flasch97/Gravity-Vehicle/Gravity Car Final 2/calculation arc.png

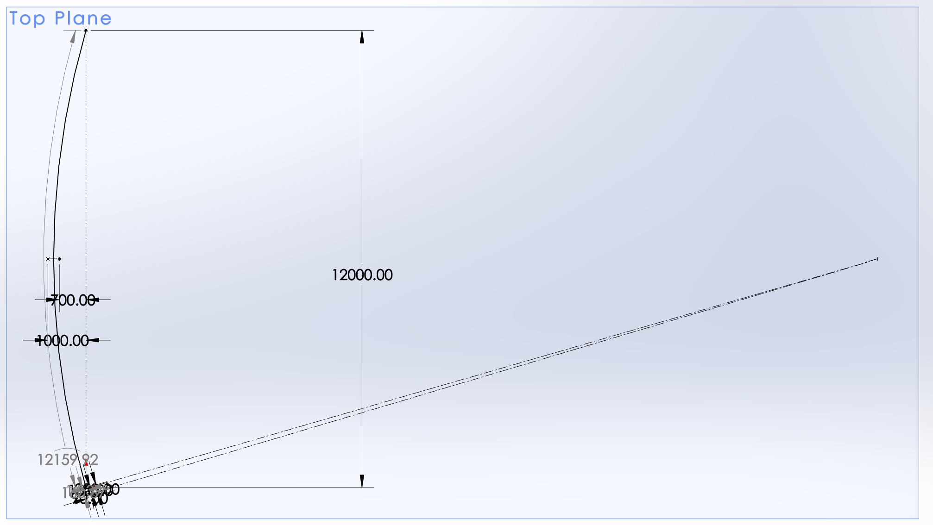
Gravity Car Final 2/calculation arc.png
