flasch97/Gravity-Vehicle/Gravity Car Final 2/calcualtion arc 2.PNG

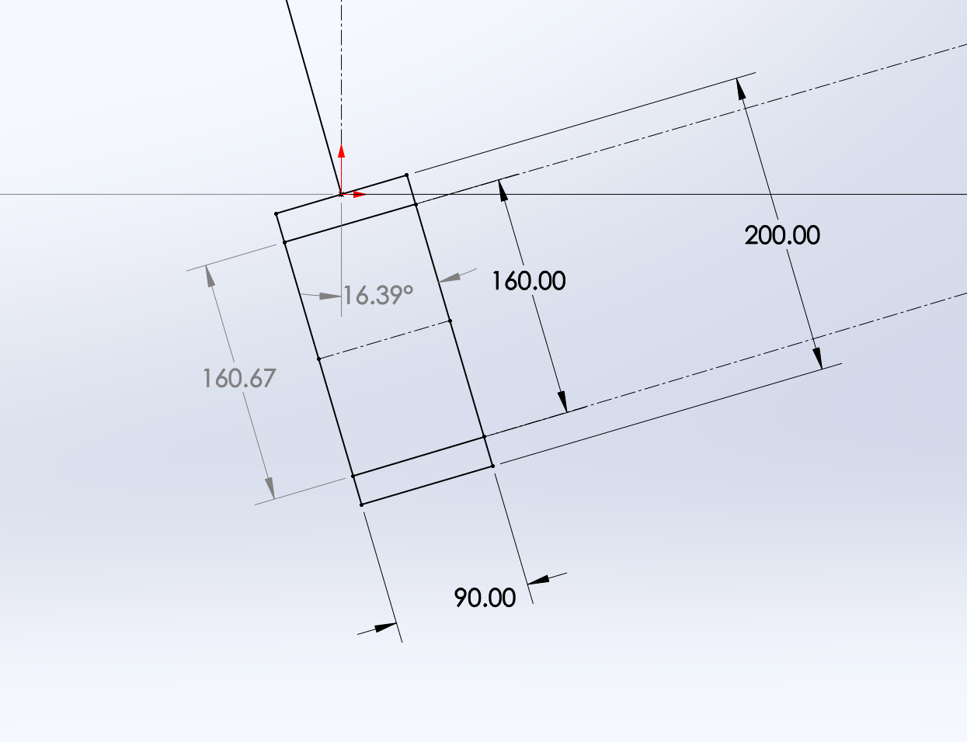
Gravity Car Final 2/calcualtion arc 2.PNG
