flasch97/Gravity-Vehicle/Gravity Car Final 1/FEA/PerformanceLog.txt

Number of Contacts: 0
Number of contact data: 0
