flasch97/Gravity-Vehicle/Gravity Car Final 2/FEA strain.png

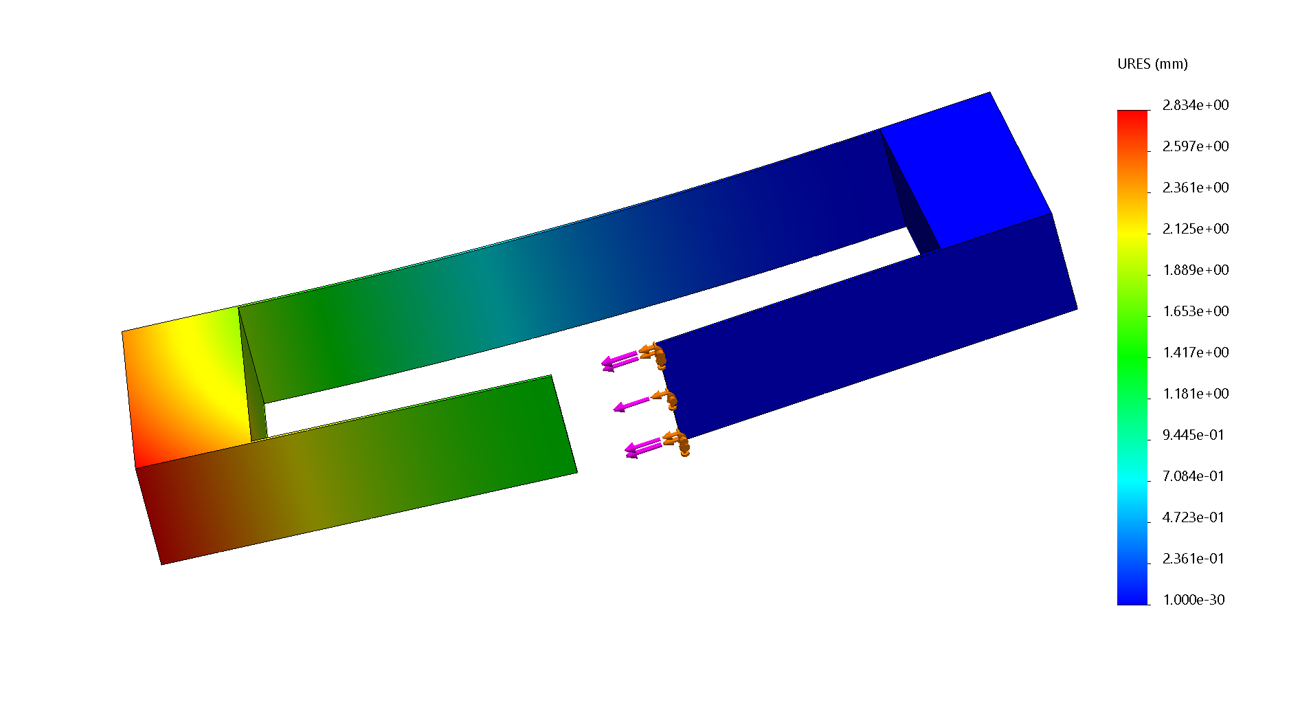
Gravity Car Final 2/FEA strain.png
