flasch97/Gravity-Vehicle/Gravity Car Final 2/FEA stress.PNG

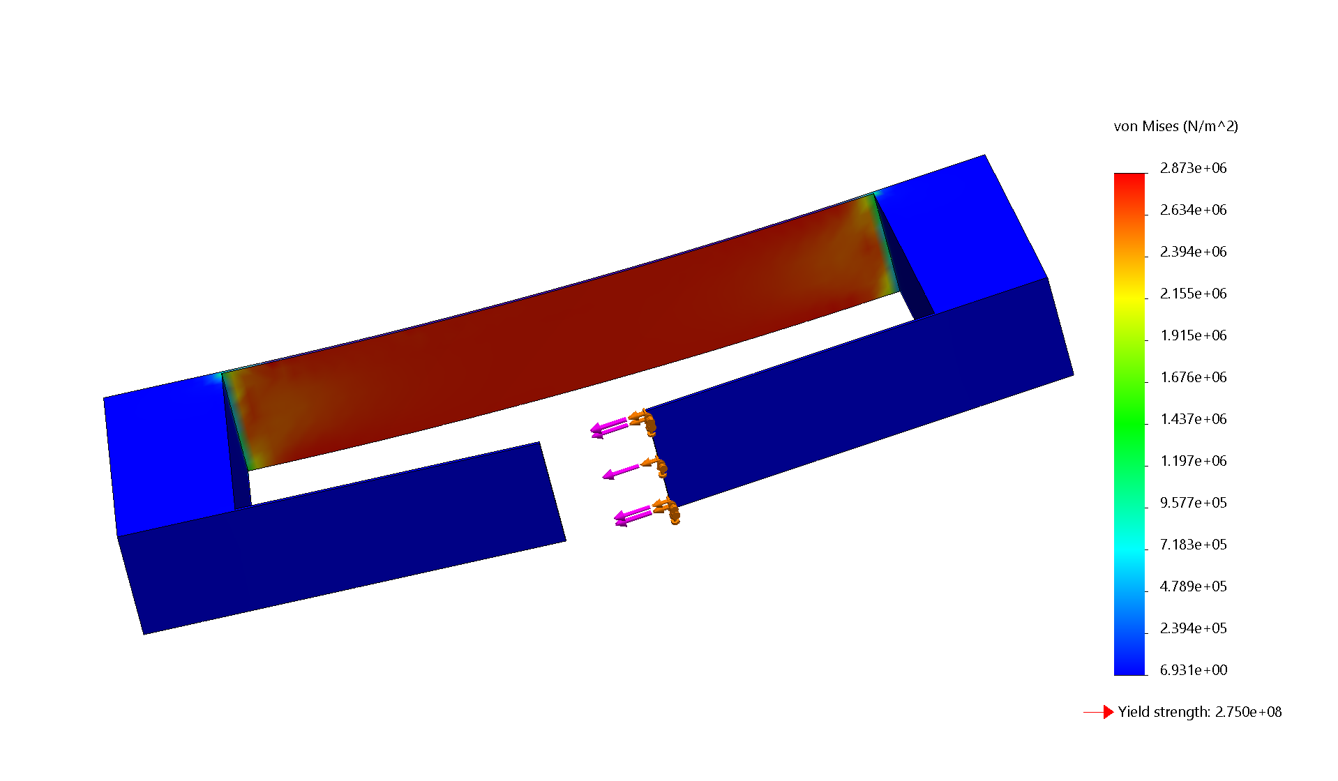
Gravity Car Final 2/FEA stress.PNG
