flasch97/Gravity-Vehicle/Gravity Car Final 2/Motion analysis.png

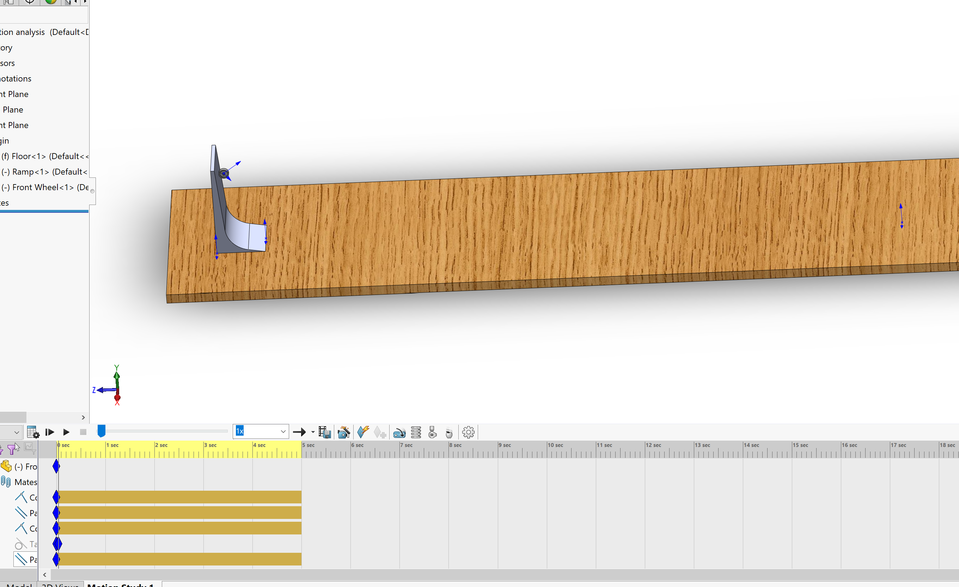
Gravity Car Final 2/Motion analysis.png
