flasch97/Gravity-Vehicle/Assembly car/Gravity car assembly (Split frame).SLDASM

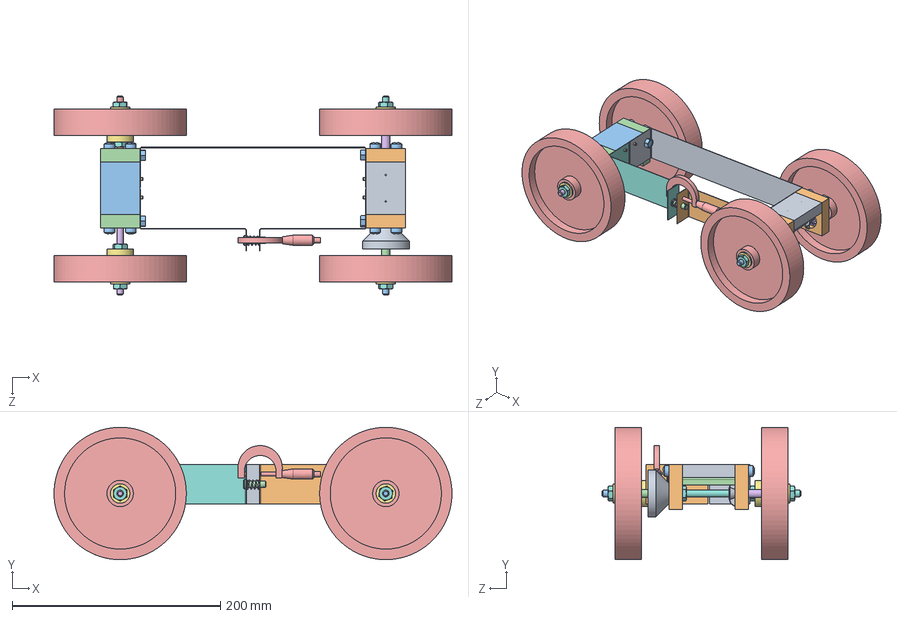
[picture p54: CAD file, 2019-11-20]
Assembly car/Gravity car assembly (Split frame).SLDASM
381.9 x 127.0 x 191.0 mm
Connection Front Suspention
suspension front x 2
fillister head screw_ai x 8
Slide Wing Nut
binding head screw_ai x 2
radial ball bearing_68_din x 3
muffle bearing x 2
threaded axle front
Adapter One-Way-Bearing
muffle one way bearing
threaded axle right wheel
muffle wheel right
Wheel x 4
muffle wheel left
flat washer type b regular_ai x 4
heavy hex jam nut_ai x 8
WING NUT 0.25 - 28
Frame 1 Front
Connection Rear Suspention
suspension rear x 2
threaded axle rear left
threaded axle rear right
muffle rear wheels x 2
Frame 1 Rear
Frame 2
dowel pin (hardened production)_ai x 4
hex screw_ai x 4
clevis pin_ai
micrometer
2022N161_MIL. SPEC. COMPRESSION SPRING
