flasch97/Gravity-Vehicle/Gravity Car Final 1/Assembly car/gravity car assembly.SLDASM

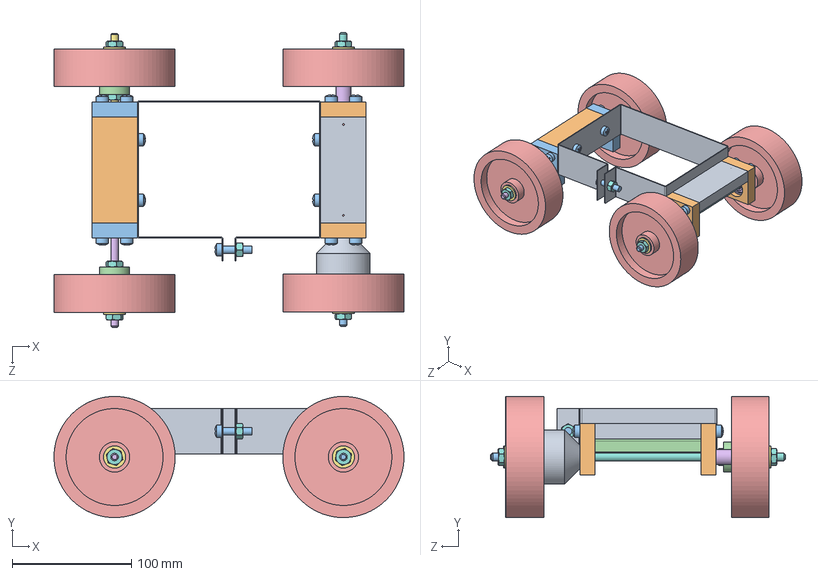
[picture p55: CAD file, 2019-11-04]
Gravity Car Final 1/Assembly car/gravity car assembly.SLDASM
293.5 x 101.6 x 247.1 mm
Connection Front Suspention
suspension front x 2
fillister head screw_ai x 13
Slide Wing Nut
binding head screw_ai x 2
radial ball bearing_68_din x 3
muffle bearing x 2
threaded axle front
Adapter One-Way-Bearing
muffle one way bearing
threaded axle right wheel
muffle wheel right
Front Wheel x 2
muffle wheel left
flat washer type b regular_ai x 4
heavy hex jam nut_ai x 6
Frame
Connection Rear Suspention
suspension rear x 2
muffle rear wheels x 2
Rear Wheel x 2
threaded axle rear right
threaded axle rear left
hex nut_ai
