flasch97/Gravity-Vehicle/Gravity Car Final 2/Motion Analysis/motion analysis.SLDASM

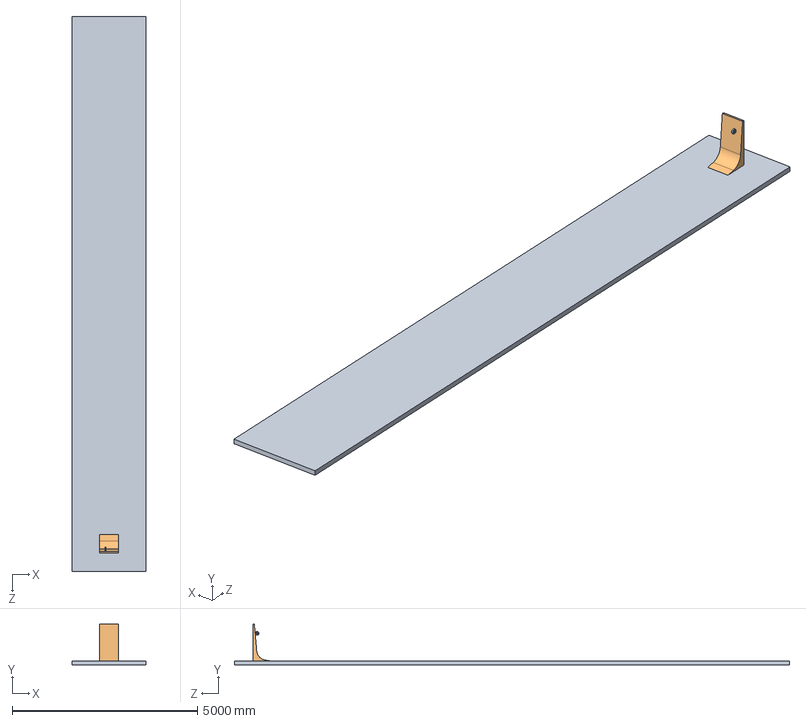
[picture p56: CAD file, 2019-11-22]
Gravity Car Final 2/Motion Analysis/motion analysis.SLDASM
2000.0 x 1101.6 x 15000.0 mm
Floor
Ramp
Front Wheel
