flasch97/Gravity-Vehicle/RampSight/Assemsight.SLDASM

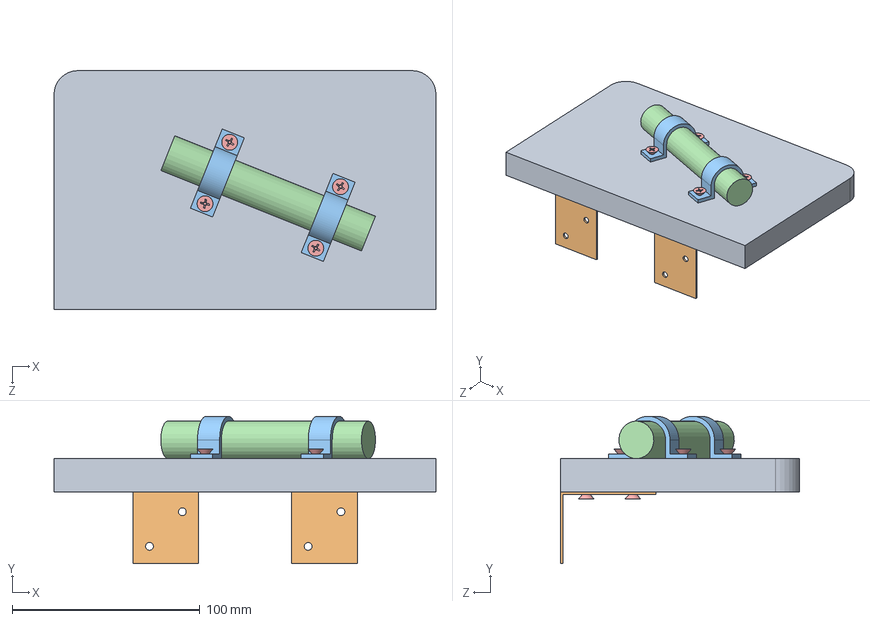
[picture p59: CAD file, 2019-12-05]
RampSight/Assemsight.SLDASM
203.2 x 78.4 x 127.0 mm
RampSight
screwangle x 2
LaserStrap x 2
laserpointereal
sightscrew x 8
