flasch97/Gravity-Vehicle/Motion Analysis/motion analysis.SLDASM

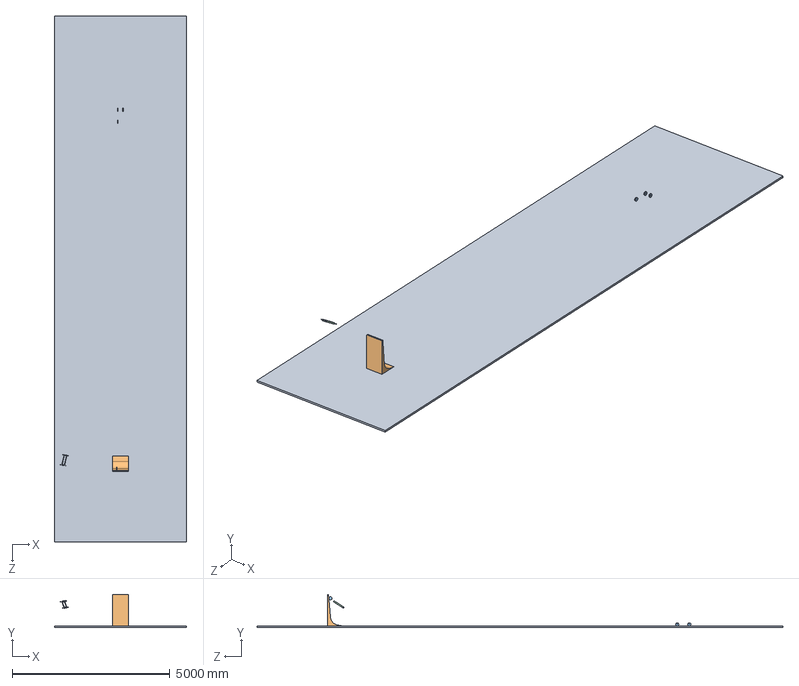
[picture p60: CAD file, 2019-12-02]
Motion Analysis/motion analysis.SLDASM
4194.1 x 1050.0 x 16654.9 mm
floor arc
Ramp
Front Wheel x 4
frame
