flasch97/Gravity-Vehicle/Ramp.SLDASM

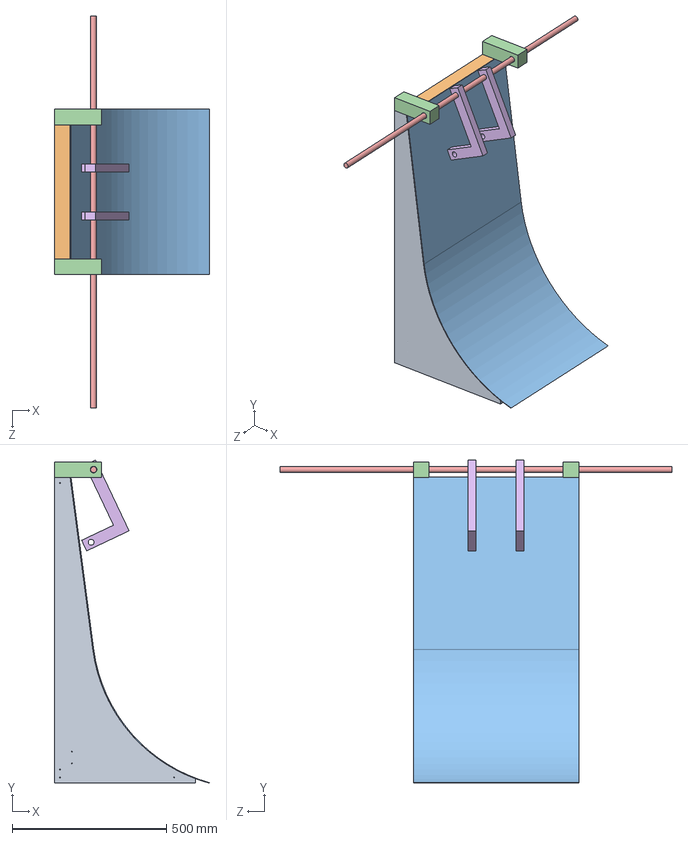
[picture p61: CAD file, 2019-11-13]
Ramp.SLDASM
503.0 x 1047.1 x 1270.0 mm
Ramp Right Side x 2
base support x 5
ramp top
Release support x 2
Release Dowel
RELEASE HOOK x 2
