flasch97/Gravity-Vehicle/Andrew's Files/Release Mechanism/Release Mechanism.SLDASM

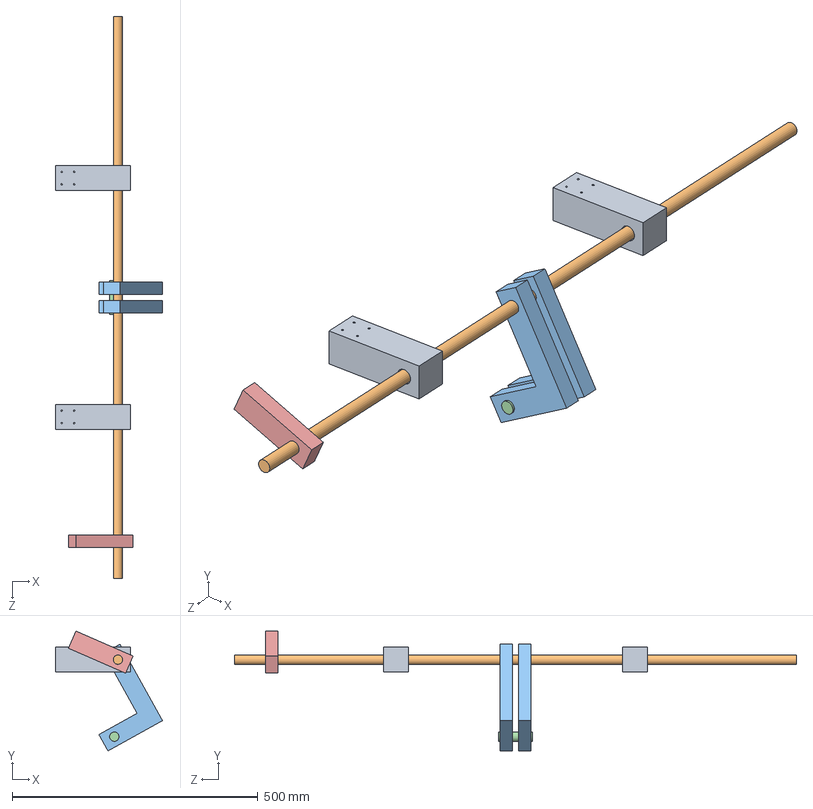
[picture p62: CAD file, 2019-12-05]
Andrew's Files/Release Mechanism/Release Mechanism.SLDASM
217.7 x 243.8 x 1143.0 mm
Release support x 2
Release Dowel
RELEASE HOOK x 2
Hook Dowel
Release Lever
