flasch97/Gravity-Vehicle/Gravity Car Final 2/Front Axle/Front Axle Assembly.SLDASM

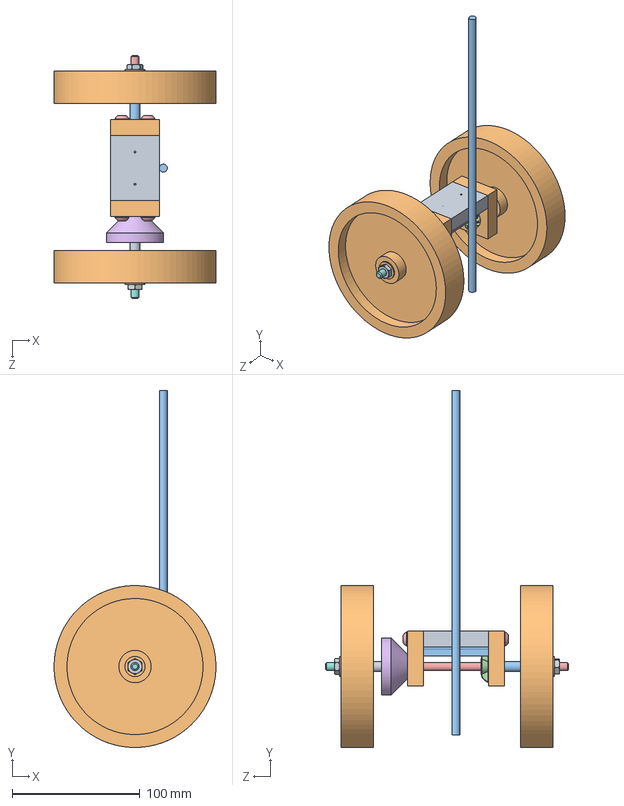
[picture p63: CAD file, 2019-11-21]
Gravity Car Final 2/Front Axle/Front Axle Assembly.SLDASM
127.0 x 280.0 x 190.9 mm
Connection Front Suspention
Suspension Front x 2
Slide Wing Nut
Muffle Bearing x 2
Threaded Axle Front Left
Adapter One-Way-Bearing
Muffle One-Way-Bearing
Threaded Axle Front Right
Muffle Wheel Right
Wheel x 2
Muffle Wheel Left
Wingnut
Button Head Hex Drive Screw 1-4-28 x 4
Button Head Hex Drive Screw 1-64 x 2
608 Ball Bearing x 2
One-Way-Bearing
Stainless Steel Thin Hex Nut 1-4-28 x 3
316 Stainless Steel Washer x 2
Wooden Rod
