flasch97/Gravity-Vehicle/Andrew's Files/Ramp/Ramp.SLDASM

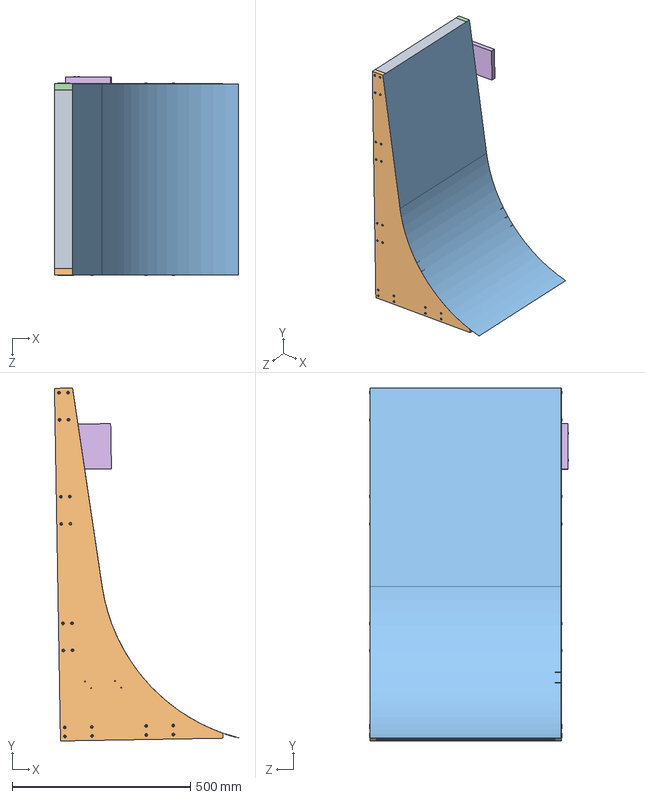
[picture p64: CAD file, 2019-12-05]
Andrew's Files/Ramp/Ramp.SLDASM
517.1 x 991.4 x 560.2 mm
base support x 5
Ramp Right Side
ramp top
Left Ramp Side
Smaller Wood Screw x 42
Position Marker
