flasch97/Gravity-Vehicle/Andrew's Files/Ramp/ramp top.SLDPRT

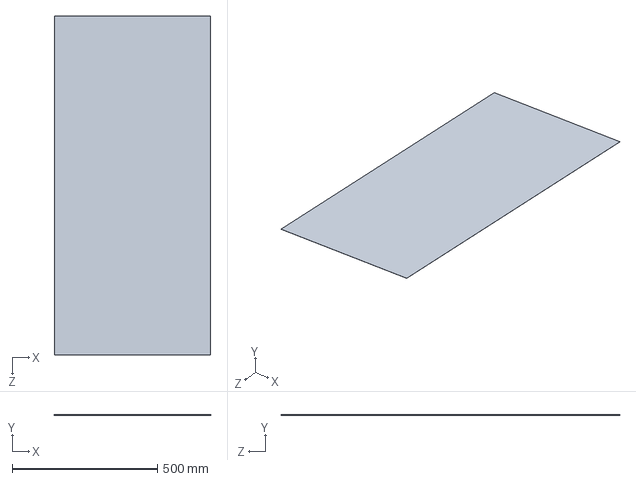
[picture p65: CAD file, 2019-12-05]
Andrew's Files/Ramp/ramp top.SLDPRT
536.4 x 0.317 x 1165.1 mm
