flasch97/Gravity-Vehicle/Andrew's Files/Release Mechanism/Release support.SLDPRT

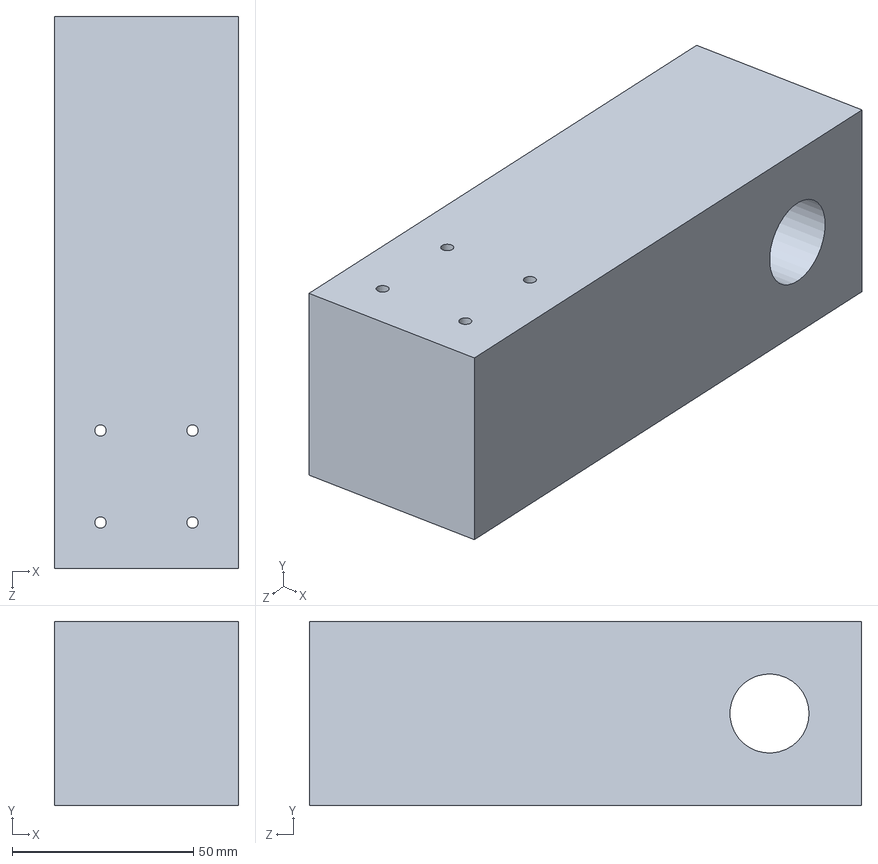
[picture p66: CAD file, 2019-12-05]
Andrew's Files/Release Mechanism/Release support.SLDPRT
50.8 x 50.8 x 152.4 mm
