flasch97/Gravity-Vehicle/Gravity Car Final 1/FEA/FEA.SLDPRT

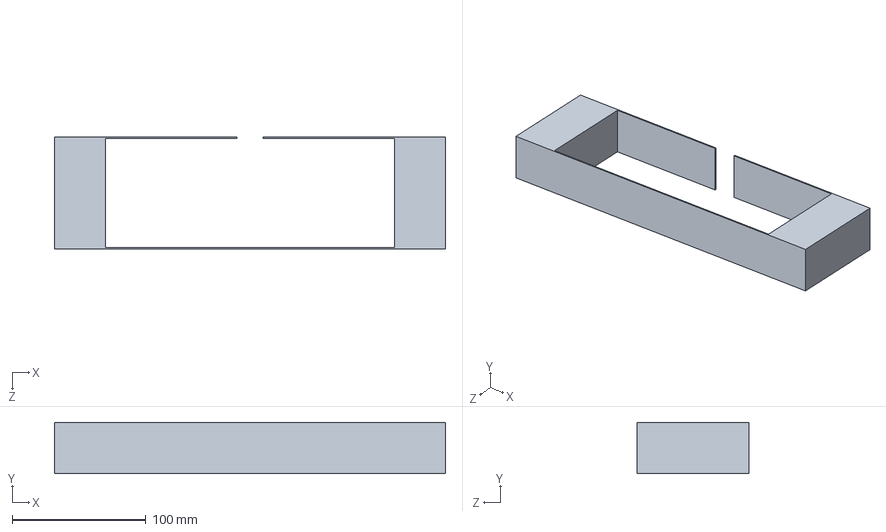
[picture p67: CAD file, 2019-11-20]
Gravity Car Final 1/FEA/FEA.SLDPRT
292.1 x 38.1 x 83.3 mm
