flasch97/Gravity-Vehicle/Gravity Car Final 2/Ramp left side/Side Ramp.SLDPRT

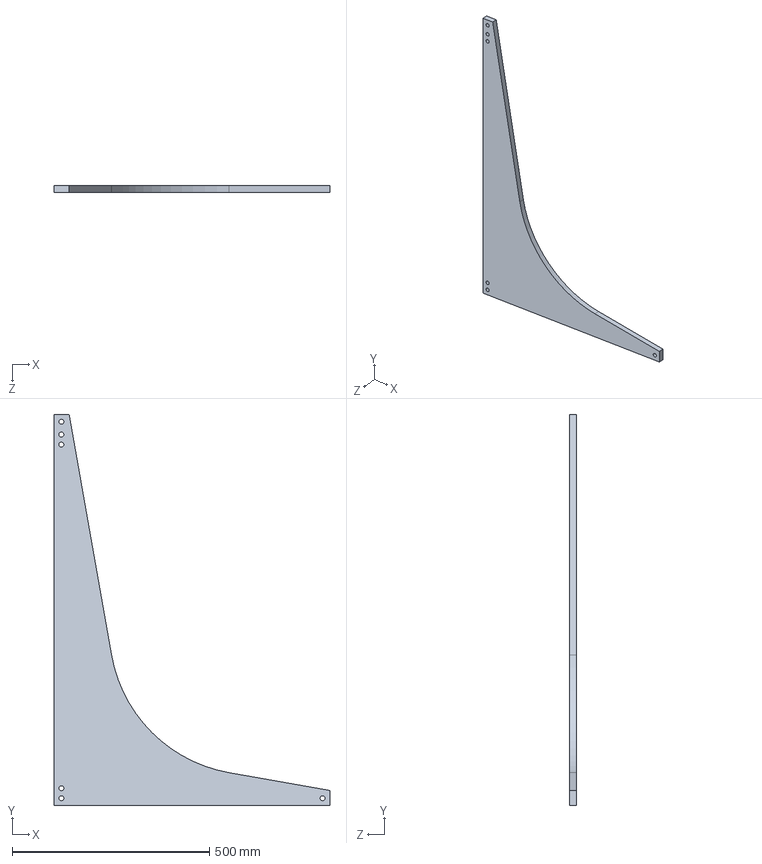
[picture p68: CAD file, 2019-11-06]
Gravity Car Final 2/Ramp left side/Side Ramp.SLDPRT
698.5 x 990.6 x 18.3 mm
