flasch97/Gravity-Vehicle/Gravity Car Final 2/Split frame/Compression Spring.SLDPRT

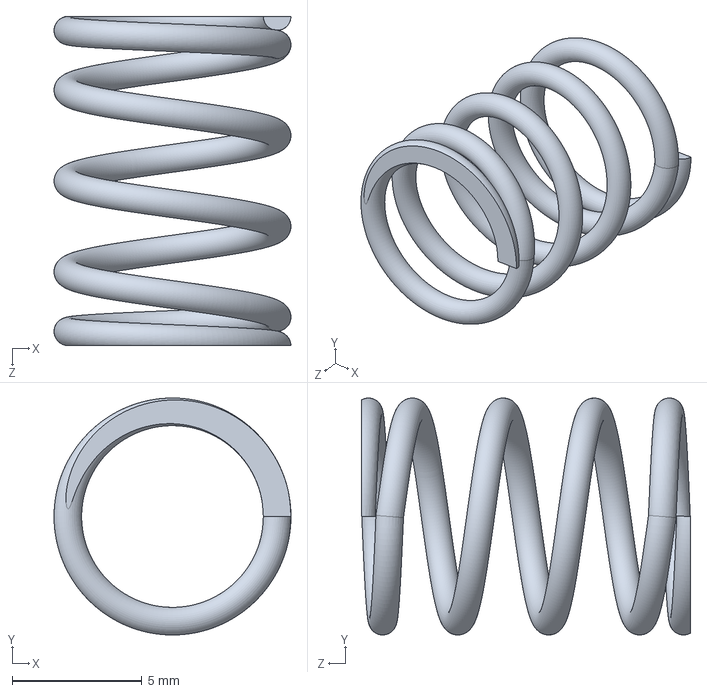
[picture p69: CAD file, 2019-11-22]
Gravity Car Final 2/Split frame/Compression Spring.SLDPRT
9.14 x 9.14 x 12.7 mm
