flasch97/Gravity-Vehicle/Motion Analysis/calculation arc.SLDPRT

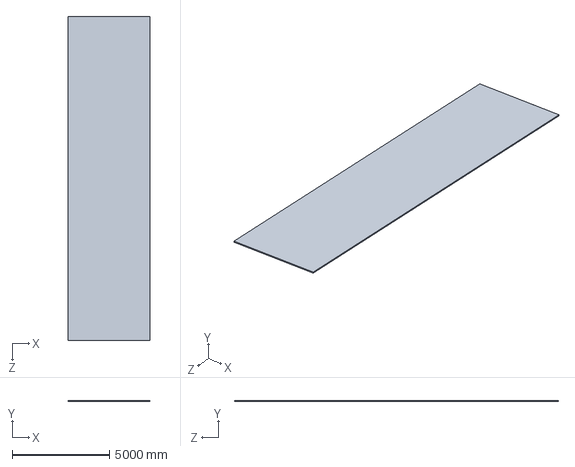
[picture p70: CAD file, 2019-12-02]
Motion Analysis/calculation arc.SLDPRT
4194.1 x 50.0 x 16654.9 mm
