flasch97/Gravity-Vehicle/Andrew's Files/Ramp/Ramp Right Side.SLDPRT

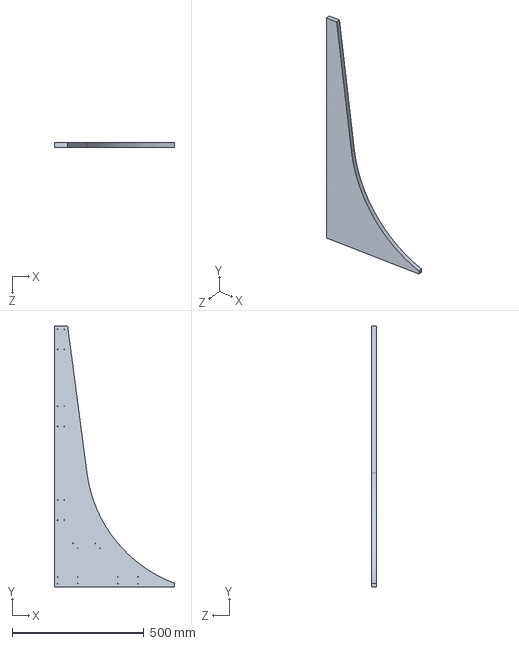
[picture p71: CAD file, 2019-12-05]
Andrew's Files/Ramp/Ramp Right Side.SLDPRT
457.2 x 990.6 x 18.3 mm
