flasch97/Gravity-Vehicle/Andrew's Files/Release Mechanism/RELEASE HOOK.SLDPRT

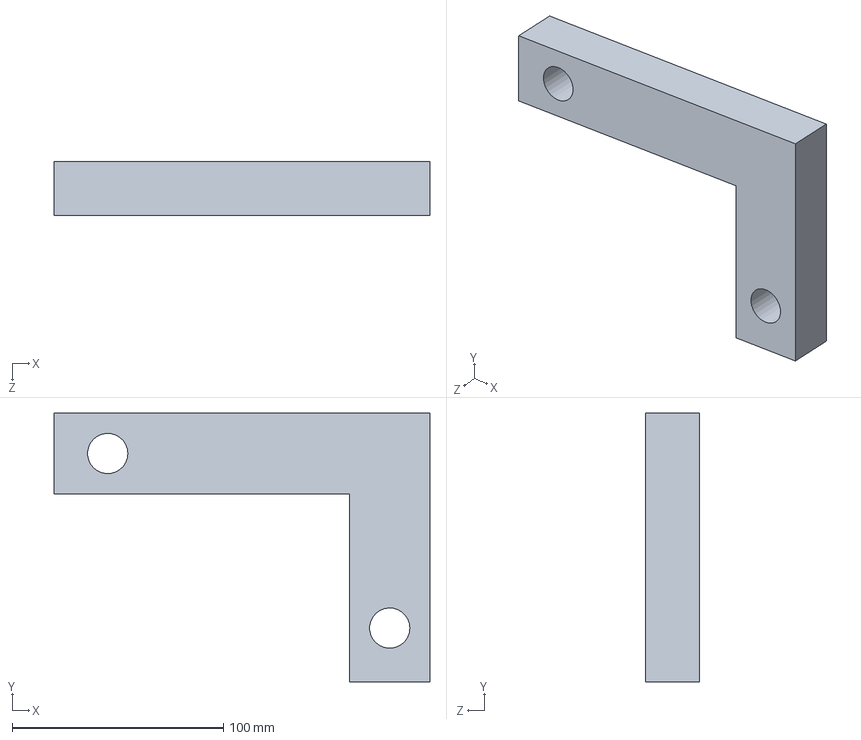
[picture p72: CAD file, 2019-12-05]
Andrew's Files/Release Mechanism/RELEASE HOOK.SLDPRT
177.8 x 127.0 x 25.4 mm
