flasch97/Gravity-Vehicle/Gravity Car Final 2/Front Axle/Compression Spring Break.SLDPRT

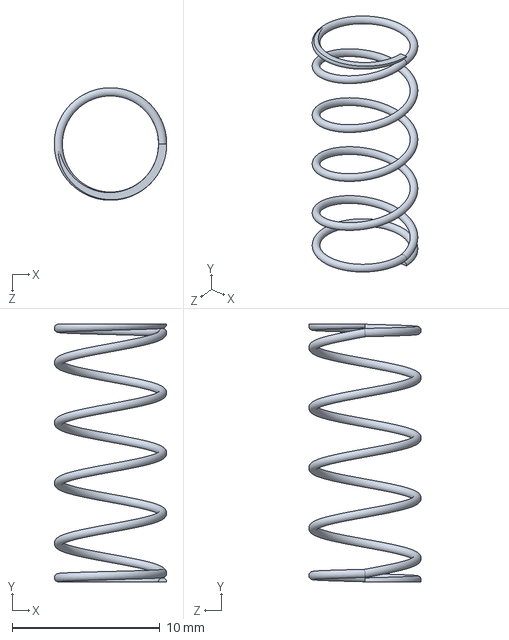
[picture p73: CAD file, 2019-12-04]
Gravity Car Final 2/Front Axle/Compression Spring Break.SLDPRT
7.62 x 17.5 x 7.62 mm
