flasch97/Gravity-Vehicle/Gravity Car Final 2/Motion Analysis/Floor.SLDPRT

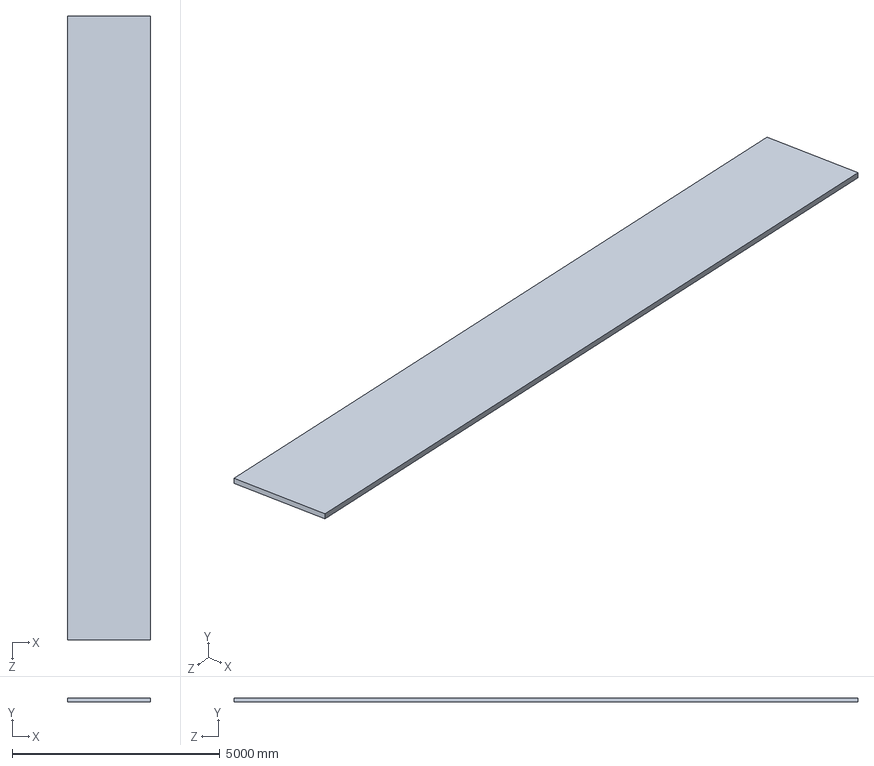
[picture p74: CAD file, 2019-11-10]
Gravity Car Final 2/Motion Analysis/Floor.SLDPRT
2000.0 x 101.6 x 15000.0 mm
