flasch97/Gravity-Vehicle/Gravity Car Final 2/Rear Axle/threaded axle rear right.SLDPRT

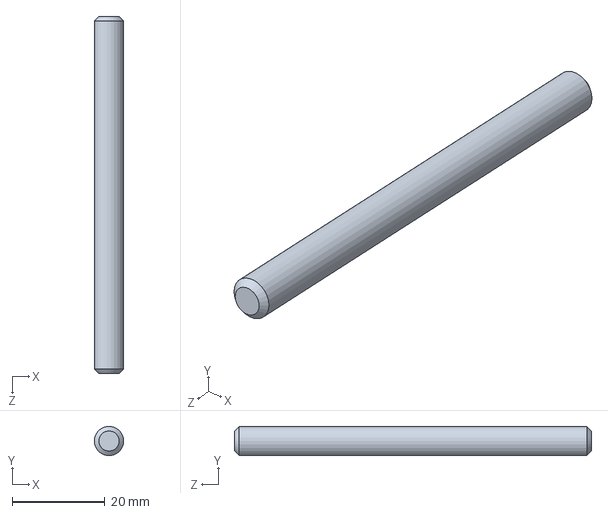
[picture p75: CAD file, 2019-11-22]
Gravity Car Final 2/Rear Axle/threaded axle rear right.SLDPRT
6.35 x 6.30 x 77.1 mm
