flasch97/Gravity-Vehicle/Gravity Car Final 2/Split frame/Dovel Pin.SLDPRT

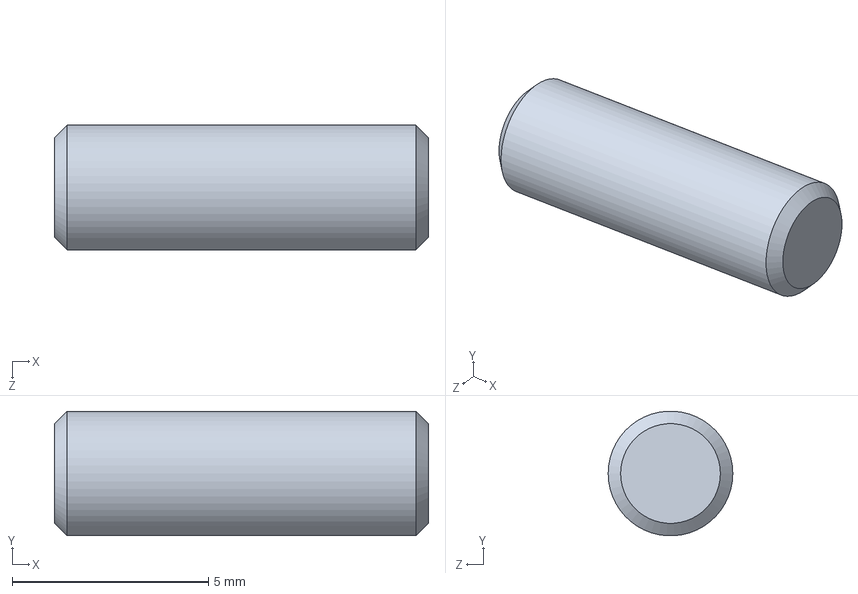
[picture p76: CAD file, 2019-11-22]
Gravity Car Final 2/Split frame/Dovel Pin.SLDPRT
9.52 x 3.17 x 3.17 mm
