flasch97/Gravity-Vehicle/laserpointereal.SLDPRT

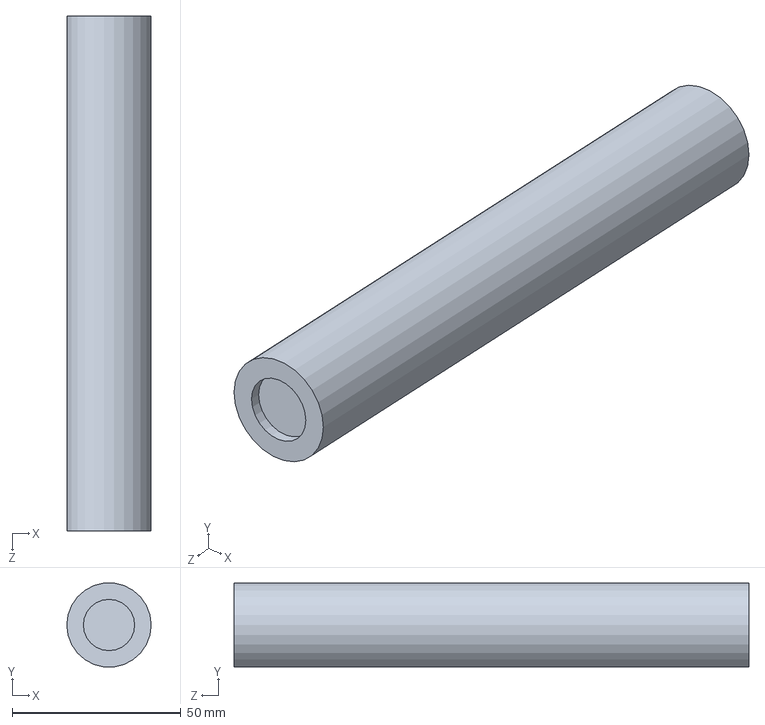
[picture p77: CAD file, 2019-11-17]
laserpointereal.SLDPRT
25.0 x 24.8 x 152.5 mm
