flasch97/Gravity-Vehicle/Rear Axle/threaded axle rear left.SLDPRT

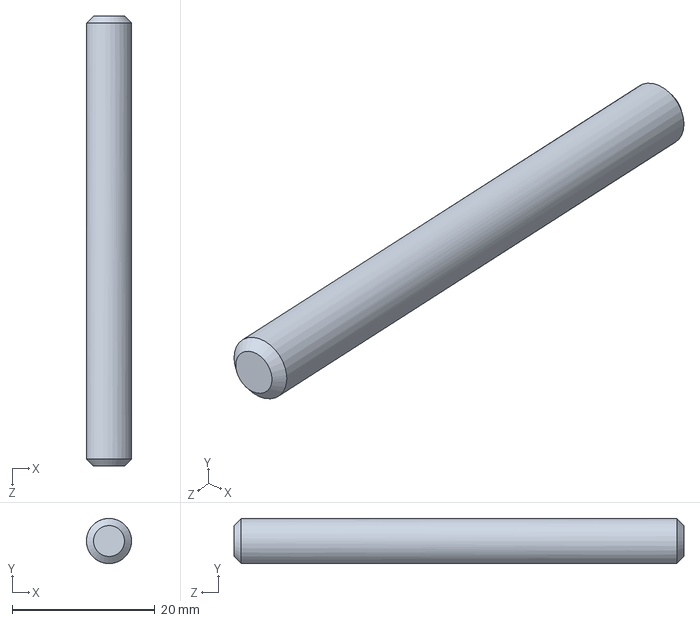
[picture p78: CAD file, 2019-11-17]
Rear Axle/threaded axle rear left.SLDPRT
6.35 x 6.34 x 63.1 mm
