flasch97/Gravity-Vehicle/Andrew's Files/Release Mechanism/Release Lever.SLDPRT

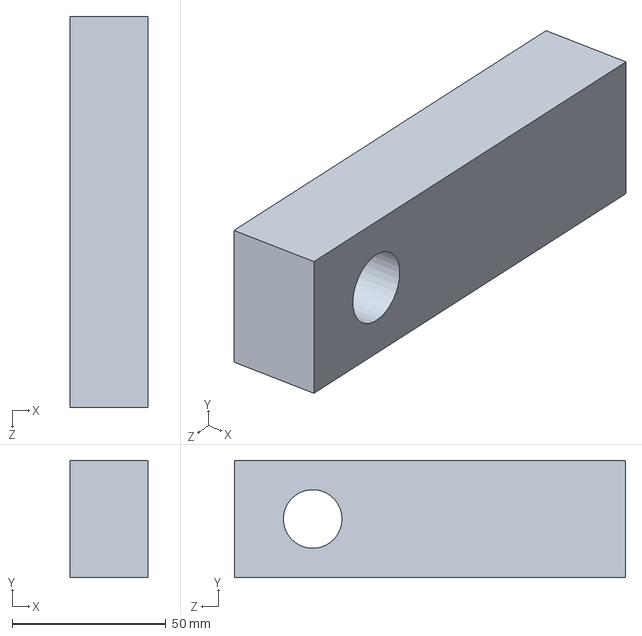
[picture p79: CAD file, 2019-12-05]
Andrew's Files/Release Mechanism/Release Lever.SLDPRT
25.4 x 38.1 x 127.0 mm
