flasch97/Gravity-Vehicle/Gravity Car Final 2/Motion Analysis/Ramp.SLDPRT

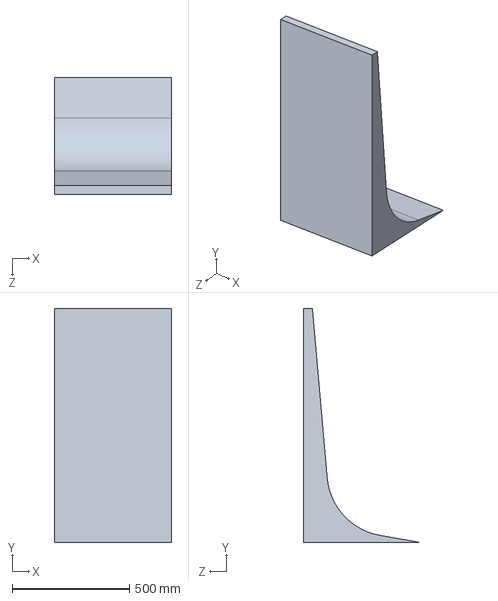
[picture p80: CAD file, 2019-11-10]
Gravity Car Final 2/Motion Analysis/Ramp.SLDPRT
500.0 x 1000.0 x 500.0 mm
