flasch97/Gravity-Vehicle/Gravity Car Final 2/Rear Axle/suspension rear.SLDPRT

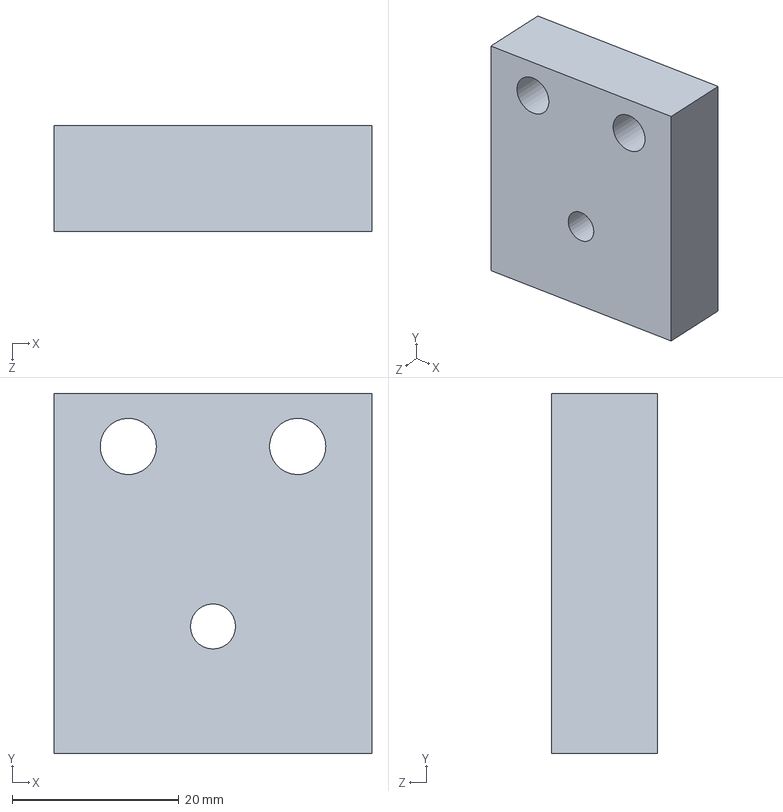
[picture p81: CAD file, 2019-11-22]
Gravity Car Final 2/Rear Axle/suspension rear.SLDPRT
38.1 x 43.2 x 12.7 mm
