flasch97/Gravity-Vehicle/Gravity Car Final 2/Split frame/Frame 2.SLDPRT

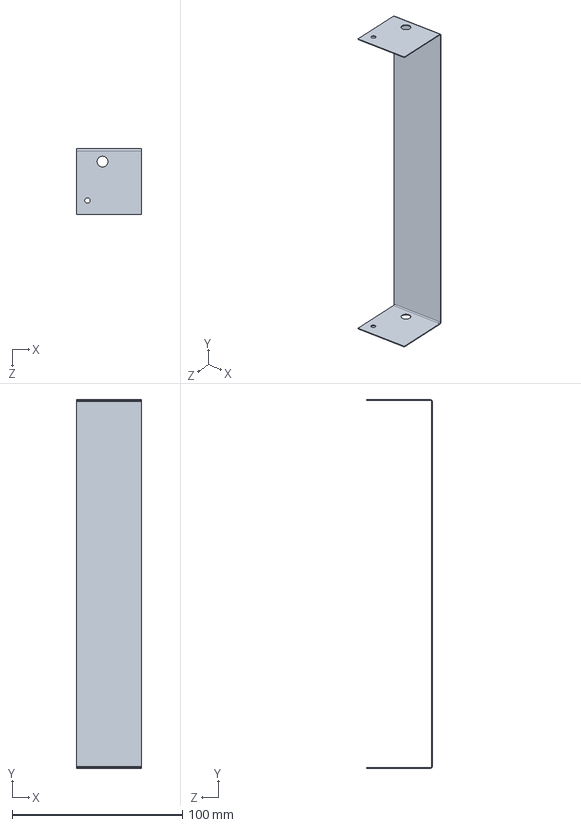
[picture p82: CAD file, 2019-11-22]
Gravity Car Final 2/Split frame/Frame 2.SLDPRT
38.1 x 216.8 x 38.6 mm
