flasch97/Gravity-Vehicle/Motion Analysis/Front Wheel.SLDPRT

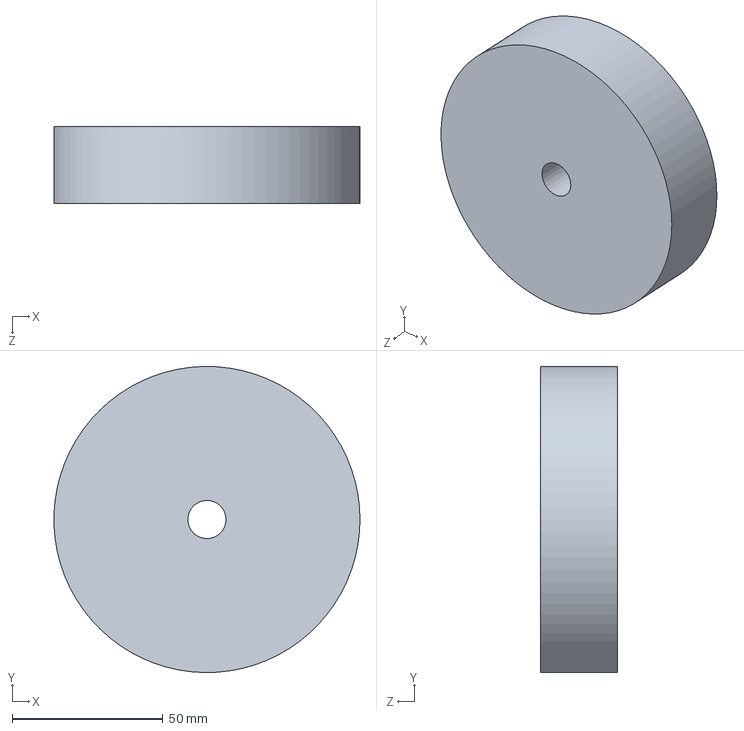
[picture p83: CAD file, 2019-12-02]
Motion Analysis/Front Wheel.SLDPRT
101.6 x 101.6 x 25.4 mm
