flasch97/Gravity-Vehicle/RampSight.SLDPRT

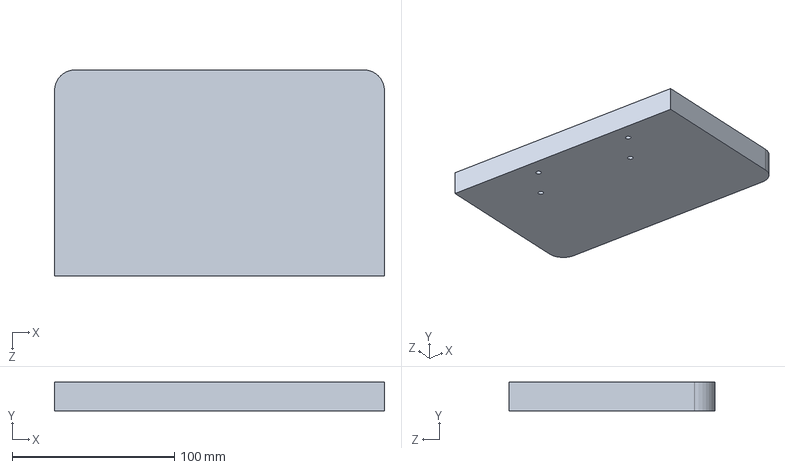
[picture p84: CAD file, 2019-11-17]
RampSight.SLDPRT
203.2 x 17.8 x 127.0 mm
