flasch97/Gravity-Vehicle/RampSight/laserpointereal.SLDPRT

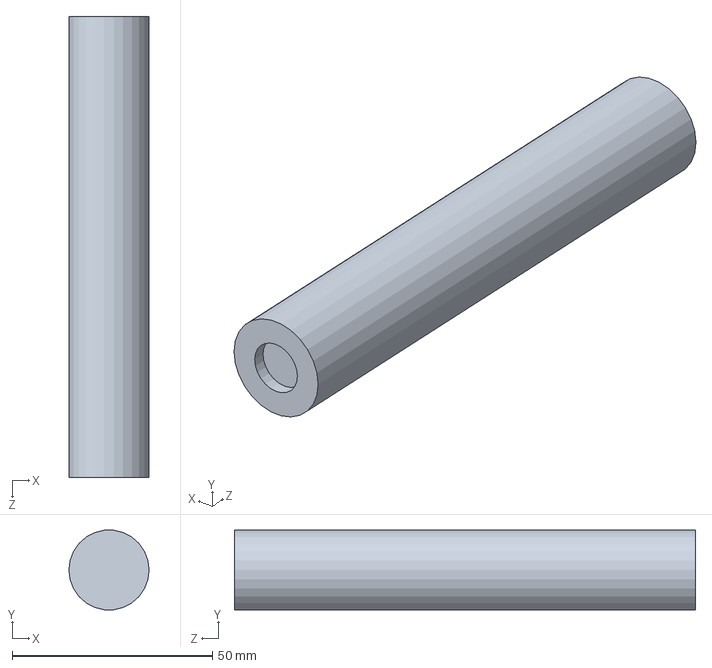
[picture p85: CAD file, 2019-11-20]
RampSight/laserpointereal.SLDPRT
20.0 x 19.9 x 115.0 mm
