flasch97/Gravity-Vehicle/Andrew's Files/Ramp/Position Marker.SLDPRT

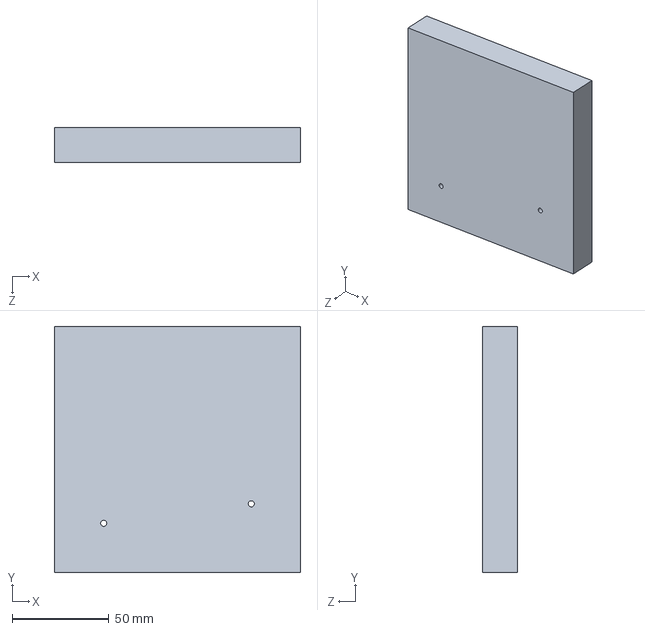
[picture p86: CAD file, 2019-12-05]
Andrew's Files/Ramp/Position Marker.SLDPRT
127.0 x 127.0 x 18.3 mm
