flasch97/Gravity-Vehicle/Andrew's Files/Release Mechanism/Hook Dowel.SLDPRT

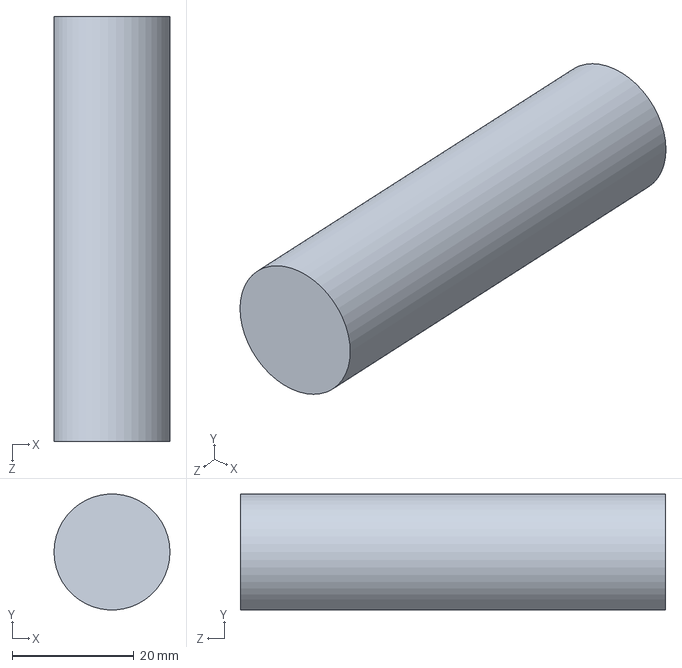
[picture p87: CAD file, 2019-12-05]
Andrew's Files/Release Mechanism/Hook Dowel.SLDPRT
19.1 x 19.0 x 69.8 mm
