flasch97/Gravity-Vehicle/Gravity Car Final 2/Front Axle/Hardware Parts/BALL BEARING.SLDPRT

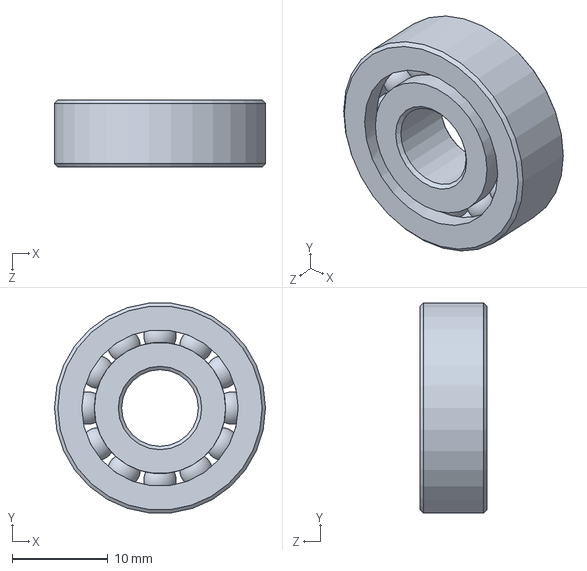
[picture p88: CAD file, 2019-11-21]
Gravity Car Final 2/Front Axle/Hardware Parts/BALL BEARING.SLDPRT
22.0 x 21.9 x 7.00 mm
