flasch97/Gravity-Vehicle/Gravity Car Final 2/Motion Analysis/Front Wheel.SLDPRT

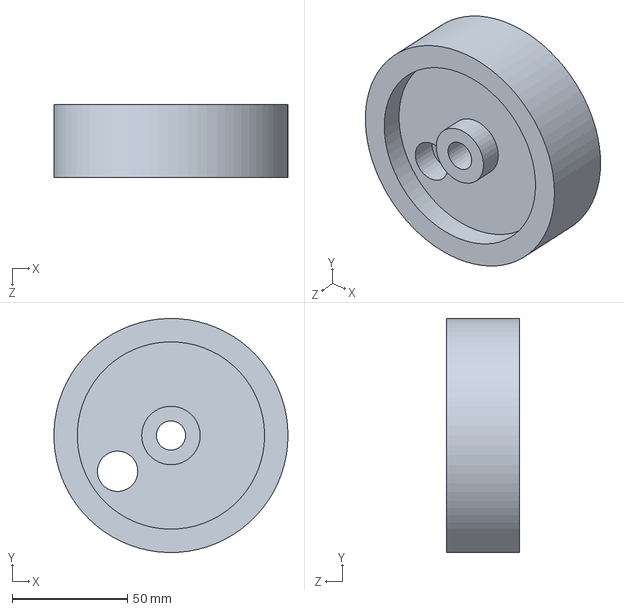
[picture p89: CAD file, 2019-11-10]
Gravity Car Final 2/Motion Analysis/Front Wheel.SLDPRT
101.6 x 101.6 x 31.8 mm
