flasch97/Gravity-Vehicle/Gravity Car Final 2/Rear Axle/Connection Rear Suspention.SLDPRT

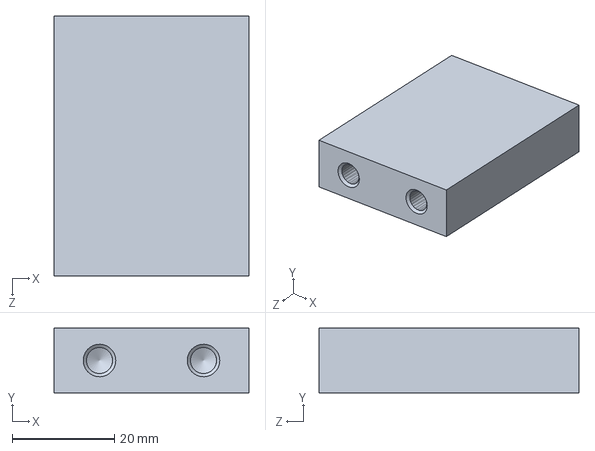
[picture p90: CAD file, 2019-11-22]
Gravity Car Final 2/Rear Axle/Connection Rear Suspention.SLDPRT
38.1 x 12.7 x 50.8 mm
