flasch97/Gravity-Vehicle/Gravity Car Final 2/Split frame/Frame 1 Front.SLDPRT

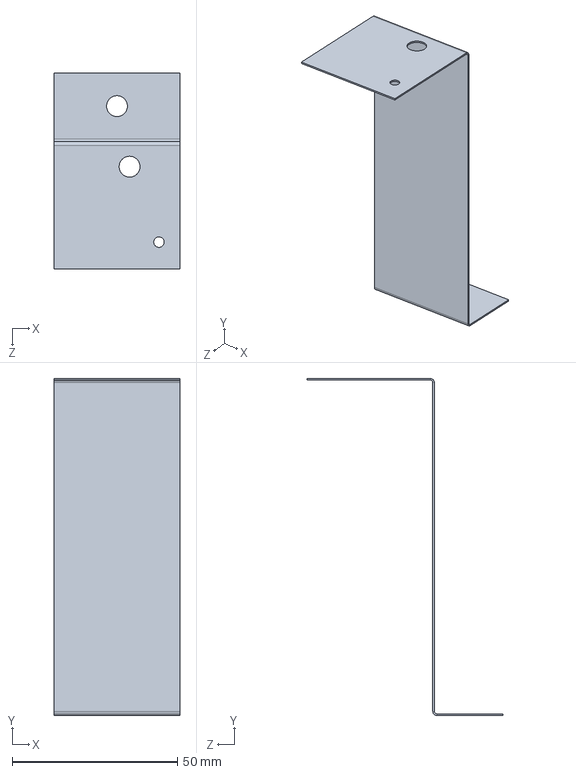
[picture p91: CAD file, 2019-11-22]
Gravity Car Final 2/Split frame/Frame 1 Front.SLDPRT
38.1 x 102.1 x 59.3 mm
