flasch97/Gravity-Vehicle/Rear Axle/muffle rear wheels.SLDPRT

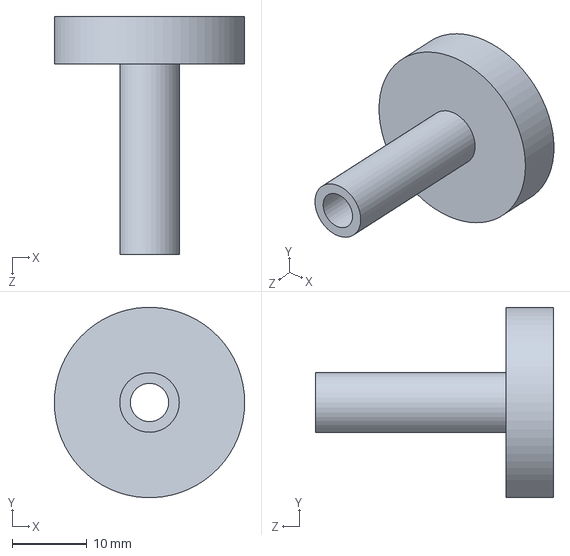
[picture p92: CAD file, 2019-11-17]
Rear Axle/muffle rear wheels.SLDPRT
25.4 x 25.4 x 31.8 mm
