flasch97/Gravity-Vehicle/Andrew's Files/Ramp/base support.SLDPRT

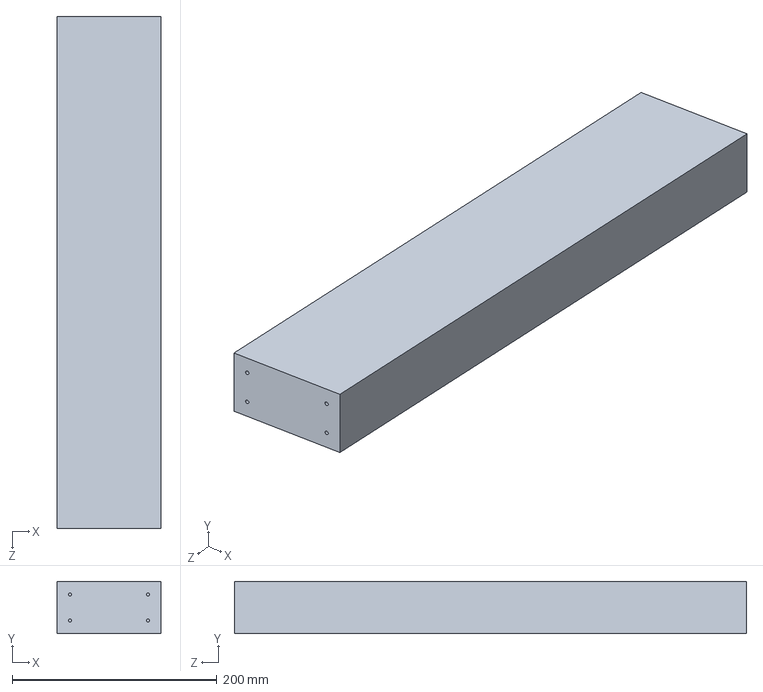
[picture p93: CAD file, 2019-12-05]
Andrew's Files/Ramp/base support.SLDPRT
101.6 x 50.8 x 500.0 mm
