flasch97/Gravity-Vehicle/Gravity Car Final 2/Front Axle/Hardware Parts/WAY LOCKING BALL BEARING CLUTCH.SLDPRT

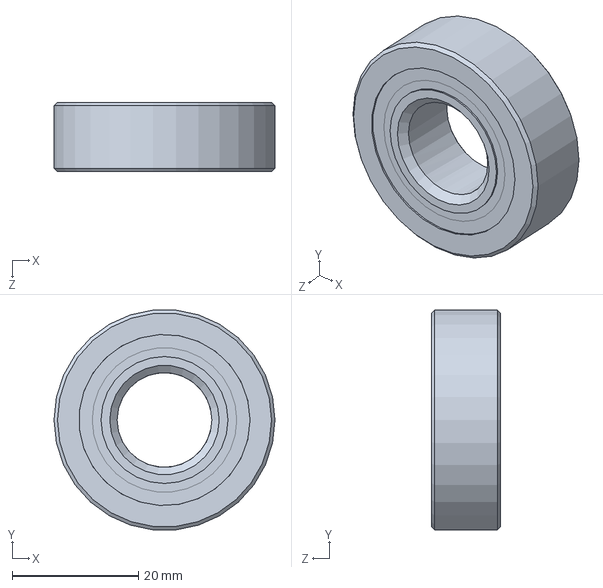
[picture p94: CAD file, 2019-11-21]
Gravity Car Final 2/Front Axle/Hardware Parts/WAY LOCKING BALL BEARING CLUTCH.SLDPRT
35.0 x 34.8 x 11.0 mm
