flasch97/Gravity-Vehicle/Gravity Car Final 2/Split frame/micrometer.SLDPRT

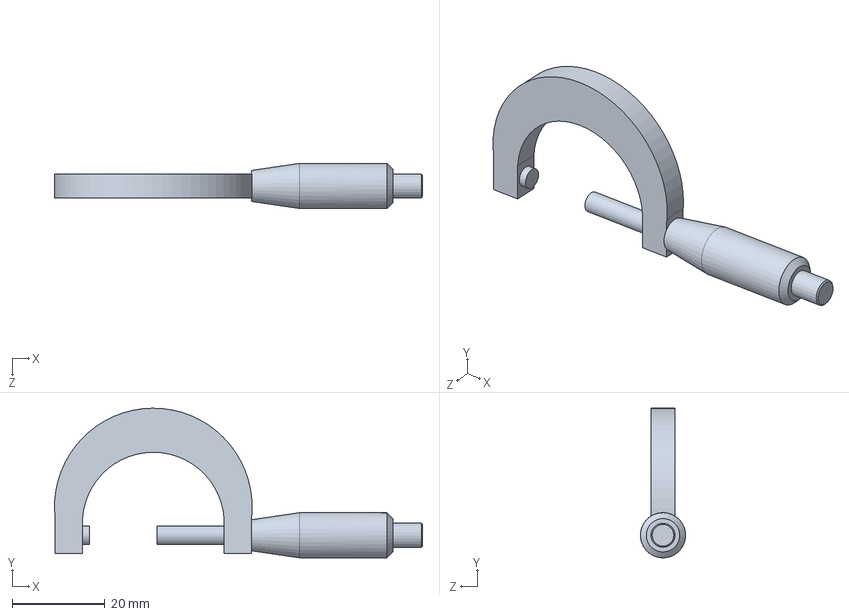
[picture p95: CAD file, 2019-11-22]
Gravity Car Final 2/Split frame/micrometer.SLDPRT
79.2 x 32.2 x 9.73 mm
