flasch97/Gravity-Vehicle/Motion Analysis/frame.SLDPRT

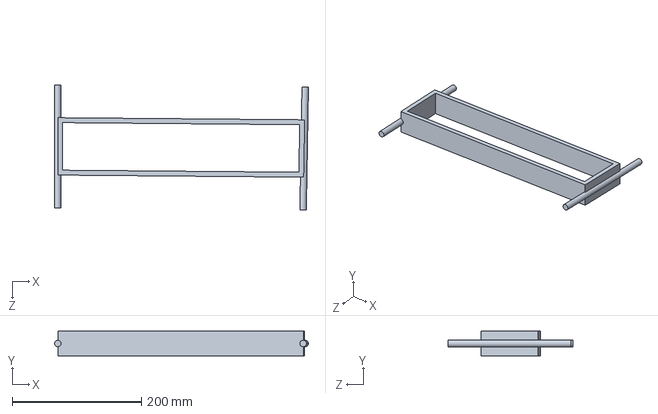
[picture p96: CAD file, 2019-12-02]
Motion Analysis/frame.SLDPRT
393.5 x 38.1 x 193.8 mm
