flasch97/Gravity-Vehicle/ramp top.SLDPRT

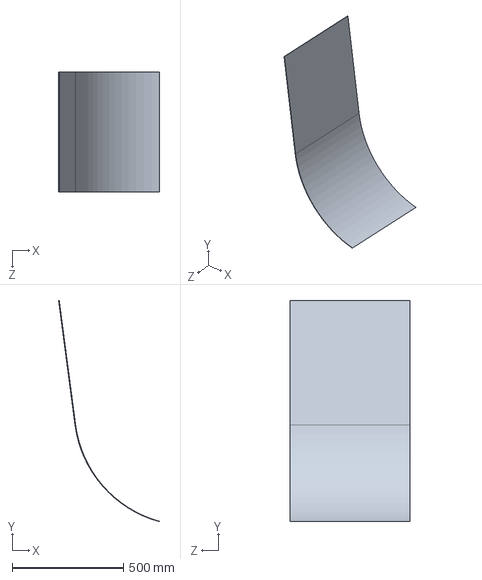
[picture p97: CAD file, 2019-11-13]
ramp top.SLDPRT
452.2 x 991.5 x 536.4 mm
