flasch97/Gravity-Vehicle/RampSight/LaserStrap.SLDPRT

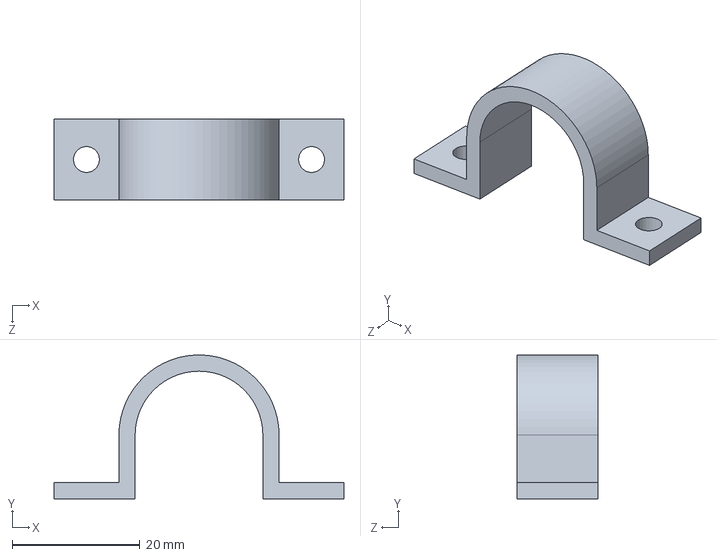
[picture p98: CAD file, 2019-11-20]
RampSight/LaserStrap.SLDPRT
45.4 x 22.5 x 12.7 mm
