flasch97/Gravity-Vehicle/Andrew's Files/Release Mechanism/Release Dowel.SLDPRT

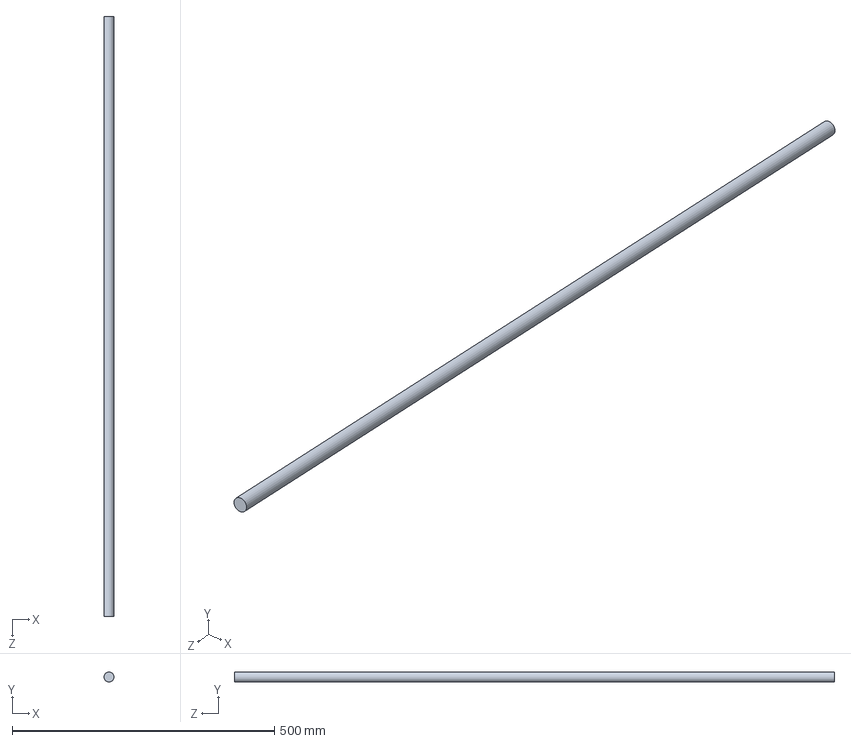
[picture p99: CAD file, 2019-12-05]
Andrew's Files/Release Mechanism/Release Dowel.SLDPRT
19.1 x 19.1 x 1143.0 mm
