flasch97/Gravity-Vehicle/Gravity Car Final 2/Split frame/Clevis Pin.SLDPRT

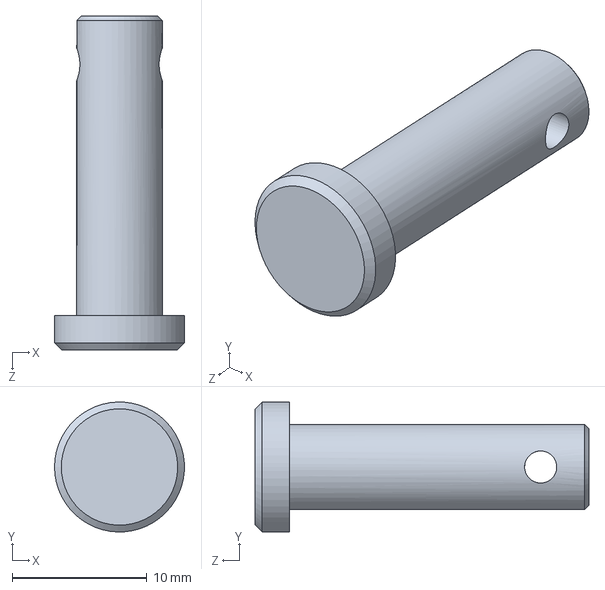
[picture p100: CAD file, 2019-11-22]
Gravity Car Final 2/Split frame/Clevis Pin.SLDPRT
9.65 x 9.65 x 24.8 mm
