flasch97/Gravity-Vehicle/Rear Axle/Rear Wheel.SLDPRT

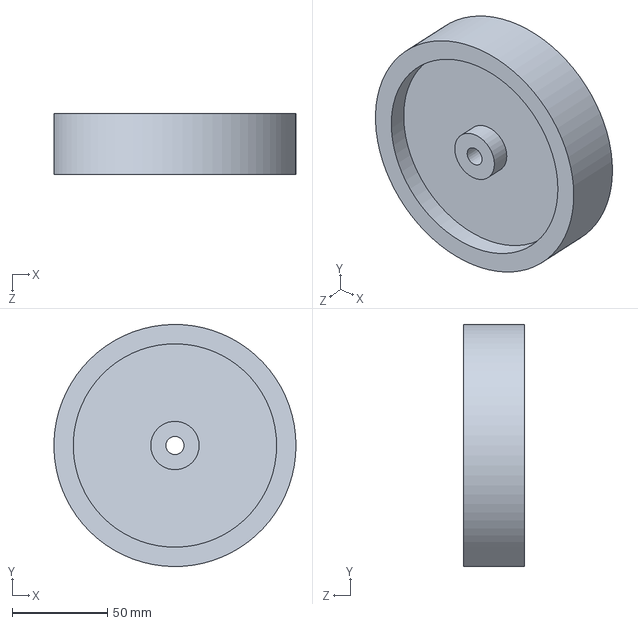
[picture p101: CAD file, 2019-11-17]
Rear Axle/Rear Wheel.SLDPRT
126.9 x 127.0 x 31.8 mm
