flasch97/Gravity-Vehicle/Release Dowel.SLDPRT

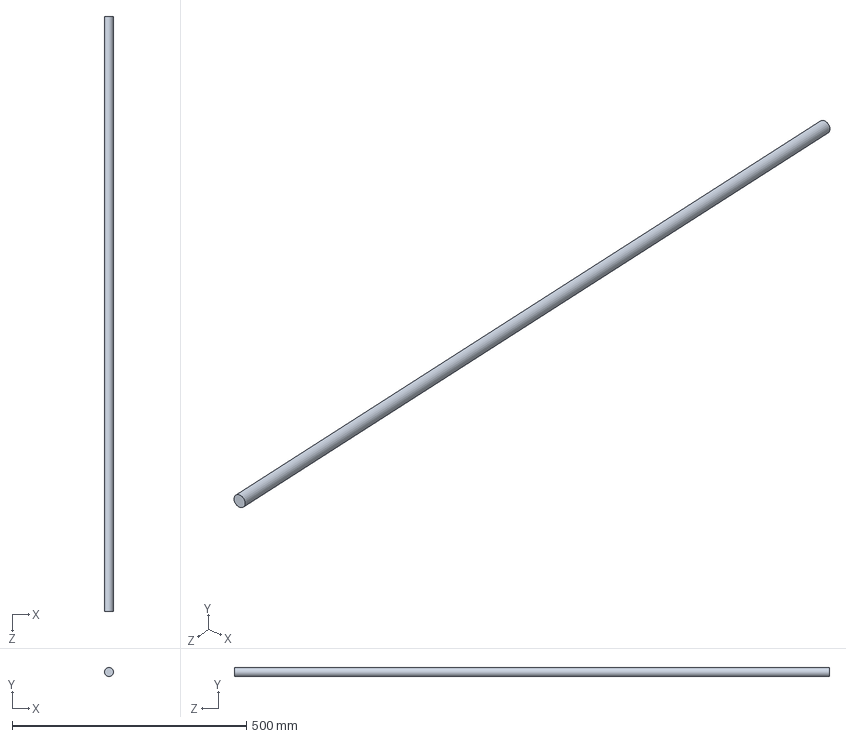
[picture p102: CAD file, 2019-11-13]
Release Dowel.SLDPRT
19.1 x 19.1 x 1270.0 mm
