flasch97/Gravity-Vehicle/base support.SLDPRT

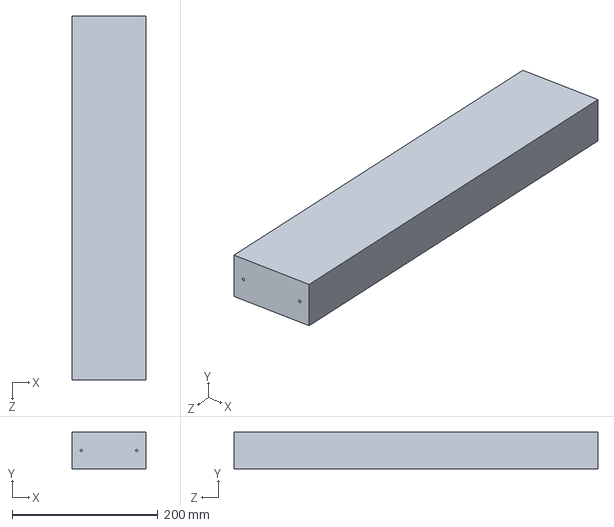
[picture p103: CAD file, 2019-11-13]
base support.SLDPRT
101.6 x 50.8 x 500.0 mm
