flasch97/Gravity-Vehicle/Gravity Car Final 2/Front Axle/Wooden Rod.SLDPRT

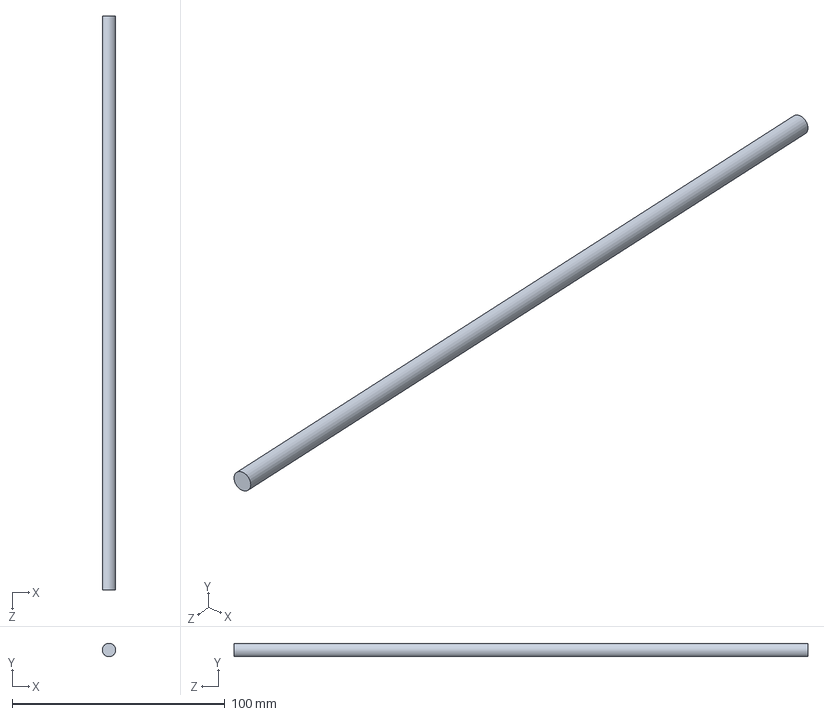
[picture p104: CAD file, 2019-11-21]
Gravity Car Final 2/Front Axle/Wooden Rod.SLDPRT
6.35 x 6.35 x 270.0 mm
