flasch97/Gravity-Vehicle/Gravity Car Final 2/Rear Axle/Wheel.SLDPRT

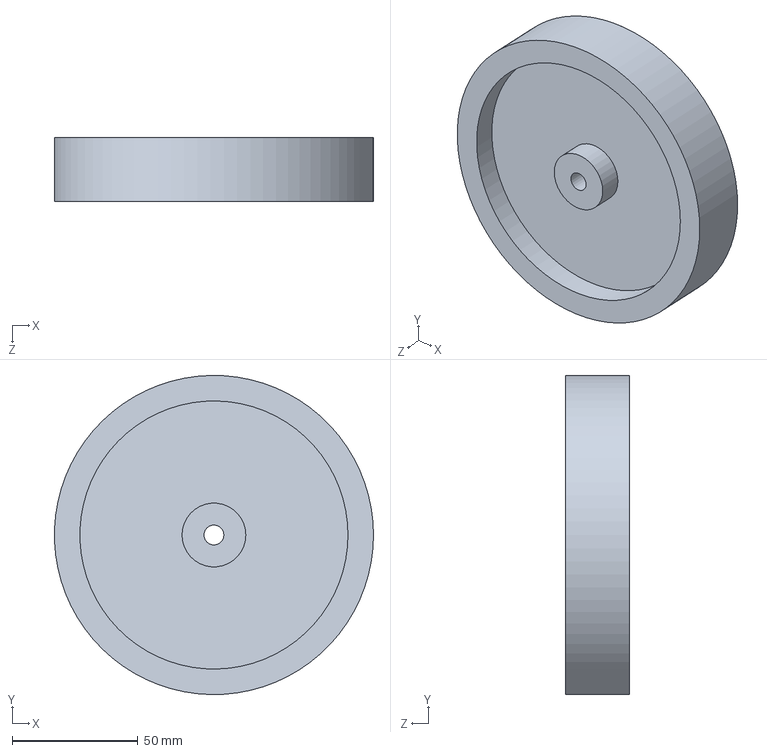
[picture p105: CAD file, 2019-11-17]
Gravity Car Final 2/Rear Axle/Wheel.SLDPRT
126.9 x 127.0 x 25.4 mm
