flasch97/Gravity-Vehicle/Rear Axle/suspension rear.SLDPRT

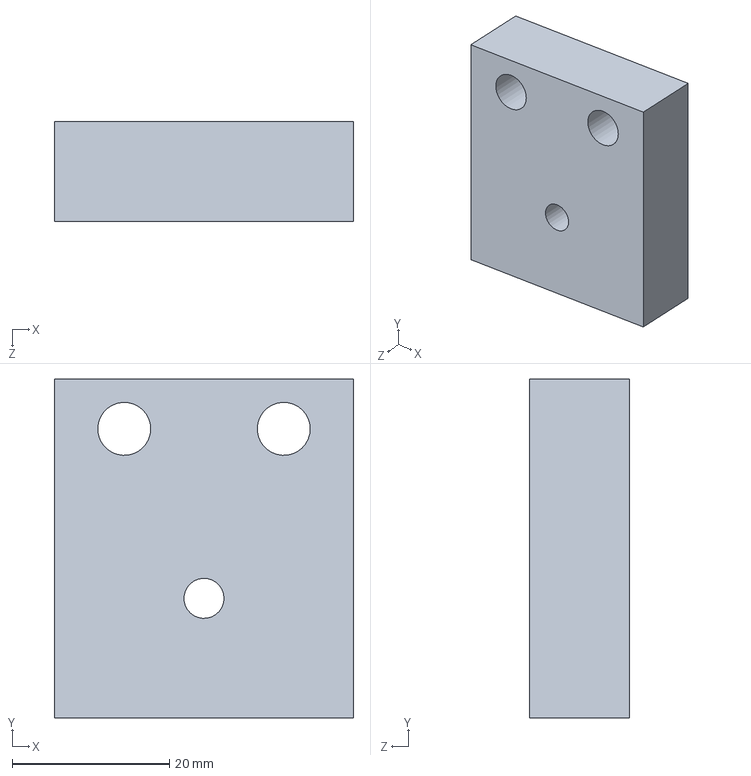
[picture p106: CAD file, 2019-11-04]
Rear Axle/suspension rear.SLDPRT
38.1 x 43.2 x 12.7 mm
