flasch97/Gravity-Vehicle/RELEASE HOOK.SLDPRT

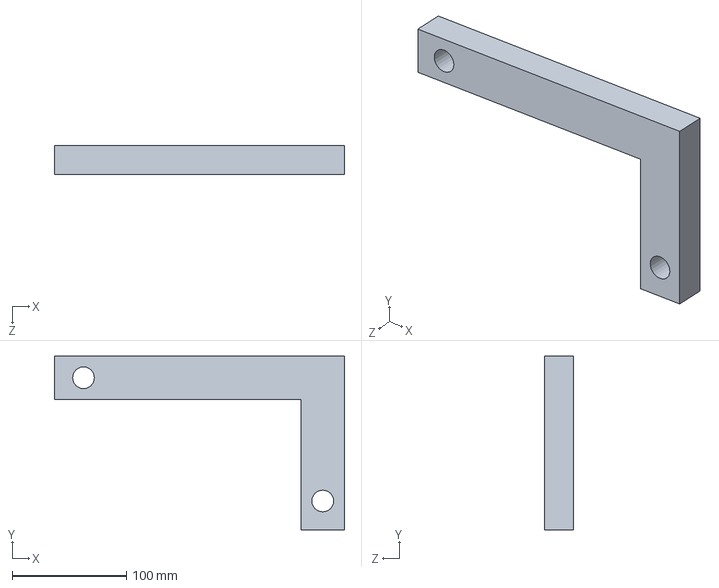
[picture p107: CAD file, 2019-11-13]
RELEASE HOOK.SLDPRT
254.0 x 152.4 x 25.4 mm
