flasch97/Gravity-Vehicle/Release support.SLDPRT

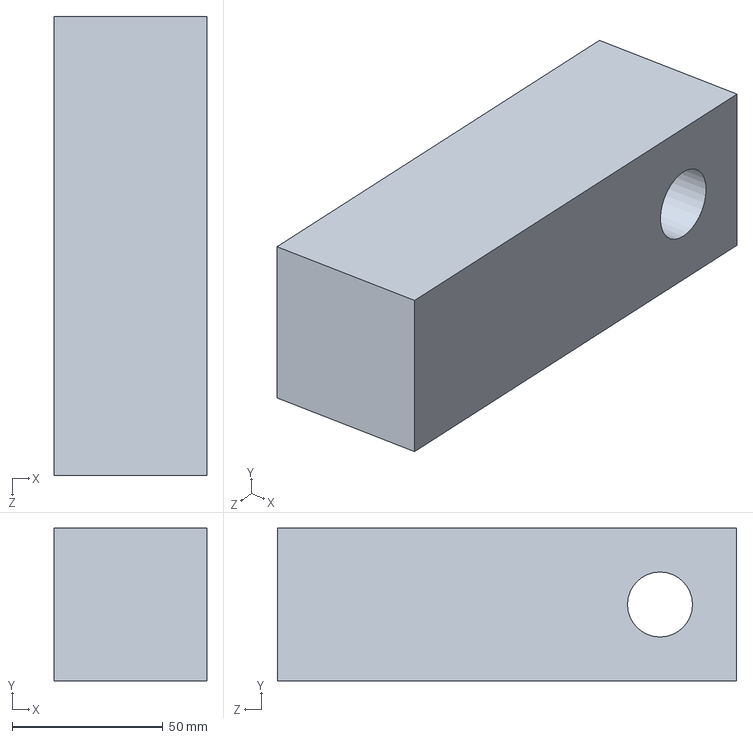
[picture p108: CAD file, 2019-11-13]
Release support.SLDPRT
50.8 x 50.8 x 152.4 mm
