flasch97/Gravity-Vehicle/Gravity Car Final 2/Front Axle/Muffle One-Way-Bearing.SLDPRT

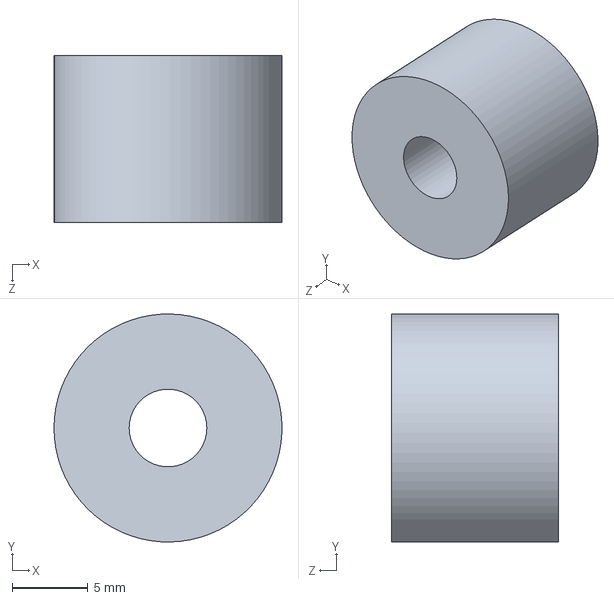
[picture p109: CAD file, 2019-11-18]
Gravity Car Final 2/Front Axle/Muffle One-Way-Bearing.SLDPRT
15.0 x 15.0 x 11.0 mm
