flasch97/Gravity-Vehicle/Gravity Car Final 2/Front Axle/Connection Front Suspention.SLDPRT

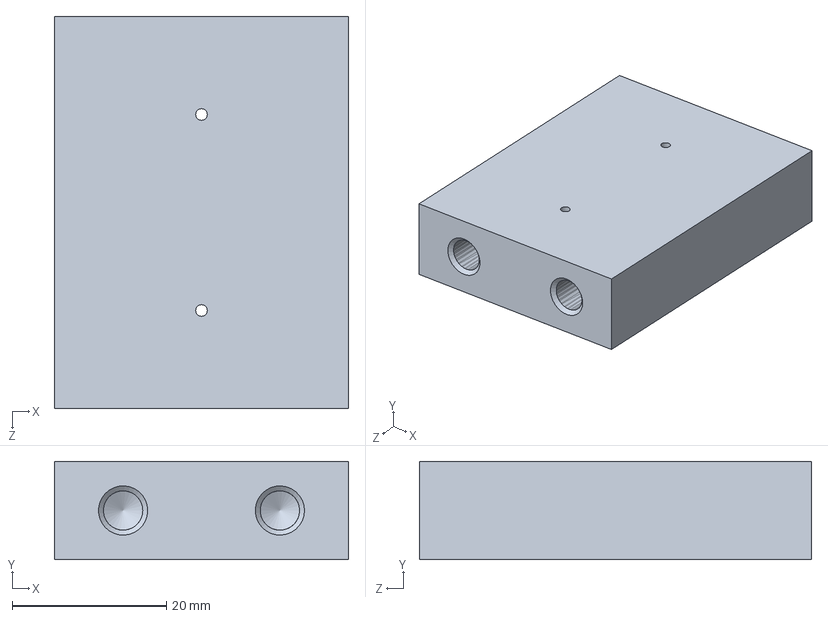
[picture p110: CAD file, 2019-11-18]
Gravity Car Final 2/Front Axle/Connection Front Suspention.SLDPRT
38.1 x 12.7 x 50.8 mm
