flasch97/Gravity-Vehicle/Gravity Car Final 2/Front Axle/Wingnut.SLDPRT

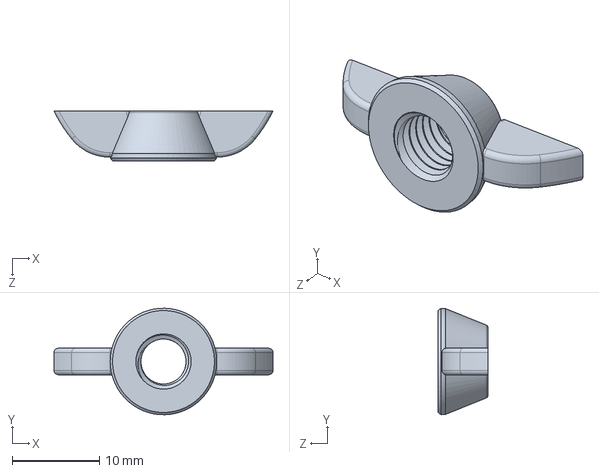
[picture p111: CAD file, 2019-11-18]
Gravity Car Final 2/Front Axle/Wingnut.SLDPRT
25.2 x 12.2 x 5.71 mm
