flasch97/Gravity-Vehicle/Gravity Car Final 2/Front Axle/Threaded Axle Front Right.SLDPRT

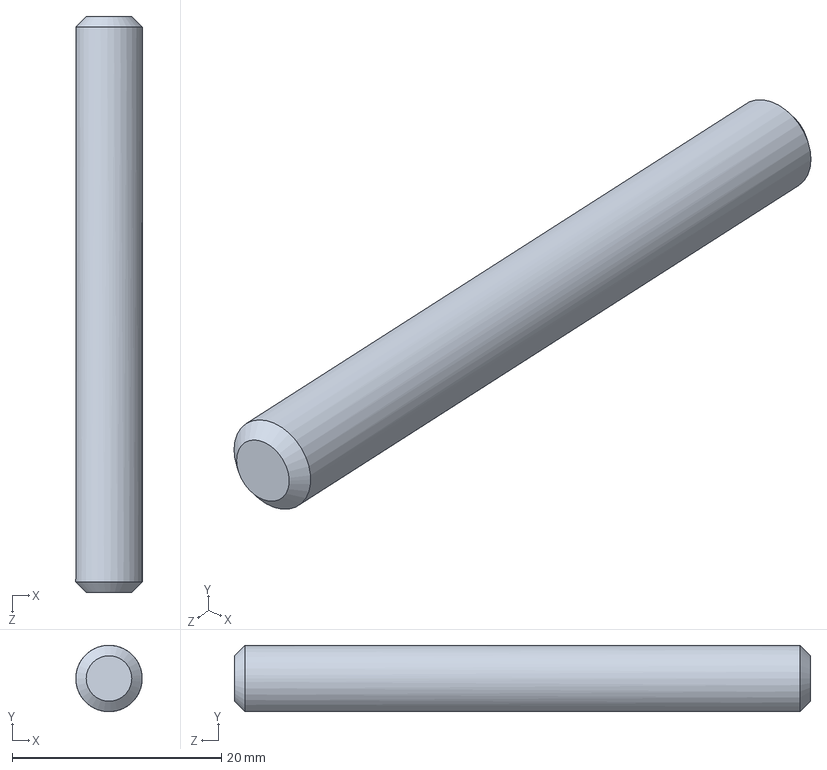
[picture p112: CAD file, 2019-11-18]
Gravity Car Final 2/Front Axle/Threaded Axle Front Right.SLDPRT
6.35 x 6.34 x 55.0 mm
