flasch97/Gravity-Vehicle/Gravity Car Final 2/Front Axle/Threaded Axle Front Left.SLDPRT

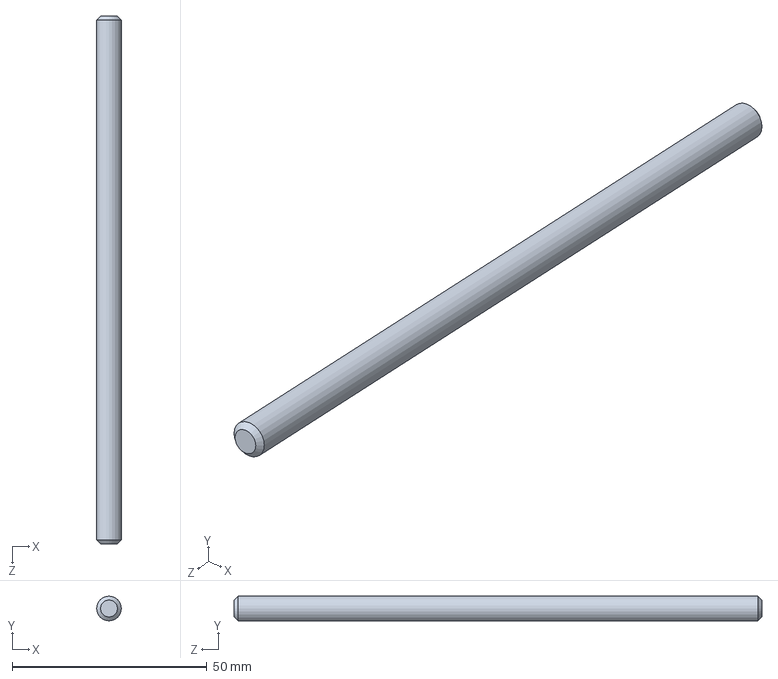
[picture p113: CAD file, 2019-11-18]
Gravity Car Final 2/Front Axle/Threaded Axle Front Left.SLDPRT
6.35 x 6.35 x 135.5 mm
