flasch97/Gravity-Vehicle/Gravity Car Final 2/Front Axle/Adapter One-Way-Bearing.SLDPRT

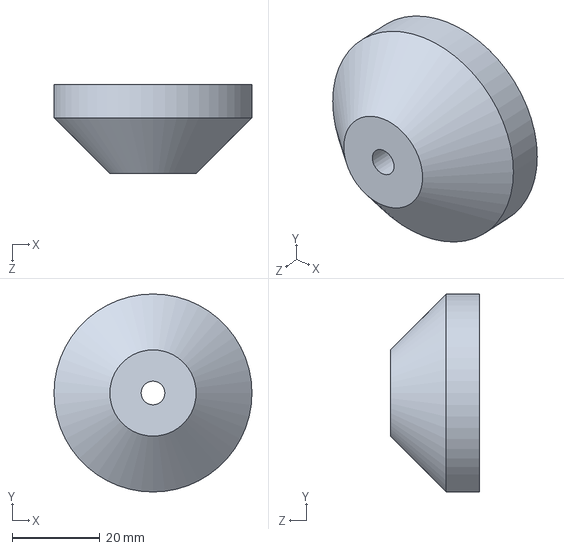
[picture p114: CAD file, 2019-11-18]
Gravity Car Final 2/Front Axle/Adapter One-Way-Bearing.SLDPRT
45.0 x 45.0 x 20.3 mm
