flasch97/Gravity-Vehicle/Gravity Car Final 2/Front Axle/muffle wheel left.SLDPRT

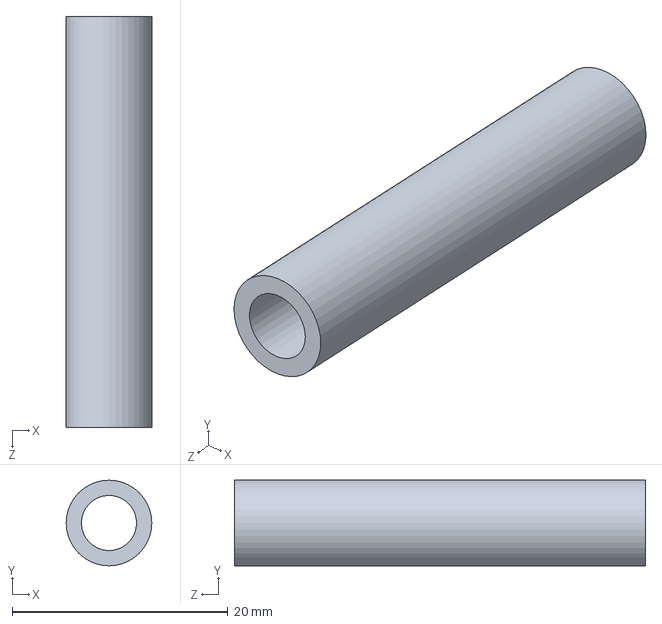
[picture p115: CAD file, 2019-11-17]
Gravity Car Final 2/Front Axle/muffle wheel left.SLDPRT
7.94 x 7.94 x 38.1 mm
