flasch97/Gravity-Vehicle/Gravity Car Final 2/Front Axle/muffle wheel right.SLDPRT

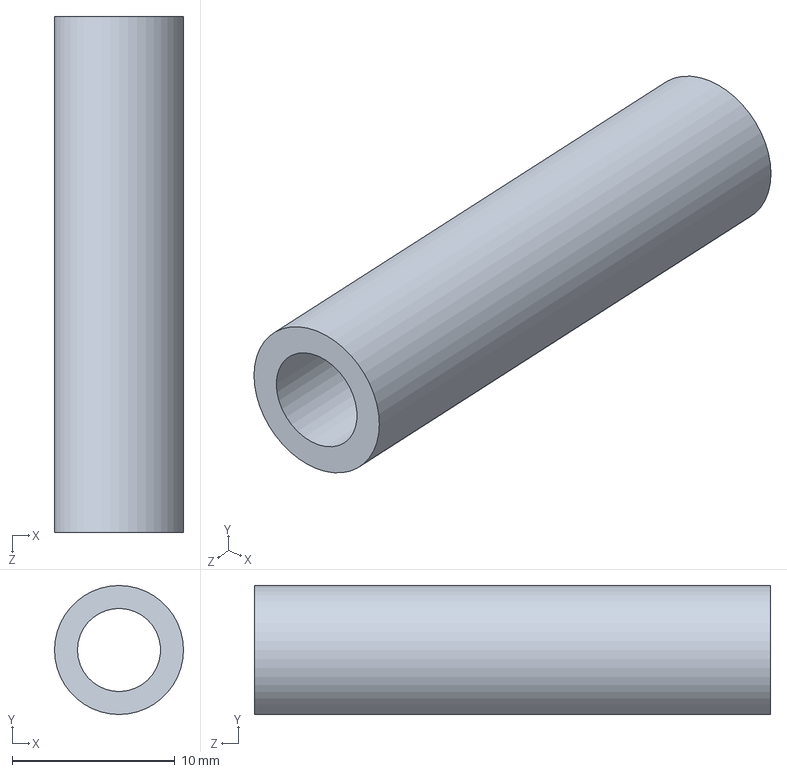
[picture p116: CAD file, 2019-11-17]
Gravity Car Final 2/Front Axle/muffle wheel right.SLDPRT
7.94 x 7.94 x 31.8 mm
