flasch97/Gravity-Vehicle/Gravity Car Final 2/Front Axle/muffle bearing left.SLDPRT

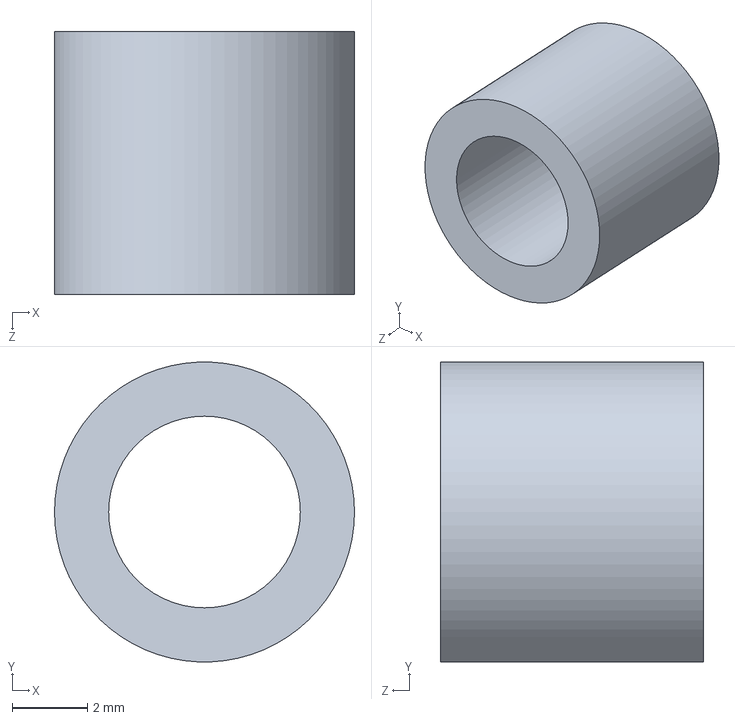
[picture p117: CAD file, 2019-11-17]
Gravity Car Final 2/Front Axle/muffle bearing left.SLDPRT
8.00 x 7.99 x 7.00 mm
