flasch97/Gravity-Vehicle/(list of files, cad)

Other CAD files:
Rear Axle/rear axle assembly.SLDASM
Gravity Car Final 2/calculation arc.SLDPRT
Motion Analysis/floor arc.SLDPRT
Rear Axle/threaded axle rear right.SLDPRT
RampSight/RampSight.SLDPRT
Gravity Car Final 2/Front Axle/608 Ball Bearing.SLDPRT
Gravity Car Final 2/Rear Axle/muffle rear wheels.SLDPRT
Rear Axle/Connection Rear Suspention.SLDPRT
Rear/Rear Wheel.SLDPRT
Andrew's Files/Ramp/Left Ramp Side.SLDPRT
Gravity Car Final 2/Rear Axle/threaded axle rear left.SLDPRT
Andrew's Files/Ramp/Ramp Left Side.SLDPRT
Gravity Car Final 2/Split frame/Frame 1 Rear.SLDPRT
Gravity Car Final 2/Front Axle/One-Way-Bearing.SLDPRT
Ramp Right Side.SLDPRT
calculation arc.SLDPRT
Gravity Car Final 2/Front Axle/Wheel.SLDPRT
Gravity Car Final 2/Front Axle/threaded axle front.SLDPRT
Gravity Car Final 2/Front Axle/threaded axle right wheel.SLDPRT
Gravity Car Final 2/Front Axle/suspension front.SLDPRT
Gravity Car Final 2/Front Axle/Front Wheel.SLDPRT
Gravity Car Final 2/Front Axle/muffle bearing.SLDPRT
Gravity Car Final 2/Front Axle/suspension.SLDPRT
Andrew's Files/Ramp System/Biggest Wood Screw.SLDDRW
Andrew's Files/Ramp System/Biggest Wood Screw.SLDPRT
Andrew's Files/Ramp System/Ramp System.SLDDRW
Andrew's Files/Ramp/Left Ramp Side.SLDDRW
Andrew's Files/Ramp/Position Marker.SLDDRW
Andrew's Files/Ramp/Ramp Right Side.SLDDRW
Andrew's Files/Ramp/Ramp.SLDDRW
Andrew's Files/Ramp/Smaller Wood Screw.SLDDRW
Andrew's Files/Ramp/Smaller Wood Screw.SLDPRT
Andrew's Files/Ramp/base support.SLDDRW
Andrew's Files/Ramp/ramp top.SLDDRW
Andrew's Files/Release Mechanism/Hook Dowel.SLDDRW
Andrew's Files/Release Mechanism/RELEASE HOOK.SLDDRW
Andrew's Files/Release Mechanism/Release Dowel.SLDDRW
Andrew's Files/Release Mechanism/Release Lever.SLDDRW
Andrew's Files/Release Mechanism/Release Mechanism.SLDDRW
Andrew's Files/Release Mechanism/Release support.SLDDRW
Assembly car/Gravity car assembly (Split frame).SLDDRW
Drawings/316 Stainless Steel Washer.SLDDRW
Drawings/608 Ball Bearing.SLDDRW
Drawings/Adapter One-Way-Bearing.SLDDRW
Drawings/Button Head Hex Screw 1-4-28.SLDDRW
Drawings/Connection Front Suspention.SLDDRW
Drawings/Frame 2.SLDDRW
Drawings/Frame1 Front.SLDDRW
Drawings/Frame1_Unfolded Front.SLDDRW
Drawings/Front Axle Assembly.SLDDRW
Drawings/Front Wheel.SLDDRW
Drawings/Muffle Bearing.SLDDRW
Drawings/Muffle One-Way-Bearing.SLDDRW
Drawings/Muffle Wheel Left.SLDDRW
Drawings/Muffle Wheel Right.SLDDRW
Drawings/One-Way-Bearing.SLDDRW
Drawings/Rear Axle/Connection Rear Suspention.SLDDRW
Drawings/Rear Axle/Rear Wheels.SLDDRW
Drawings/Rear Axle/muffle rear wheels.SLDDRW
Drawings/Rear Axle/rear axle assembly.SLDDRW
Drawings/Rear Axle/suspension rear.SLDDRW
Drawings/Rear Axle/threaded axle rear left.SLDDRW
Drawings/Rear Axle/threaded axle rear right.SLDDRW
Drawings/Slide Wing Nut 1.SLDDRW
Drawings/Slide Wing Nut 2.SLDDRW
Drawings/Stainless Steel Button Head Hex Drive Screw 1-64.SLDDRW
Drawings/Stainless Steel Thin Hex Nut 1-4-28.SLDDRW
Drawings/Suspension Front.SLDDRW
Drawings/Threaded Axle Front Left.SLDDRW
Drawings/Threaded Axle Front Right.SLDDRW
Drawings/Wheel.SLDDRW
Drawings/Wingnut.SLDDRW
Drawings/Wooden Rod.SLDDRW
Drawings/muffle one way bearing.SLDDRW
Drawings/threaded axle front.SLDDRW
Drawings/threaded axle right wheel.SLDDRW
Front Axle/Muffle Bearing.SLDPRT
Front Axle/Muffle Wheel Left.SLDPRT
Front Axle/Muffle Wheel Right.SLDPRT
Front Axle/Suspension Front.SLDPRT
Gravity Car Final 1/Drawings/Car/Gravity car assembly (Split frame).SLDDRW
Gravity Car Final 1/Drawings/Front Axle/316 Stainless Steel Washer.SLDDRW
Gravity Car Final 1/Drawings/Front Axle/608 Ball Bearing.SLDDRW
Gravity Car Final 1/Drawings/Front Axle/Adapter One-Way-Bearing.SLDDRW
Gravity Car Final 1/Drawings/Front Axle/Button Head Hex Screw 1-4-20.SLDDRW
Gravity Car Final 1/Drawings/Front Axle/Compression Spring Break.SLDDRW
Gravity Car Final 1/Drawings/Front Axle/Connection Front Suspention.SLDDRW
Gravity Car Final 1/Drawings/Front Axle/Front Axle Assembly.SLDDRW
Gravity Car Final 1/Drawings/Front Axle/Muffle Bearing.SLDDRW
Gravity Car Final 1/Drawings/Front Axle/Muffle One-Way-Bearing.SLDDRW
Gravity Car Final 1/Drawings/Front Axle/Muffle Wheel Left.SLDDRW
Gravity Car Final 1/Drawings/Front Axle/Muffle Wheel Right.SLDDRW
Gravity Car Final 1/Drawings/Front Axle/One-Way-Bearing.SLDDRW
Gravity Car Final 1/Drawings/Front Axle/Slide Wing Nut 1.SLDDRW
Gravity Car Final 1/Drawings/Front Axle/Slide Wing Nut 2.SLDDRW
Gravity Car Final 1/Drawings/Front Axle/Stainless Steel Button Head Hex Drive Screw 1-64.SLDDRW
Gravity Car Final 1/Drawings/Front Axle/Stainless Steel Thin Hex Nut 1-4-28.SLDDRW
Gravity Car Final 1/Drawings/Front Axle/Suspension Front.SLDDRW
Gravity Car Final 1/Drawings/Front Axle/Threaded Axle Front Left.SLDDRW
Gravity Car Final 1/Drawings/Front Axle/Threaded Axle Front Right.SLDDRW
Gravity Car Final 1/Drawings/Front Axle/Wheel.SLDDRW
Gravity Car Final 1/Drawings/Front Axle/Wingnut.SLDDRW
Gravity Car Final 1/Drawings/Front Axle/Wooden Rod.SLDDRW
Gravity Car Final 1/Drawings/Rear Axle/Connection Rear Suspention.SLDDRW
Gravity Car Final 1/Drawings/Rear Axle/muffle rear wheels.SLDDRW
Gravity Car Final 1/Drawings/Rear Axle/rear axle assembly.SLDDRW
Gravity Car Final 1/Drawings/Rear Axle/suspension rear.SLDDRW
Gravity Car Final 1/Drawings/Rear Axle/threaded axle rear left.SLDDRW
Gravity Car Final 1/Drawings/Rear Axle/threaded axle rear right.SLDDRW
Gravity Car Final 1/Drawings/Split Frame/Button Head Hex Drive Screw.SLDDRW
Gravity Car Final 1/Drawings/Split Frame/Clevis Pin.SLDDRW
Gravity Car Final 1/Drawings/Split Frame/Compression Spring.SLDDRW
Gravity Car Final 1/Drawings/Split Frame/Dovel Pin.SLDDRW
Gravity Car Final 1/Drawings/Split Frame/Frame 2.SLDDRW
Gravity Car Final 1/Drawings/Split Frame/Frame 2_Unfolded.SLDDRW
Gravity Car Final 1/Drawings/Split Frame/Frame1 Front.SLDDRW
Gravity Car Final 1/Drawings/Split Frame/Frame1 Rear.SLDDRW
Gravity Car Final 1/Drawings/Split Frame/Frame1_Unfolded Front.SLDDRW
Gravity Car Final 1/Drawings/Split Frame/Frame1_Unfolded Rear.SLDDRW
Gravity Car Final 1/Drawings/Split Frame/micrometer.SLDDRW
Gravity Car Final 2/Front Axle/316 Stainless Steel Washer.SLDPRT
Gravity Car Final 2/Front Axle/92771A521_BRASS WING NUT.SLDPRT
Gravity Car Final 2/Front Axle/Button Head Hex Drive Screw 1-4-28.SLDPRT
Gravity Car Final 2/Front Axle/Button Head Hex Drive Screw 1-64.SLDPRT
Gravity Car Final 2/Front Axle/Hardware Parts/9434K520_MUSIC-WIRE STEEL COMPRESSION SPRINGS.SLDPRT
Gravity Car Final 2/Front Axle/Hardware Parts/BUTTON HEAD HEX DRIVE SCREW 1-24-28.SLDPRT
Gravity Car Final 2/Front Axle/Hardware Parts/BUTTON HEAD HEX DRIVE SCREW 1-64.SLDPRT
Gravity Car Final 2/Front Axle/Hardware Parts/STAINLESS STEEL FLAT WASHER.SLDPRT
Gravity Car Final 2/Front Axle/Hardware Parts/STAINLESS STEEL THIN HEX NUT.SLDPRT
Gravity Car Final 2/Front Axle/Hardware Parts/WING NUT 0.25 - 28.SLDPRT
Gravity Car Final 2/Front Axle/Slide Wing Nut.SLDPRT
Gravity Car Final 2/Front Axle/Stainless Steel Thin Hex Nut 1-4-28.SLDPRT
Gravity Car Final 2/Front Axle/WING NUT 0.25 - 28.SLDPRT
Gravity Car Final 2/Front Axle/WING NUT.SLDPRT
Gravity Car Final 2/Front Axle/muffle one way bearing.SLDPRT
Gravity Car Final 2/Ramp left side/Side Ramp.SLDDRW
Gravity Car Final 2/Split frame/Button Head Hex Drive Screw.SLDPRT
Gravity Car Final 2/Split frame/Hardware/2022N161_MIL. SPEC. COMPRESSION SPRING.SLDPRT
Gravity Car Final 2/Split frame/Hardware/92949A537_18-8 SS BUTTON HEAD HEX DRIVE SCREW.SLDPRT
Gravity Car Final 2/Split frame/Hardware/98306A158_STEEL CLEVIS PIN.SLDPRT
Gravity Car Final 2/Split frame/Hardware/98381A470_ALLOY STEEL DOWEL PIN.SLDPRT
RELEASE HOOK.SLDDRW
Ramp Right Side.SLDDRW
Ramp left side/Side Ramp.SLDDRW
Ramp left side/Side Ramp.SLDPRT
Ramp/Left Ramp Side.SLDDRW
Ramp/Left Ramp Side.SLDPRT
Ramp/Position Marker.SLDPRT
Ramp/Ramp Right Side.SLDDRW
Ramp/Ramp Right Side.SLDPRT
Ramp/Ramp.SLDASM
Ramp/Ramp.SLDDRW
Ramp/Smaller Wood Screw.SLDPRT
Ramp/base support.SLDPRT
Ramp/ramp top.SLDDRW
Ramp/ramp top.SLDPRT
RampSight/screwangle.SLDPRT
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
