flasch97/Gravity-Vehicle/Final PDF/A3 Gravity car assembly (Split frame).PDF

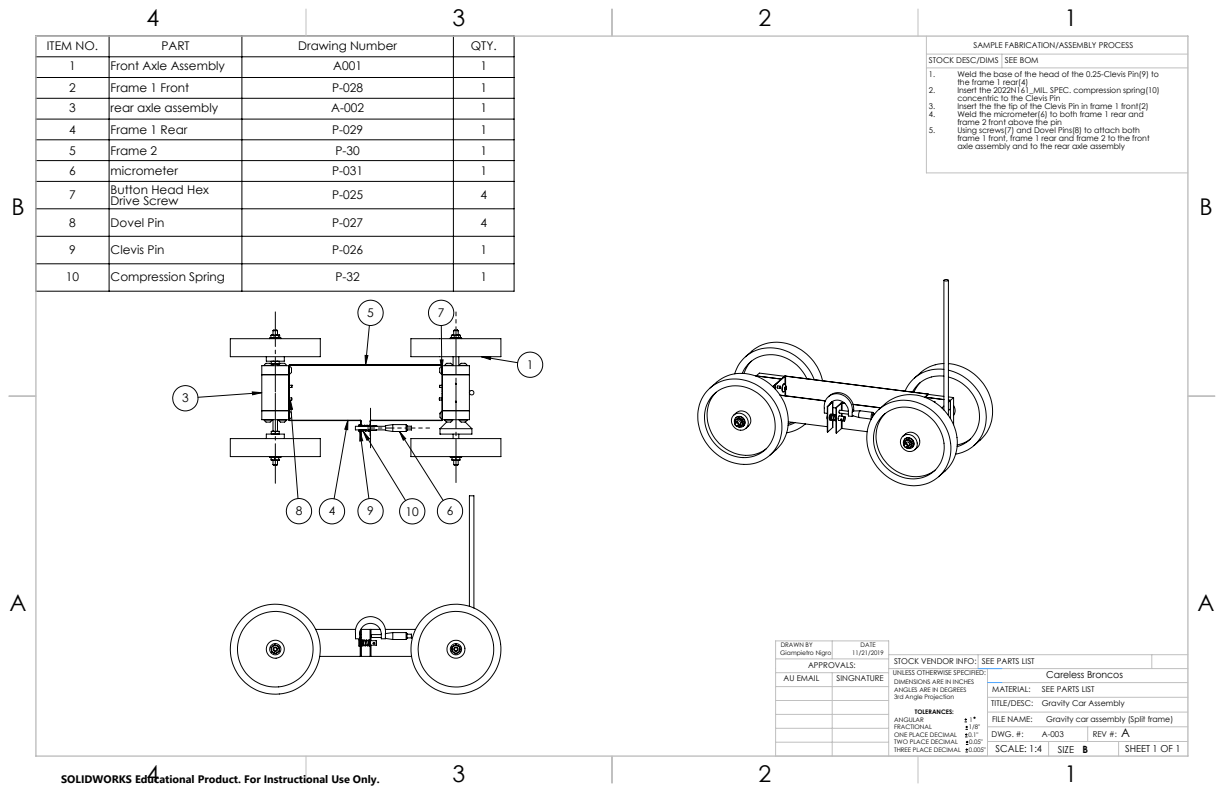
[picture p120: page 1]
Giampietro Nigro; FILE NAME:; DRAWN BY; DATE; AU EMAIL; SINGNATURE

ITEM NO. | PART | Drawing Number | QTY. | SAMPLE FABRICATION/ASSEMBLY PROCESS
1 | Front Axle Assembly | A001 | 1
2 | Frame 1 Front | P-028 | 1
3 | rear axle assembly | A-002 | 1
4 | Frame 1 Rear | P-029 | 1
5 | Frame 2 | P-30 | 1
6 | micrometer | P-031 | 1
7 | Button Head Hex Drive Screw | P-025 | 4

STOCK DESC/DIMS | SEE BOM

1. Weld the base of the head of the 0.25-Clevis Pin(9) to
the frame 1 rear(4)
2. Insert the 2022N161_MIL. SPEC. compression spring(10)
concentric to the Clevis Pin
3. Insert the the tip of the Clevis Pin in frame 1 front(2)
4. Weld the micrometer(6) to both frame 1 rear and
frame 2 front above the pin
5. Using screws(7) and Dovel Pins(8) to attach both
frame 1 front, frame 1 rear and frame 2 to the front
axle assembly and to the rear axle assembly

8 | Dovel Pin | P-027 | 4
9 | Clevis Pin | P-026 | 1
10 | Compression Spring | P-32 | 1

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

DIMENSIONS ARE IN INCHES

SEE PARTS LIST
Gravity Car Assembly
Gravity car assembly (Split frame)

DWG. #: A-003 | REV #: A
SCALE: 1:4 | SIZE B | SHEET 1 OF 1

SOLIDWORKS Educational Product. For Instructional Use Only.
