flasch97/Gravity-Vehicle/base support - B-sized Sheet.pdf

2

3

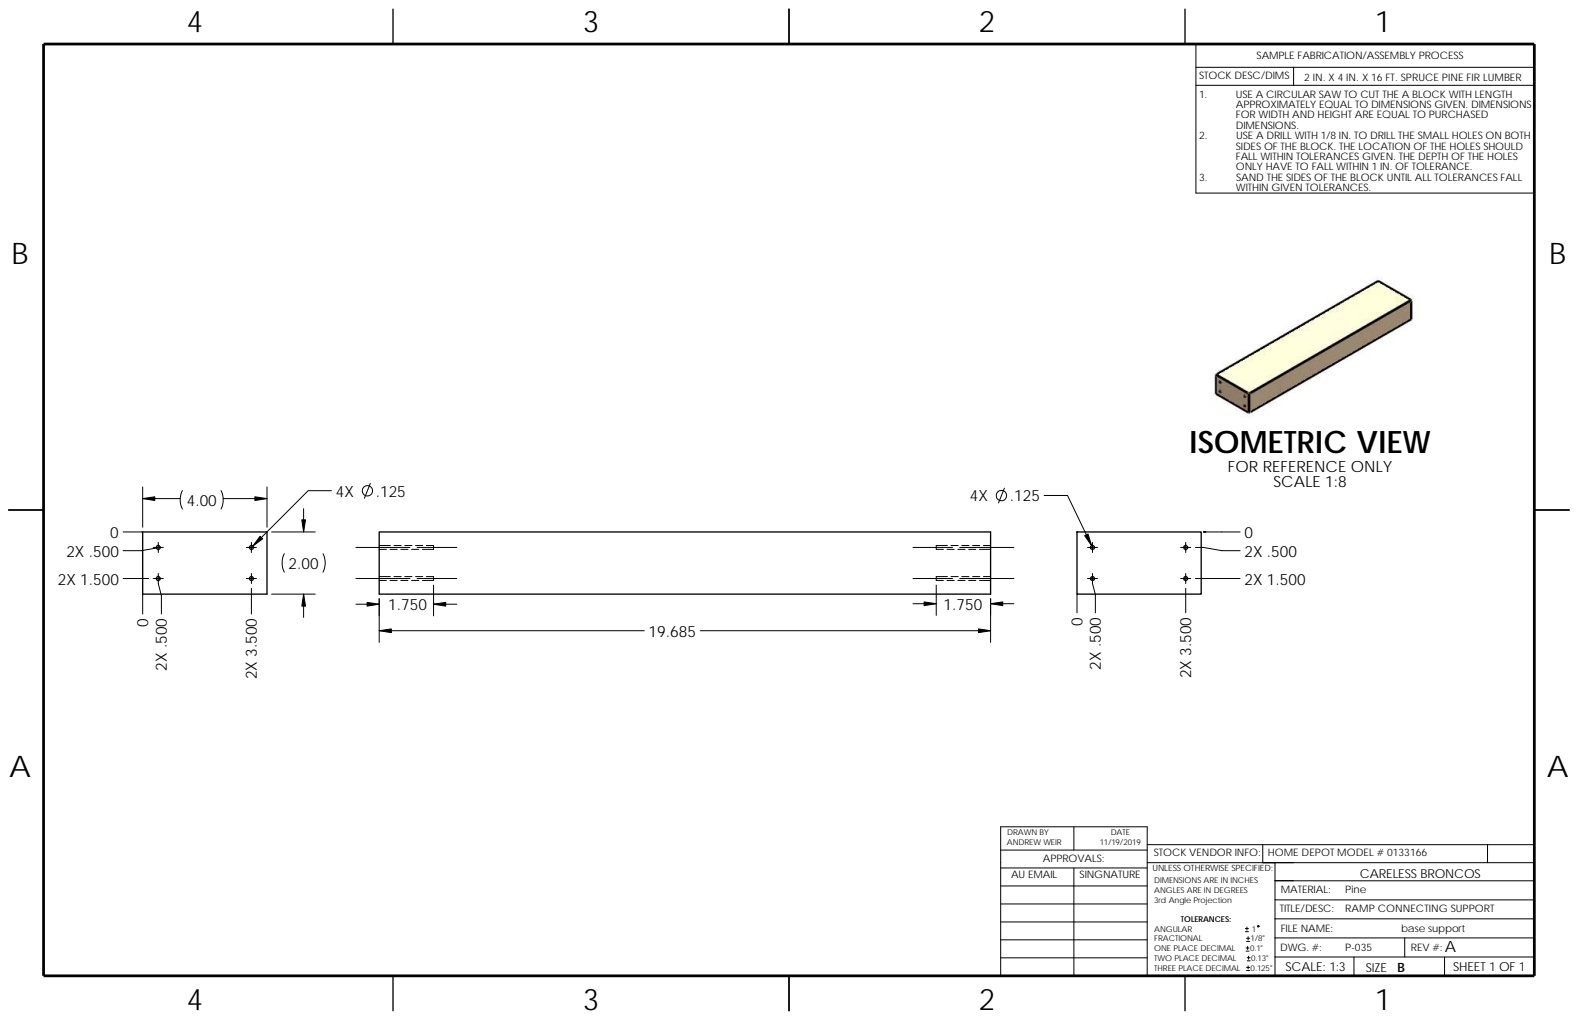
[picture p123: page 1]
TITLE/DESC:; AU EMAIL; TWO PLACE DECIMAL; MATERIAL:; base support; APPROVALS:; FILE NAME:; SINGNATURE; ANGULAR

SAMPLE FABRICATION/ASSEMBLY PROCESS

STOCK DESC/DIMS | 2 IN. X 4 IN. X 16 FT. SPRUCE PINE FIR LUMBER

1. USE A CIRCULAR SAW TO CUT THE A BLOCK WITH LENGTH
APPROXIMATELY EQUAL TO DIMENSIONS GIVEN. DIMENSIONS
FOR WIDTH AND HEIGHT ARE EQUAL TO PURCHASED
DIMENSIONS.
2. USE A DRILL WITH 1/8 IN. TO DRILL THE SMALL HOLES ON BOTH
SIDES OF THE BLOCK. THE LOCATION OF THE HOLES SHOULD
FALL WITHIN TOLERANCES GIVEN. THE DEPTH OF THE HOLES
ONLY HAVE TO FALL WITHIN 1 IN. OF TOLERANCE.
3. SAND THE SIDES OF THE BLOCK UNTIL ALL TOLERANCES FALL
WITHIN GIVEN TOLERANCES.

ISOMETRIC VIEW
FOR REFERENCE ONLY
SCALE 1:8

DRAWN BY ANDREW WEIR | DATE 11/19/2019

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

HOME DEPOT MODEL # 0133166

CARELESS BRONCOS
Pine
RAMP CONNECTING SUPPORT

TOLERANCES:
FRACTIONAL
ONE PLACE DECIMAL
THREE PLACE DECIMAL

DWG. #: P-035 | A REV #:
SCALE: 1:3 | SIZE B | SHEET 1 OF 1
