flasch97/Gravity-Vehicle/Left Ramp Side - B-sized Sheet.pdf

0

4

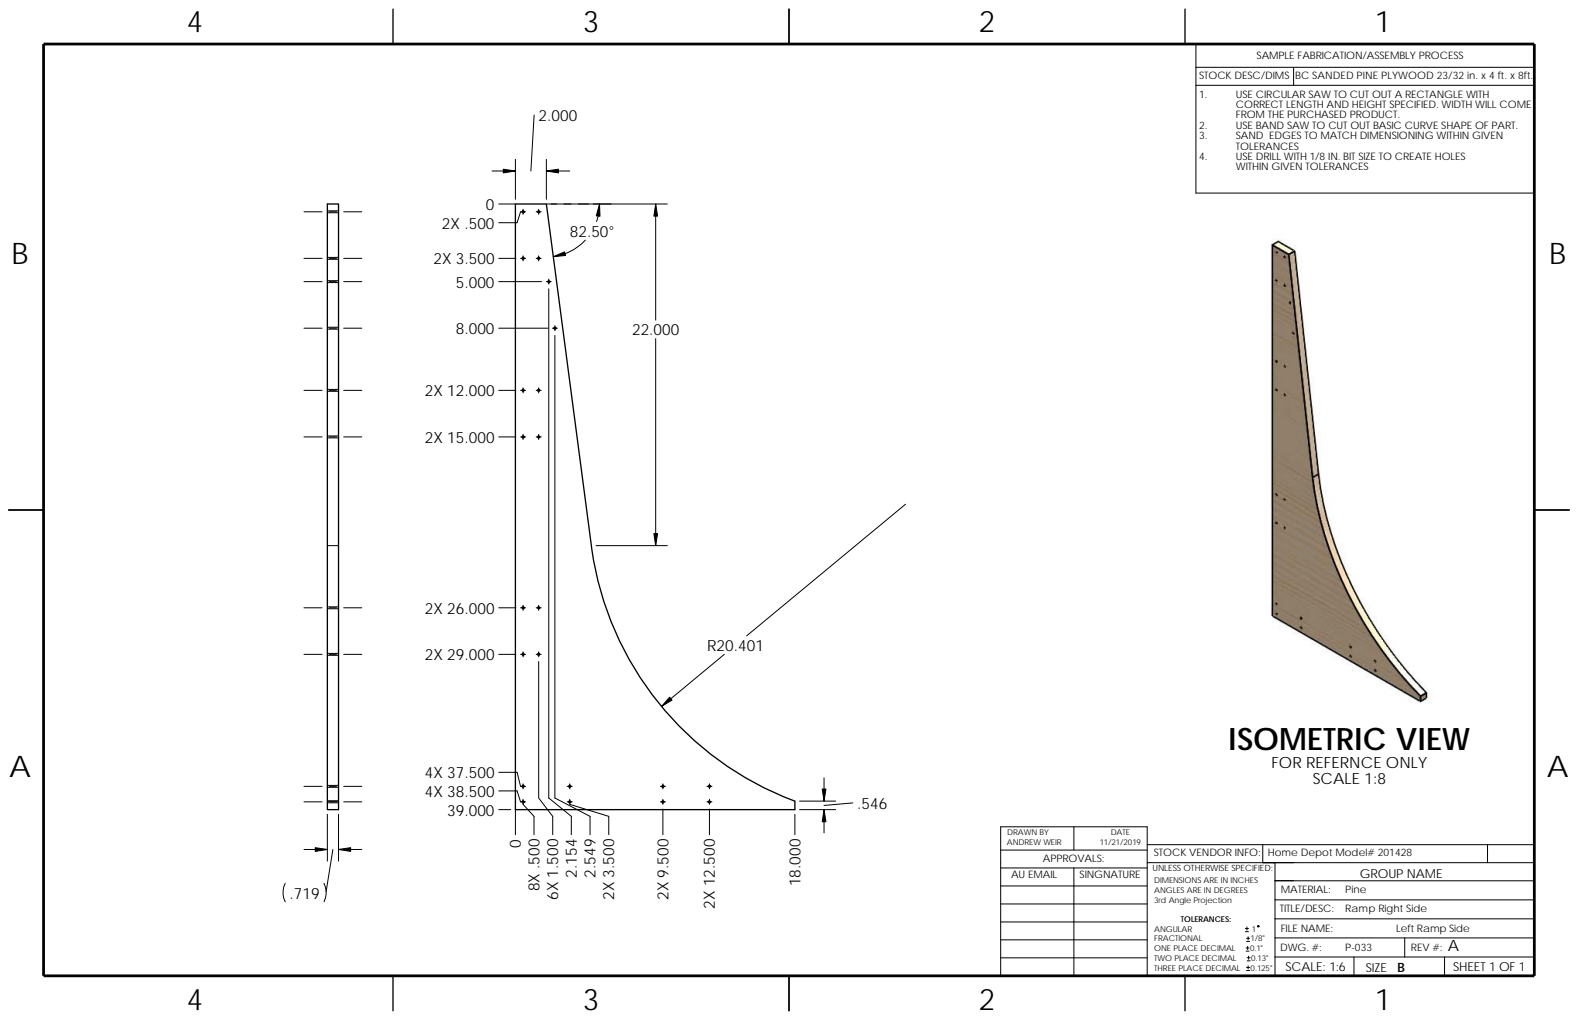
[picture p124: page 1]
ONE PLACE DECIMAL; REV #:; SINGNATURE; MATERIAL: TITLE/DESC:; AU EMAIL; APPROVALS:; FILE NAME:; ANGULAR

2.000 | SAMPLE FABRICATION/ASSEMBLY PROCESS

STOCK DESC/DIMS | BC SANDED PINE PLYWOOD 23/32 in. x 4 ft. x 8ft.

1. USE CIRCULAR SAW TO CUT OUT A RECTANGLE WITH
CORRECT LENGTH AND HEIGHT SPECIFIED. WIDTH WILL COME
FROM THE PURCHASED PRODUCT.
2. USE BAND SAW TO CUT OUT BASIC CURVE SHAPE OF PART.
3. SAND EDGES TO MATCH DIMENSIONING WITHIN GIVEN
TOLERANCES
4. USE DRILL WITH 1/8 IN. BIT SIZE TO CREATE HOLES
WITHIN GIVEN TOLERANCES

ISOMETRIC VIEW
FOR REFERNCE ONLY
SCALE 1:8

DRAWN BY ANDREW WEIR | DATE 11/21/2019

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

Home Depot Model# 201428

GROUP NAME
Pine
Ramp Right Side

TOLERANCES:
FRACTIONAL
TWO PLACE DECIMAL
THREE PLACE DECIMAL

Left Ramp Side

DWG. #: P-033 | A
SCALE: 1:6 | SIZE B | SHEET 1 OF 1
