flasch97/Gravity-Vehicle/Position Marker - B-sized Sheet.pdf

4

3

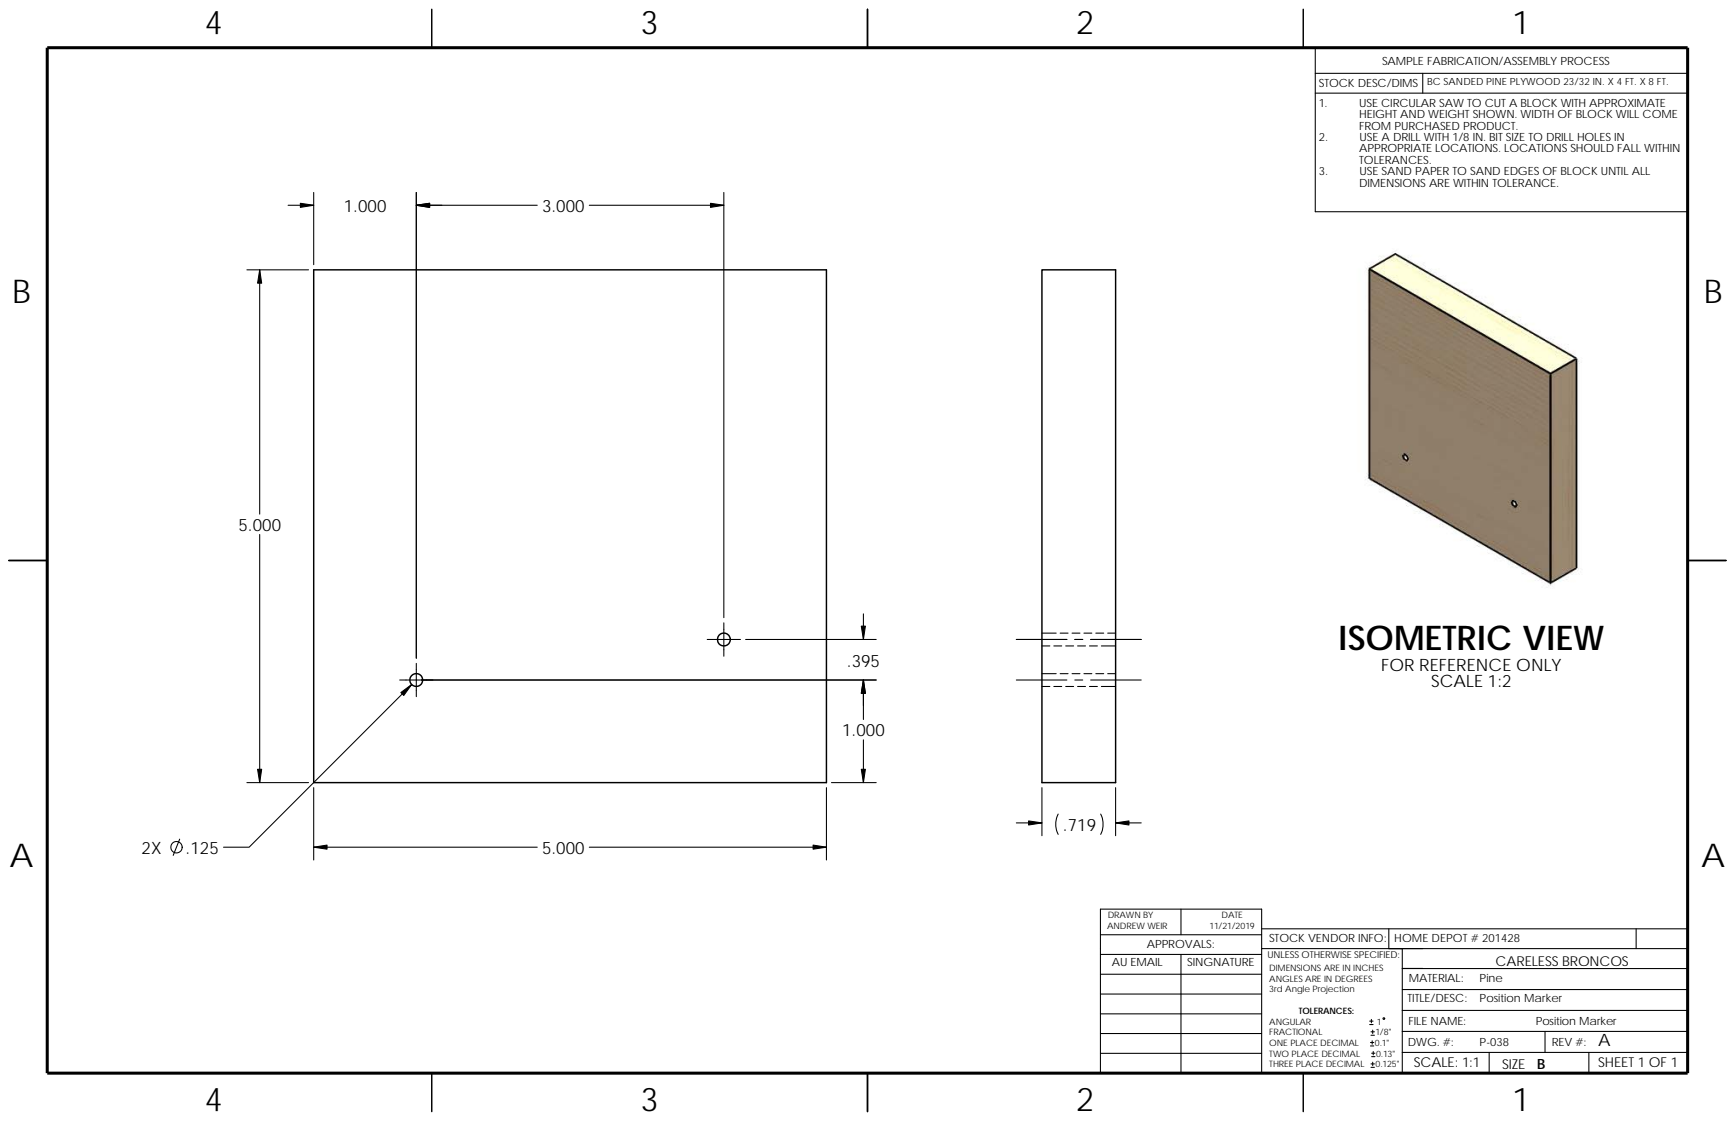
[picture p125: page 1]
Position Marker; Pine; CARELESS BRONCOS; TITLE/DESC:; FILE NAME:; THREE PLACE DECIMAL; AU EMAIL; SINGNATURE; APPROVALS:; MATERIAL:; ANGULAR; FRACTIONAL

SAMPLE FABRICATION/ASSEMBLY PROCESS

STOCK DESC/DIMS | BC SANDED PINE PLYWOOD 23/32 IN. X 4 FT. X 8 FT.

1. USE CIRCULAR SAW TO CUT A BLOCK WITH APPROXIMATE
HEIGHT AND WEIGHT SHOWN. WIDTH OF BLOCK WILL COME
FROM PURCHASED PRODUCT.
2. USE A DRILL WITH 1/8 IN. BIT SIZE TO DRILL HOLES IN
APPROPRIATE LOCATIONS. LOCATIONS SHOULD FALL WITHIN
TOLERANCES.
3. USE SAND PAPER TO SAND EDGES OF BLOCK UNTIL ALL
DIMENSIONS ARE WITHIN TOLERANCE.

ISOMETRIC VIEW
FOR REFERENCE ONLY
SCALE 1:2

DRAWN BY ANDREW WEIR | DATE 11/21/2019

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

HOME DEPOT # 201428

TOLERANCES:
ONE PLACE DECIMAL
TWO PLACE DECIMAL

DWG. #: P-038 | A REV #:
SCALE: 1:1 | SIZE | SHEET 1 OF 1
