flasch97/Gravity-Vehicle/Ramp - B-sized Sheet.pdf

4

3

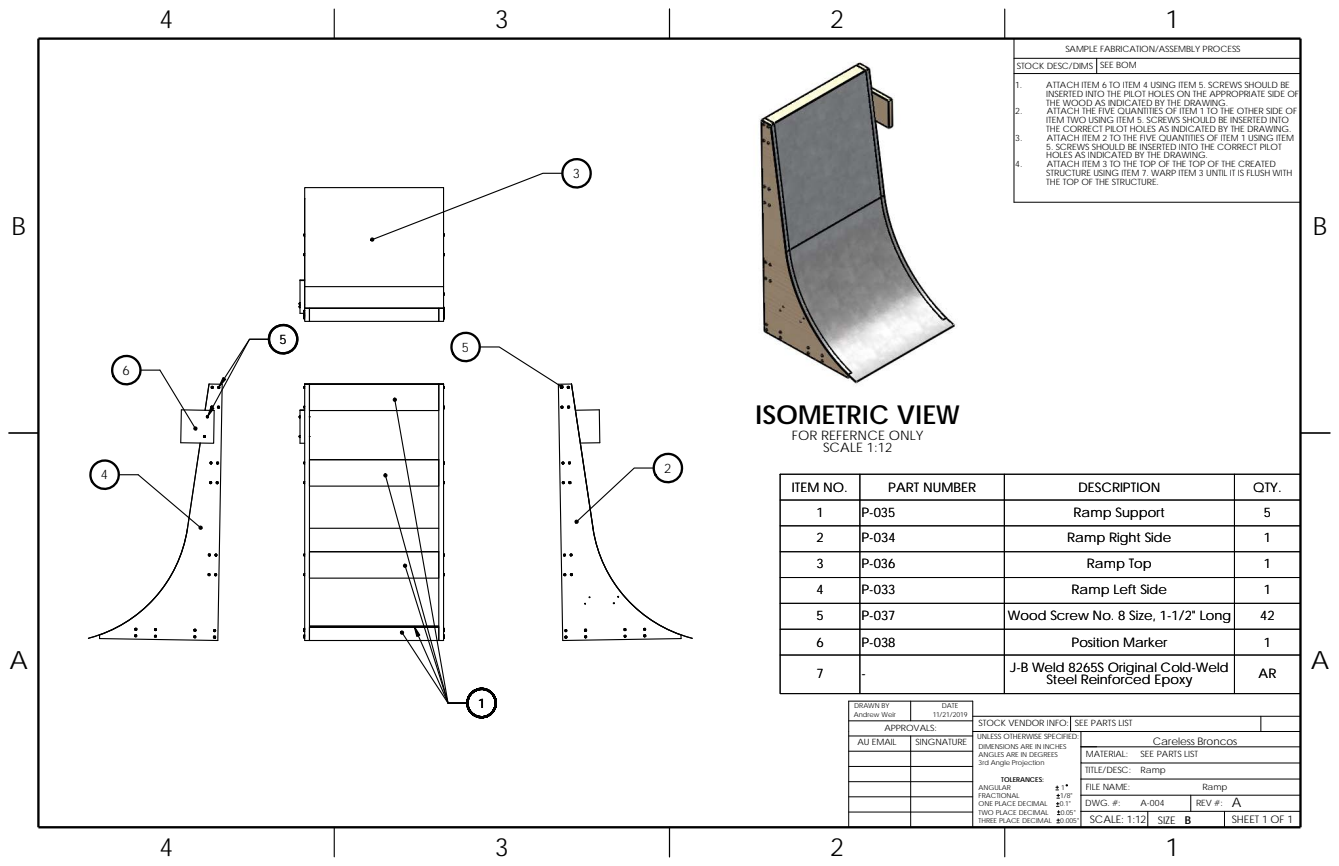
[picture p126: page 1]
ITEM NO.; PART NUMBER; DESCRIPTION; QTY.; Ramp Support; Ramp Right Side; Ramp Top; Ramp Left Side; Wood Screw No. 8 Size, 1-1/2" Long; Position Marker; J-B Weld 8265S Original Cold-Weld Steel Reinforced Epoxy; AU EMAIL; SINGNATURE; APPROVALS:; TITLE/DESC:; Ramp; THREE PLACE DECIMAL; FILE NAME:; FRACTIONAL; MATERIAL:; ANGULAR

SAMPLE FABRICATION/ASSEMBLY PROCESS

STOCK DESC/DIMS | SEE BOM

1. ATTACH ITEM 6 TO ITEM 4 USING ITEM 5. SCREWS SHOULD BE
INSERTED INTO THE PILOT HOLES ON THE APPROPRIATE SIDE OF
THE WOOD AS INDICATED BY THE DRAWING.
2. ATTACH THE FIVE QUANTITIES OF ITEM 1 TO THE OTHER SIDE OF
ITEM TWO USING ITEM 5. SCREWS SHOULD BE INSERTED INTO
THE CORRECT PILOT HOLES AS INDICATED BY THE DRAWING.
3. ATTACH ITEM 2 TO THE FIVE QUANTITIES OF ITEM 1 USING ITEM
5. SCREWS SHOULD BE INSERTED INTO THE CORRECT PILOT
HOLES AS INDICATED BY THE DRAWING.
4. ATTACH ITEM 3 TO THE TOP OF THE TOP OF THE CREATED
STRUCTURE USING ITEM 7. WARP ITEM 3 UNTIL IT IS FLUSH WITH
THE TOP OF THE STRUCTURE.

ISOMETRIC VIEW
FOR REFERNCE ONLY
SCALE 1:12

DRAWN BY Andrew Weir | DATE 11/21/2019

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

SEE PARTS LIST

Careless Broncos
Ramp

TOLERANCES:
ONE PLACE DECIMAL
TWO PLACE DECIMAL

DWG. #: A-004 | A REV #:
SCALE: 1:12 | SIZE | SHEET 1 OF 1
