flasch97/Gravity-Vehicle/ramp top - B-sized Sheet.pdf

2

3

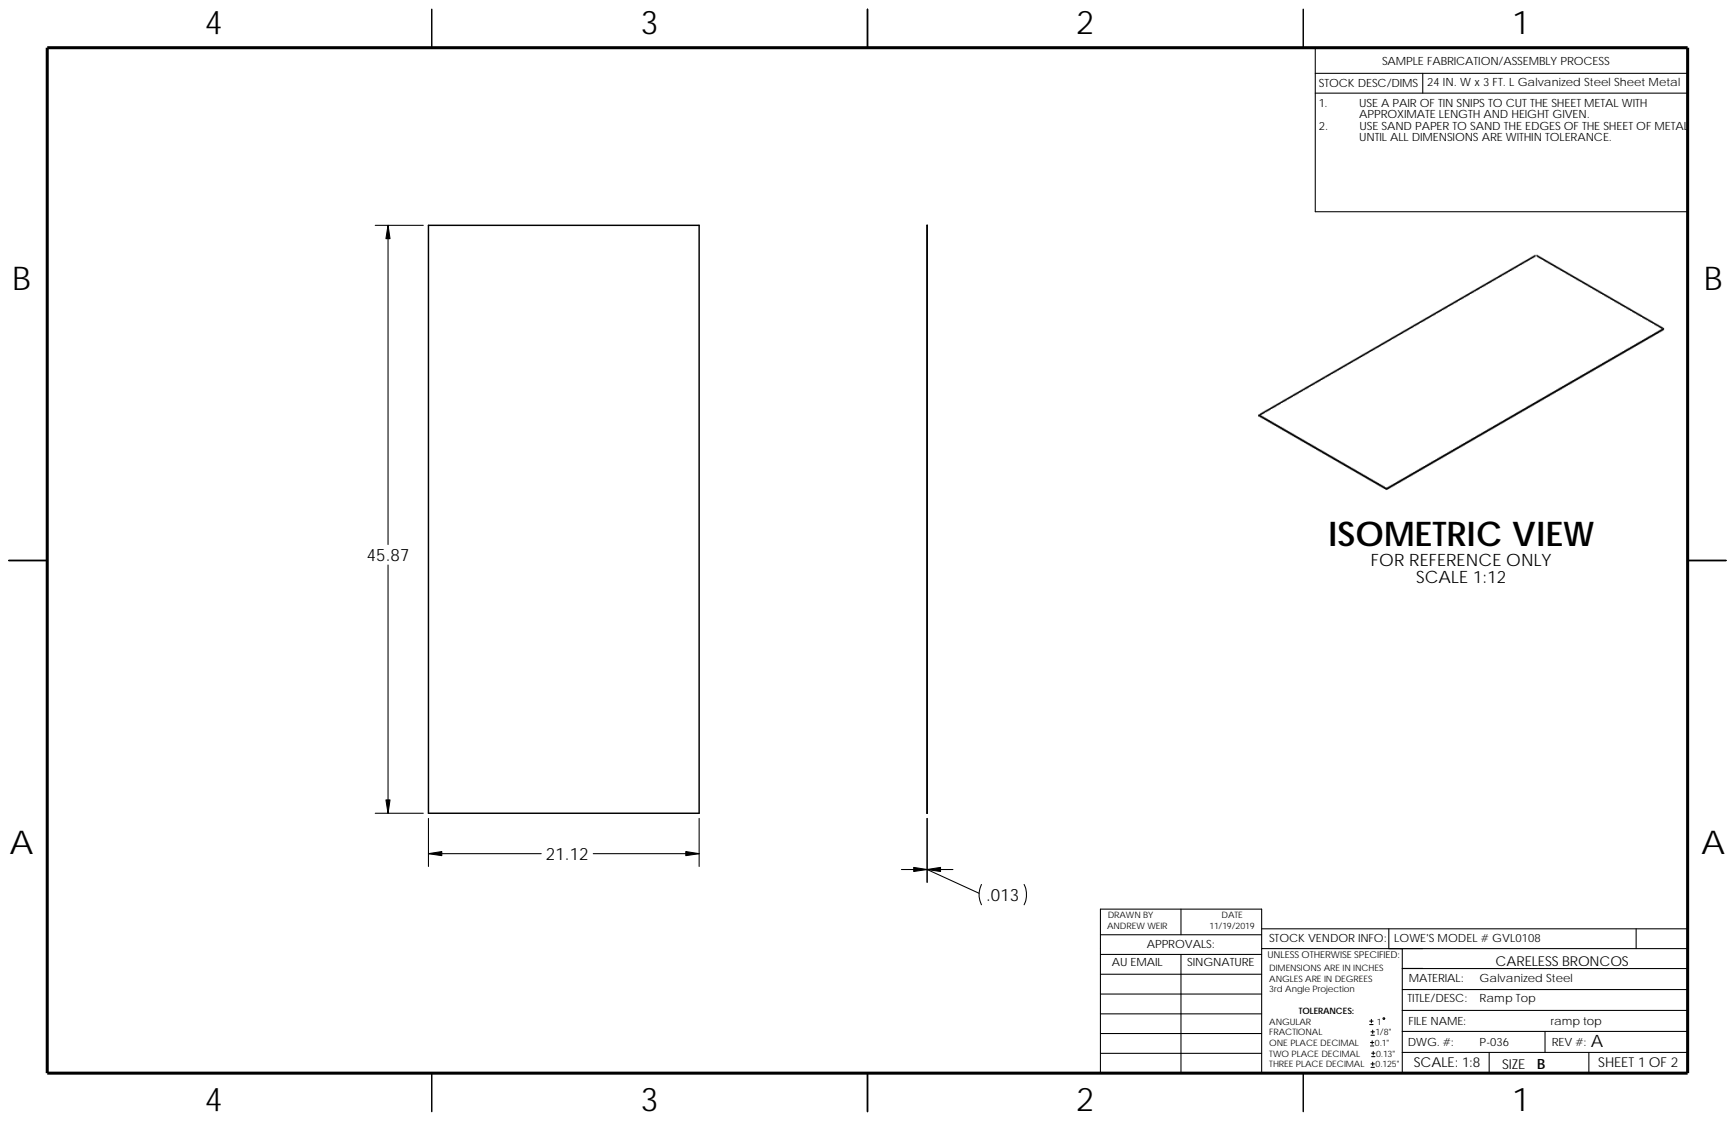
[picture p127: page 1]
Ramp Top; Galvanized Steel; CARELESS BRONCOS; TITLE/DESC:; FILE NAME:; SINGNATURE; AU EMAIL; MATERIAL:; ramp top; APPROVALS:; ANGULAR; FRACTIONAL; ONE PLACE DECIMAL

SAMPLE FABRICATION/ASSEMBLY PROCESS

STOCK DESC/DIMS | 24 IN. W x 3 FT. L Galvanized Steel Sheet Metal

1. USE A PAIR OF TIN SNIPS TO CUT THE SHEET METAL WITH
APPROXIMATE LENGTH AND HEIGHT GIVEN.
2. USE SAND PAPER TO SAND THE EDGES OF THE SHEET OF METAL
UNTIL ALL DIMENSIONS ARE WITHIN TOLERANCE.

ISOMETRIC VIEW
FOR REFERENCE ONLY
SCALE 1:12

DRAWN BY ANDREW WEIR | DATE 11/19/2019

STOCK VENDOR INFO:
UNLESS OTHERWISE SPECIFIED:
DIMENSIONS ARE IN INCHES
ANGLES ARE IN DEGREES
3rd Angle Projection

LOWE'S MODEL # GVL0108

TOLERANCES:
TWO PLACE DECIMAL
THREE PLACE DECIMAL

DWG. #: P-036 | A REV #:
SCALE: 1:8 | SIZE B | SHEET 1 OF 2

2

3

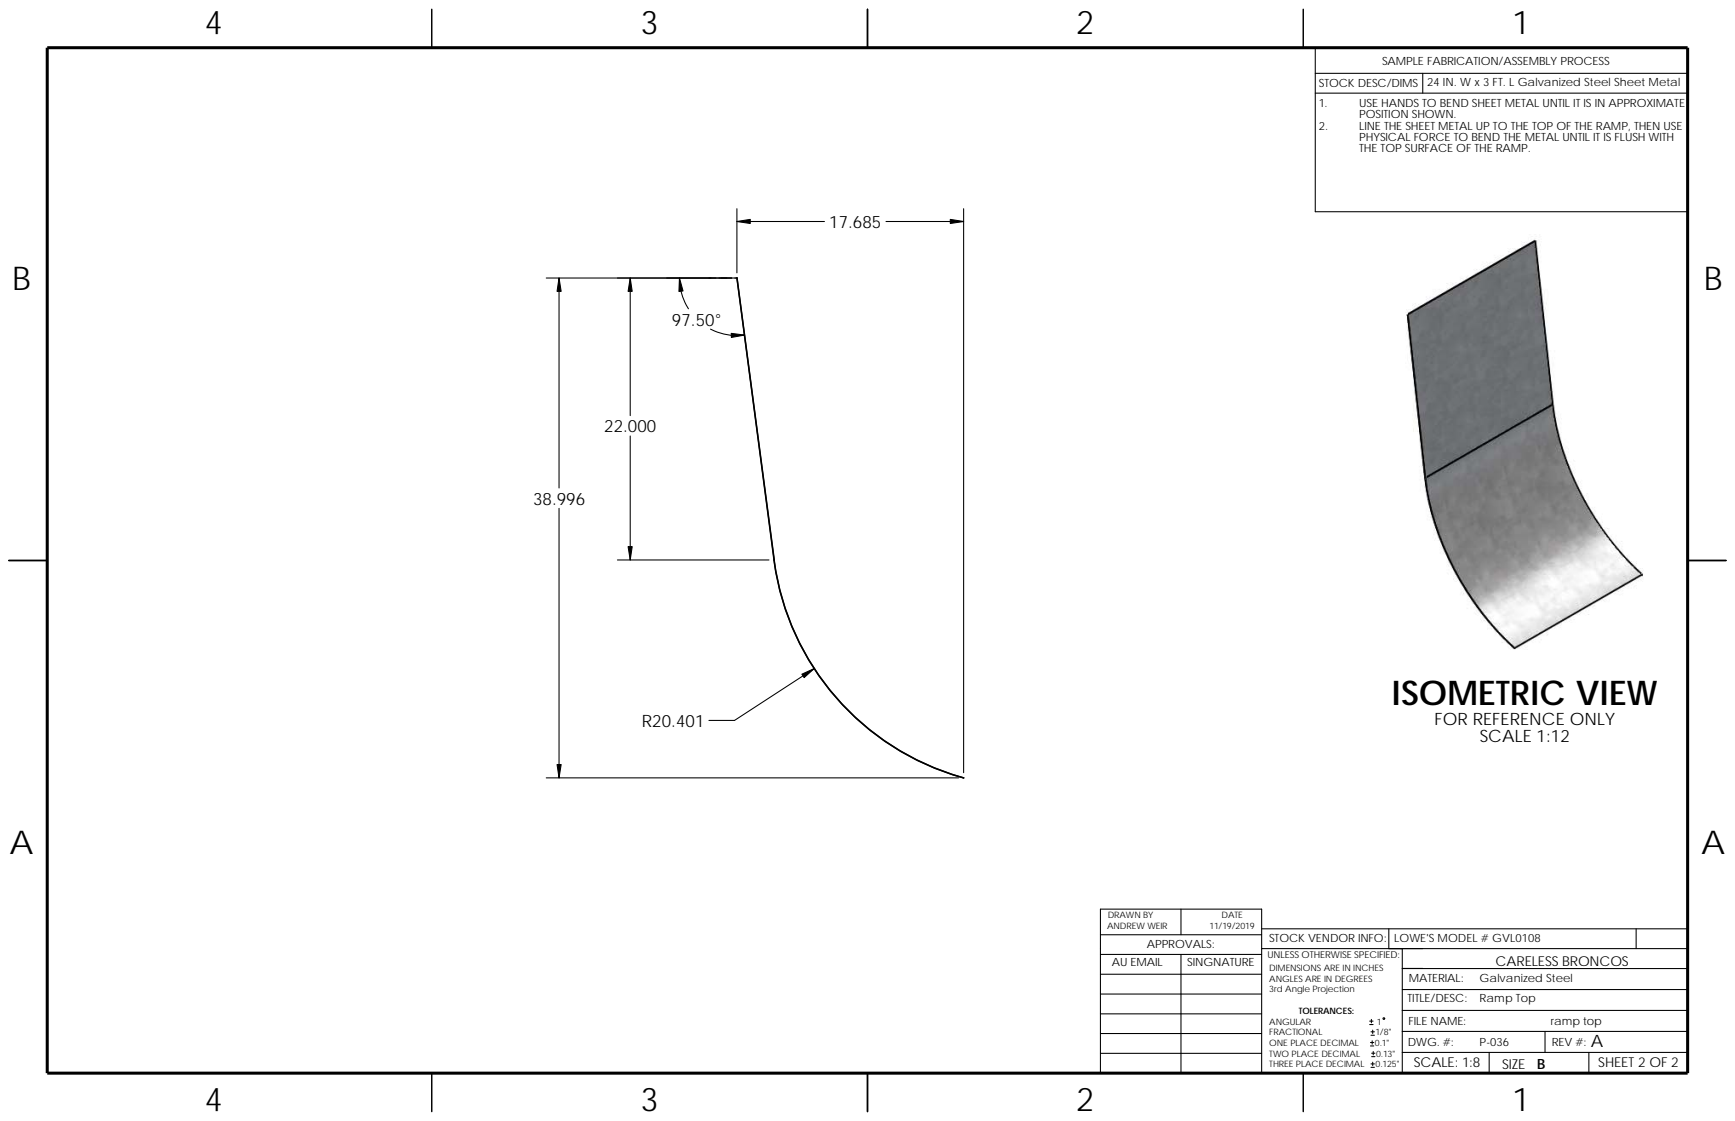
[picture p128: page 2]
Ramp Top; Galvanized Steel; CARELESS BRONCOS; TITLE/DESC:; FILE NAME:; MATERIAL:; ramp top; APPROVALS:; AU EMAIL; SINGNATURE DIMENSIONS ARE IN INCHES; ANGULAR; FRACTIONAL

SAMPLE FABRICATION/ASSEMBLY PROCESS

STOCK DESC/DIMS | 24 IN. W x 3 FT. L Galvanized Steel Sheet Metal

1. USE HANDS TO BEND SHEET METAL UNTIL IT IS IN APPROXIMATE
POSITION SHOWN.
2. LINE THE SHEET METAL UP TO THE TOP OF THE RAMP, THEN USE
PHYSICAL FORCE TO BEND THE METAL UNTIL IT IS FLUSH WITH
THE TOP SURFACE OF THE RAMP.

ISOMETRIC VIEW
FOR REFERENCE ONLY
SCALE 1:12

DRAWN BY ANDREW WEIR | DATE 11/19/2019

STOCK VENDOR INFO:
UNLESS OTHERWISE SPECIFIED:

LOWE'S MODEL # GVL0108

ANGLES ARE IN DEGREES
3rd Angle Projection

TOLERANCES:
ONE PLACE DECIMAL
TWO PLACE DECIMAL
THREE PLACE DECIMAL

DWG. #: P-036 | A REV #:
SCALE: 1:8 | SIZE B | SHEET 2 OF 2
