flasch97/Gravity-Vehicle/Release Dowel - B-sized Sheet.pdf

2

3

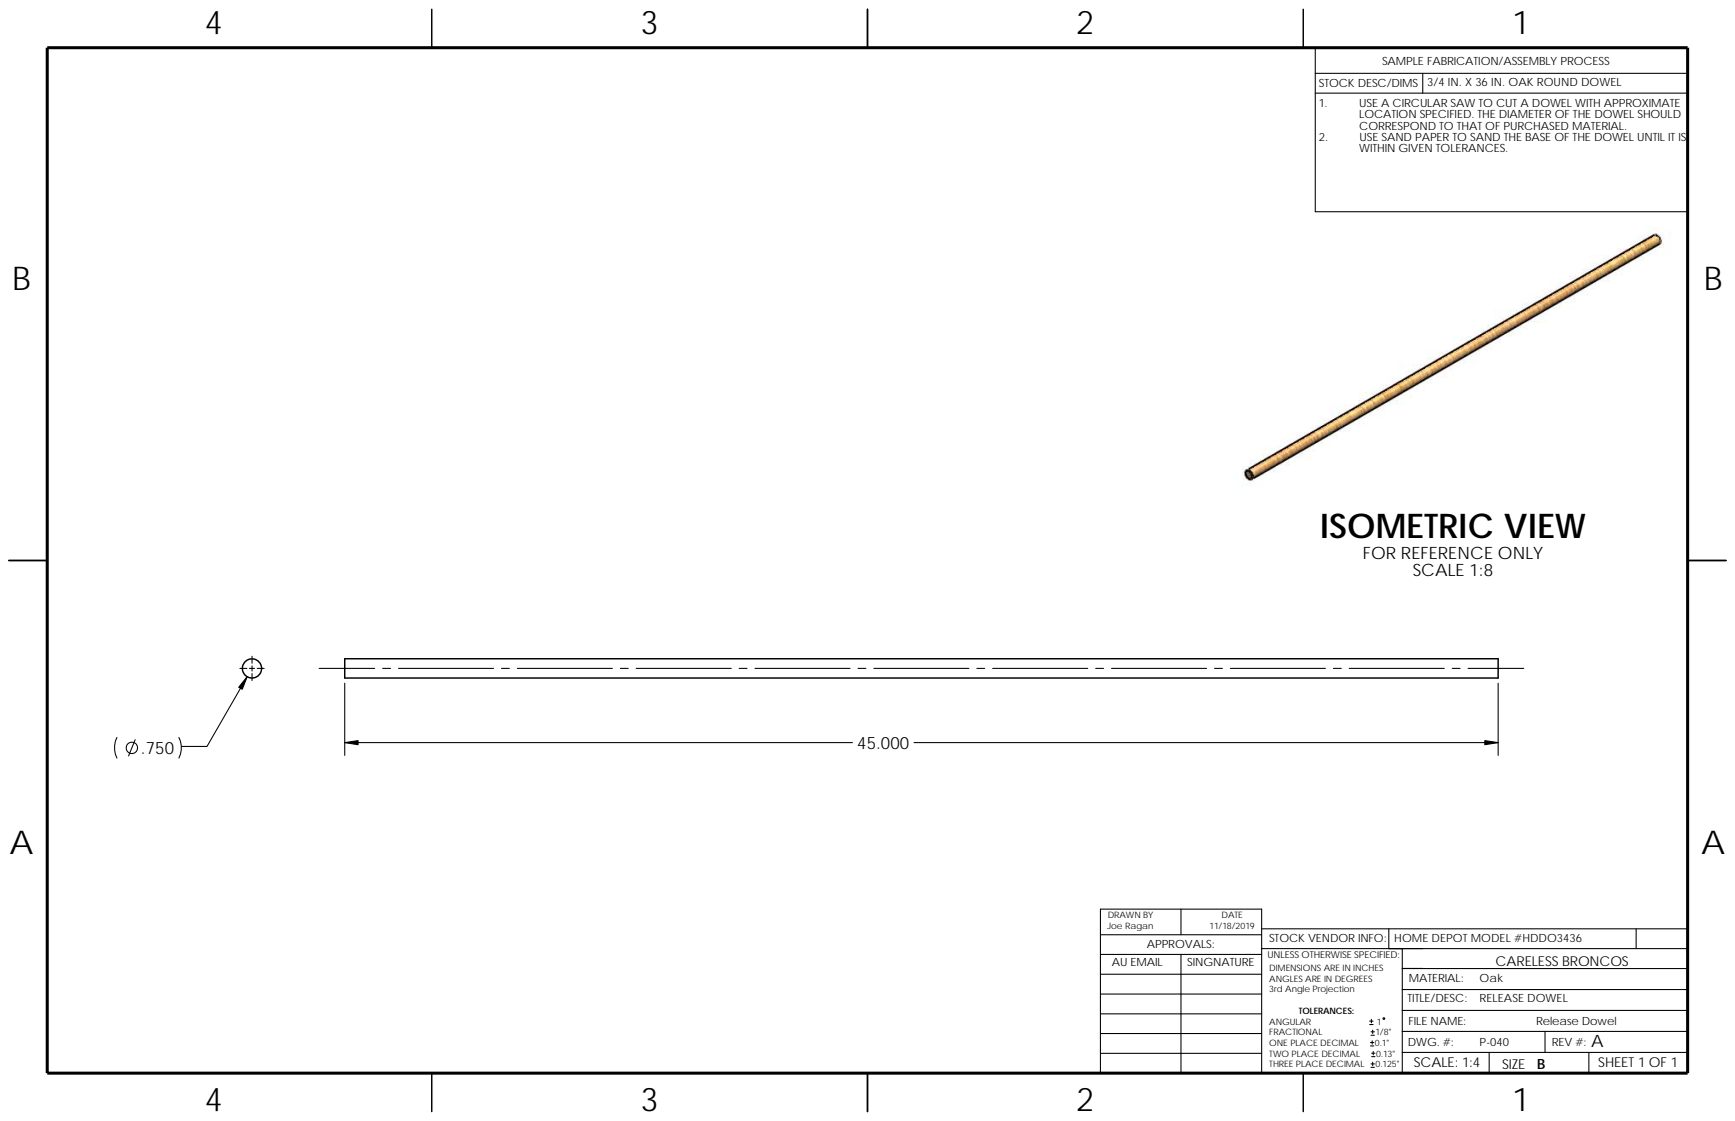
[picture p129: page 1]
RELEASE DOWEL; Oak; CARELESS BRONCOS; TITLE/DESC:; FILE NAME:; APPROVALS:; AU EMAIL; SINGNATURE; MATERIAL:; Release Dowel; ANGULAR; FRACTIONAL; ONE PLACE DECIMAL

SAMPLE FABRICATION/ASSEMBLY PROCESS

STOCK DESC/DIMS | 3/4 IN. X 36 IN. OAK ROUND DOWEL

1. USE A CIRCULAR SAW TO CUT A DOWEL WITH APPROXIMATE
LOCATION SPECIFIED. THE DIAMETER OF THE DOWEL SHOULD
CORRESPOND TO THAT OF PURCHASED MATERIAL.
2. USE SAND PAPER TO SAND THE BASE OF THE DOWEL UNTIL IT IS
WITHIN GIVEN TOLERANCES.

ISOMETRIC VIEW
FOR REFERENCE ONLY
SCALE 1:8

DRAWN BY Joe Ragan | DATE 11/18/2019

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

HOME DEPOT MODEL #HDDO3436

TOLERANCES:
TWO PLACE DECIMAL
THREE PLACE DECIMAL

DWG. #: P-040 | A REV #:
SCALE: 1:4 | SIZE B | SHEET 1 OF 1
