flasch97/Gravity-Vehicle/RELEASE HOOK - B-sized Sheet.pdf

4

3

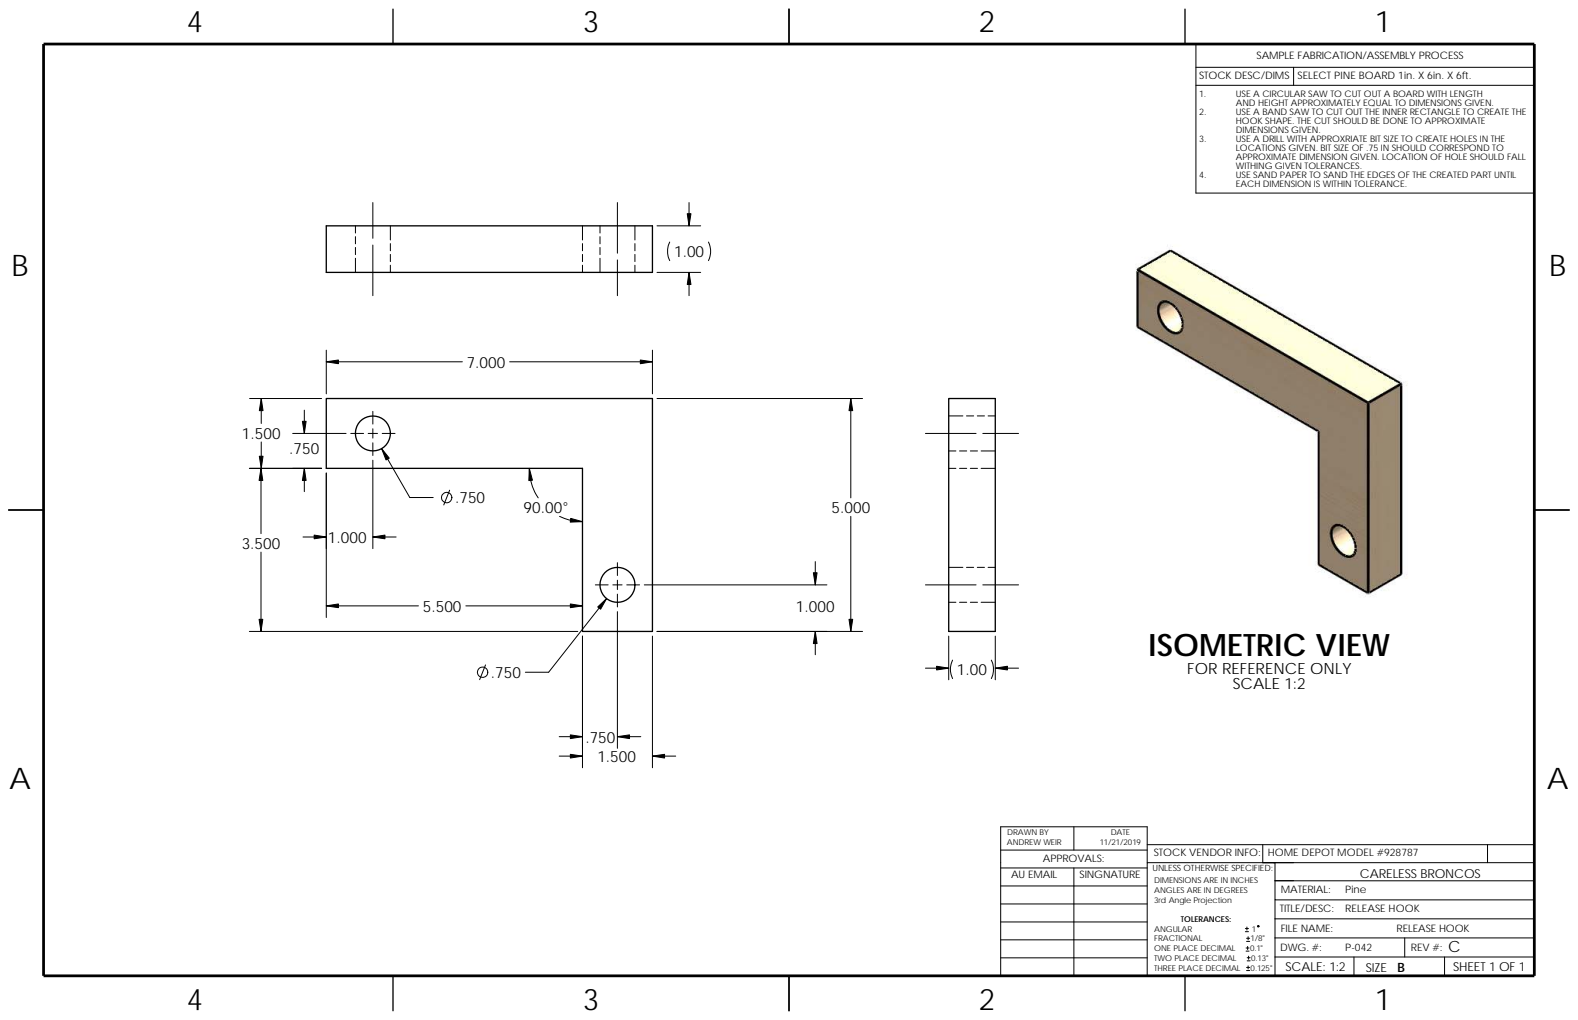
[picture p130: page 1]
RELEASE HOOK; Pine; CARELESS BRONCOS; TITLE/DESC:; FILE NAME:; SINGNATURE; AU EMAIL; APPROVALS:; MATERIAL:

SAMPLE FABRICATION/ASSEMBLY PROCESS

STOCK DESC/DIMS | SELECT PINE BOARD 1in. X 6in. X 6ft.

1. USE A CIRCULAR SAW TO CUT OUT A BOARD WITH LENGTH
2. USE A BAND SAW TO CUT OUT THE INNER RECTANGLE TO CREATE THE

AND HEIGHT APPROXIMATELY EQUAL TO DIMENSIONS GIVEN.
HOOK SHAPE. THE CUT SHOULD BE DONE TO APPROXIMATE
DIMENSIONS GIVEN.
LOCATIONS GIVEN. BIT SIZE OF .75 IN SHOULD CORRESPOND TO
APPROXIMATE DIMENSION GIVEN. LOCATION OF HOLE SHOULD FALL
WITHING GIVEN TOLERANCES.
EACH DIMENSION IS WITHIN TOLERANCE.

3. USE A DRILL WITH APPROXRIATE BIT SIZE TO CREATE HOLES IN THE

4. USE SAND PAPER TO SAND THE EDGES OF THE CREATED PART UNTIL

ISOMETRIC VIEW
FOR REFERENCE ONLY
SCALE 1:2

DRAWN BY ANDREW WEIR | DATE 11/21/2019

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

HOME DEPOT MODEL #928787

TOLERANCES:
ANGULAR
FRACTIONAL
ONE PLACE DECIMAL
TWO PLACE DECIMAL
THREE PLACE DECIMAL

DWG. #: P-042 | C REV #:
SCALE: 1:2 | SIZE B | SHEET 1 OF 1
