flasch97/Gravity-Vehicle/Release Mechanism - B-sized She.pdf

2
3

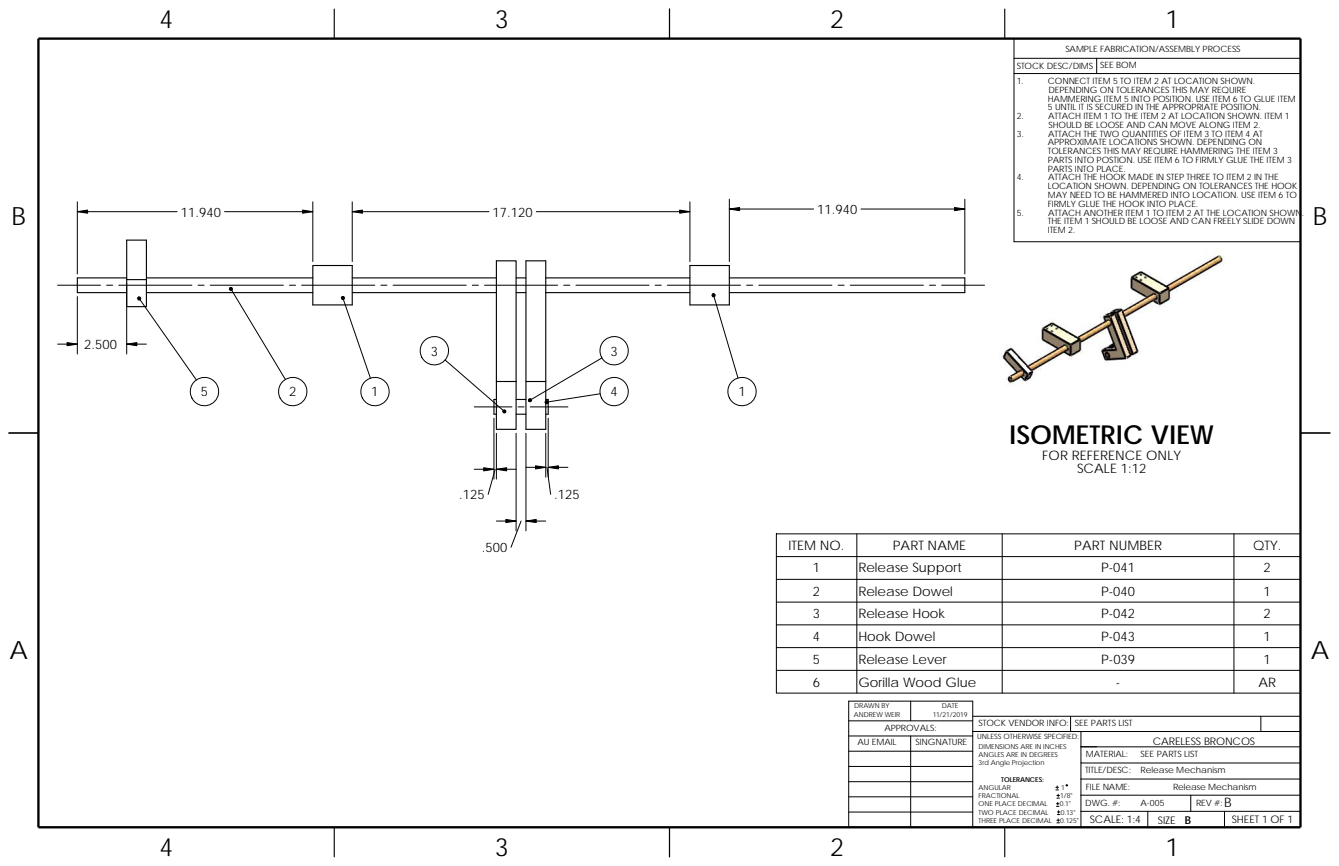
[picture p131: page 1]
ITEM NO.; PART NAME; PART NUMBER; QTY.; Release Support; Release Dowel; Release Hook; Hook Dowel; Release Lever; Gorilla Wood Glue; TITLE/DESC:; FILE NAME:; 3rd Angle Projection; MATERIAL:; APPROVALS:; FRACTIONAL

SAMPLE FABRICATION/ASSEMBLY PROCESS

STOCK DESC/DIMS | SEE BOM

1. CONNECT ITEM 5 TO ITEM 2 AT LOCATION SHOWN.
DEPENDING ON TOLERANCES THIS MAY REQUIRE
HAMMERING ITEM 5 INTO POSITION. USE ITEM 6 TO GLUE ITEM
5 UNTIL IT IS SECURED IN THE APPROPRIATE POSITION.
2. ATTACH ITEM 1 TO THE ITEM 2 AT LOCATION SHOWN. ITEM 1
SHOULD BE LOOSE AND CAN MOVE ALONG ITEM 2.
3. ATTACH THE TWO QUANTITIES OF ITEM 3 TO ITEM 4 AT
APPROXIMATE LOCATIONS SHOWN. DEPENDING ON
TOLERANCES THIS MAY REQUIRE HAMMERING THE ITEM 3
PARTS INTO POSTION. USE ITEM 6 TO FIRMLY GLUE THE ITEM 3
PARTS INTO PLACE.
4. ATTACH THE HOOK MADE IN STEP THREE TO ITEM 2 IN THE
LOCATION SHOWN. DEPENDING ON TOLERANCES THE HOOK
MAY NEED TO BE HAMMERED INTO LOCATION. USE ITEM 6 TO
FIRMLY GLUE THE HOOK INTO PLACE.
5. ATTACH ANOTHER ITEM 1 TO ITEM 2 AT THE LOCATION SHOWN.
THE ITEM 1 SHOULD BE LOOSE AND CAN FREELY SLIDE DOWN
ITEM 2.

ISOMETRIC VIEW
FOR REFERENCE ONLY
SCALE 1:12

DRAWN BY ANDREW WEIR | DATE 11/21/2019

STOCK VENDOR INFO: | SEE PARTS LIST
ANGLES ARE IN DEGREES | CARELESS BRONCOS

UNLESS OTHERWISE SPECIFIED:
DIMENSIONS ARE IN INCHES

AU EMAIL | SINGNATURE

SEE PARTS LIST
Release Mechanism

TOLERANCES:
ANGULAR
ONE PLACE DECIMAL
TWO PLACE DECIMAL
THREE PLACE DECIMAL

DWG. #: A-005 | B REV #:
SCALE: 1:4 | SIZE B | SHEET 1 OF 1
