flasch97/Gravity-Vehicle/Release support - B-sized Sheet.pdf

0

4X .125

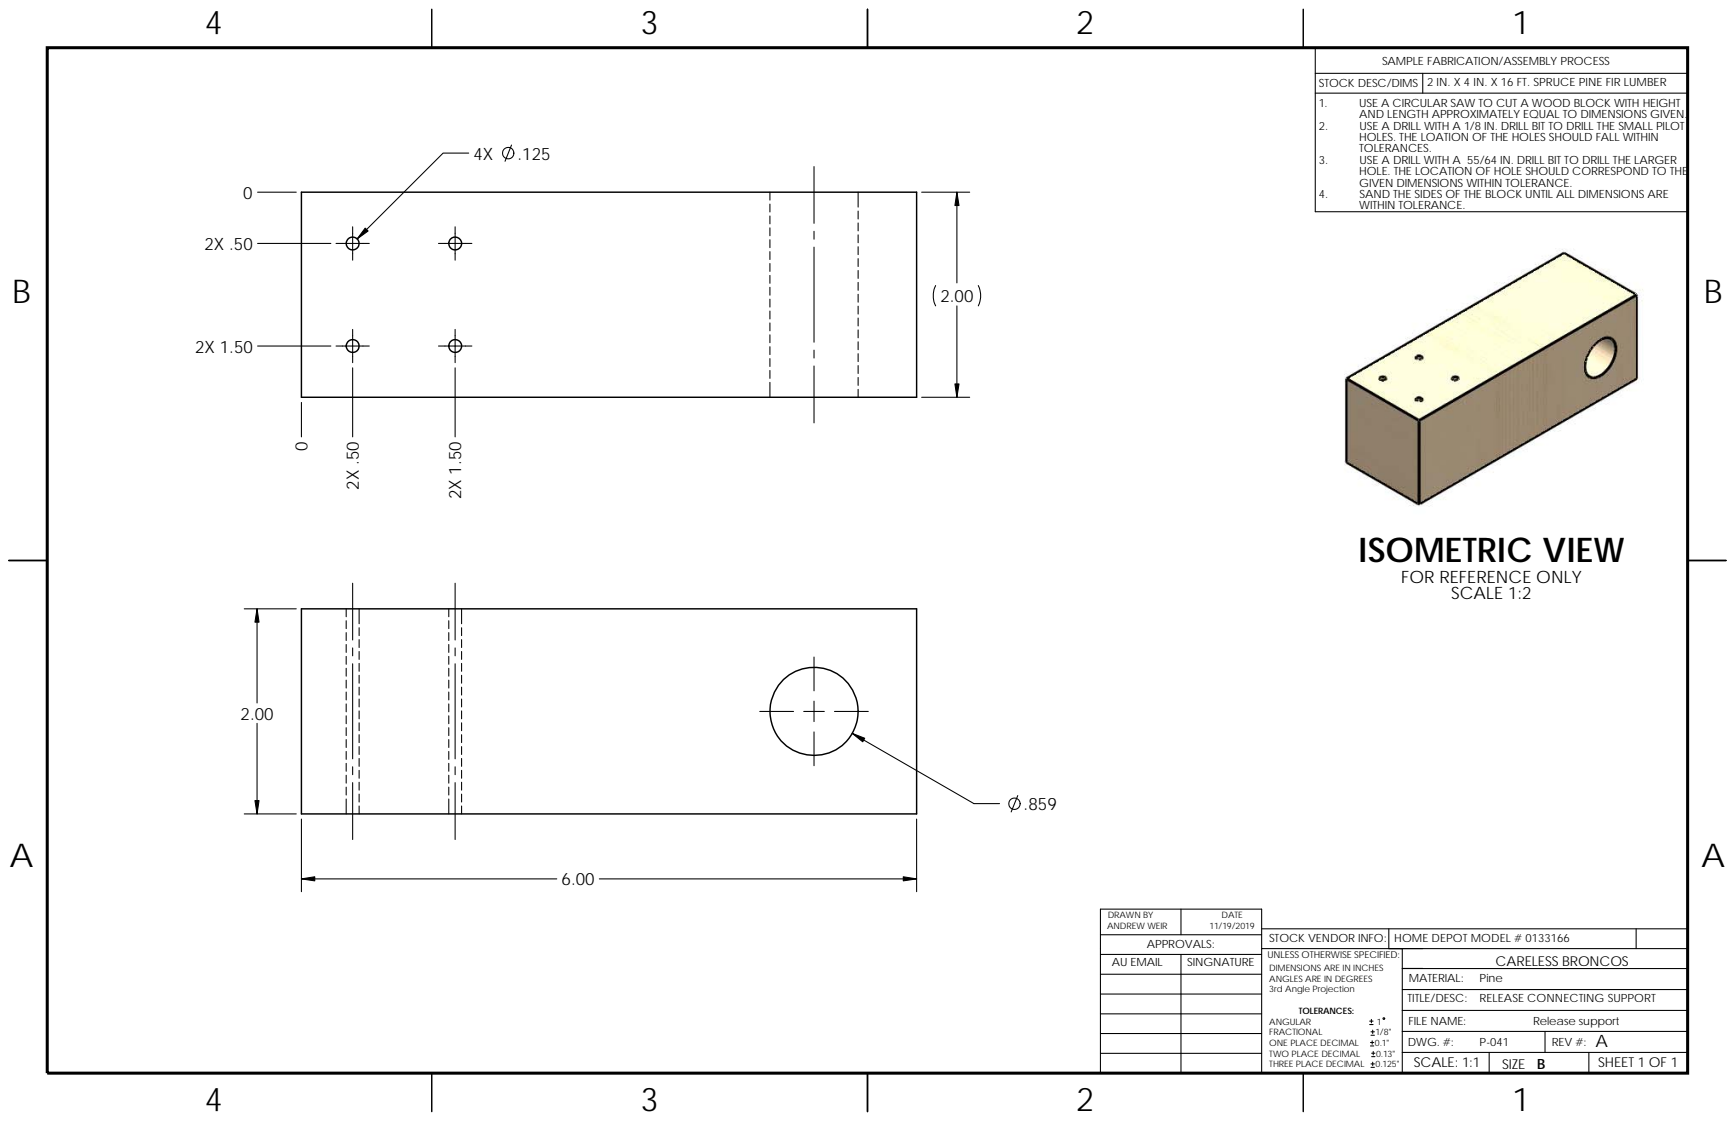
[picture p132: page 1]
ANDREW WEIR; TITLE/DESC:; FILE NAME:; Release support; SHEET 1 OF 1; SINGNATURE; SCALE: 1:1; DWG. #:; AU EMAIL; SIZE; APPROVALS:; MATERIAL:; DRAWN BY; DATE; ANGULAR; REV #:

SAMPLE FABRICATION/ASSEMBLY PROCESS

STOCK DESC/DIMS
1. USE A CIRCULAR SAW TO CUT A WOOD BLOCK WITH HEIGHT
AND LENGTH APPROXIMATELY EQUAL TO DIMENSIONS GIVEN.
2. USE A DRILL WITH A 1/8 IN. DRILL BIT TO DRILL THE SMALL PILOT
HOLES. THE LOATION OF THE HOLES SHOULD FALL WITHIN
TOLERANCES.
3. USE A DRILL WITH A 55/64 IN. DRILL BIT TO DRILL THE LARGER
HOLE. THE LOCATION OF HOLE SHOULD CORRESPOND TO THE
GIVEN DIMENSIONS WITHIN TOLERANCE.
4. SAND THE SIDES OF THE BLOCK UNTIL ALL DIMENSIONS ARE
WITHIN TOLERANCE.

2 IN. X 4 IN. X 16 FT. SPRUCE PINE FIR LUMBER

ISOMETRIC VIEW
FOR REFERENCE ONLY
SCALE 1:2

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

HOME DEPOT MODEL # 0133166

CARELESS BRONCOS
Pine
RELEASE CONNECTING SUPPORT

TOLERANCES:
FRACTIONAL
ONE PLACE DECIMAL
TWO PLACE DECIMAL
THREE PLACE DECIMAL
