flasch97/Gravity-Vehicle/Sight wood screw - B-sized Shee.pdf

4

3

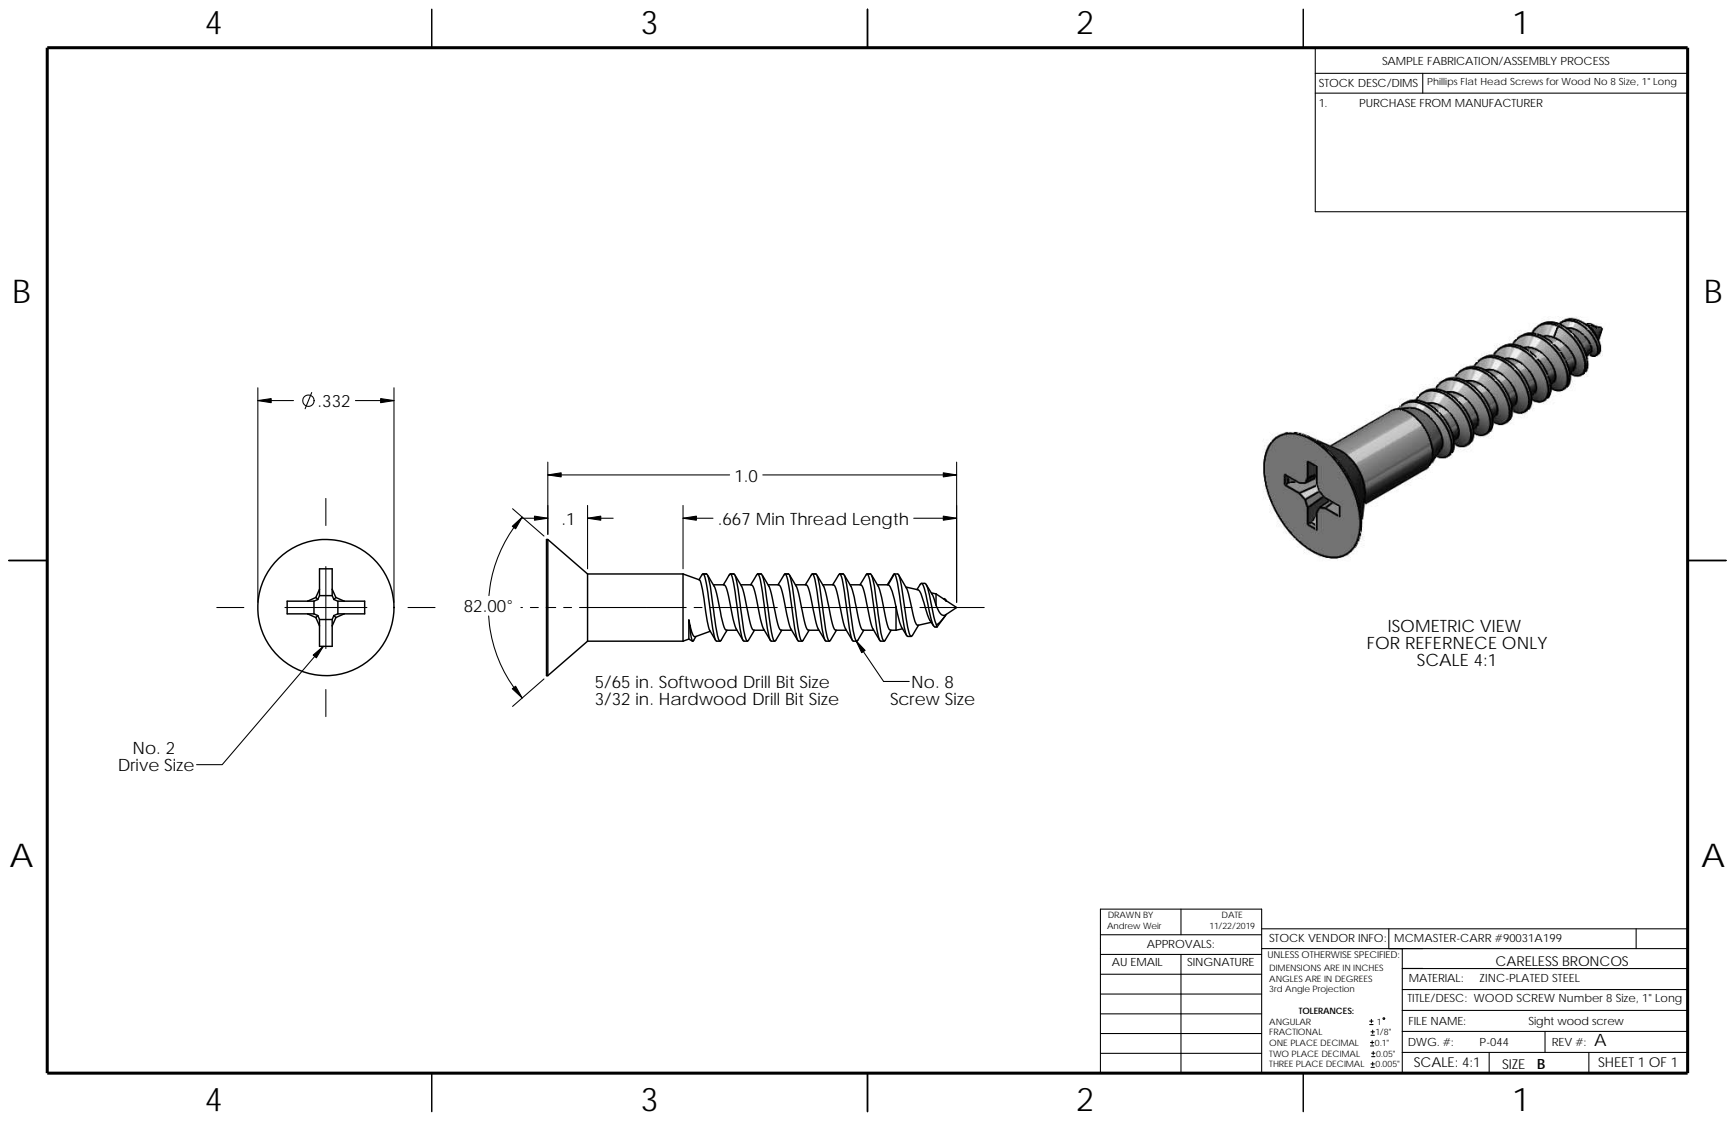
[picture p133: page 1]
No. 8 Screw Size; No. 2 Drive Size; TITLE/DESC:; FILE NAME:; AU EMAIL; MATERIAL:; APPROVALS:; SINGNATURE; ANGULAR; FRACTIONAL; ONE PLACE DECIMAL; TWO PLACE DECIMAL

SAMPLE FABRICATION/ASSEMBLY PROCESS

STOCK DESC/DIMS | Phillips Flat Head Screws for Wood No 8 Size, 1" Long

PURCHASE FROM MANUFACTURER

.667 Min Thread Length

ISOMETRIC VIEW
FOR REFERNECE ONLY
SCALE 4:1

5/65 in. Softwood Drill Bit Size
3/32 in. Hardwood Drill Bit Size

DRAWN BY Andrew Weir | DATE 11/22/2019

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

MCMASTER-CARR #90031A199

CARELESS BRONCOS
ZINC-PLATED STEEL
WOOD SCREW Number 8 Size, 1" Long

TOLERANCES:
THREE PLACE DECIMAL

Sight wood screw

DWG. #: P-044 | A REV #:
SCALE: 4:1 | SIZE B | SHEET 1 OF 1
