flasch97/Gravity-Vehicle/Smaller Wood Screw - B-sized Sh.pdf

4 | 3 | 2

1

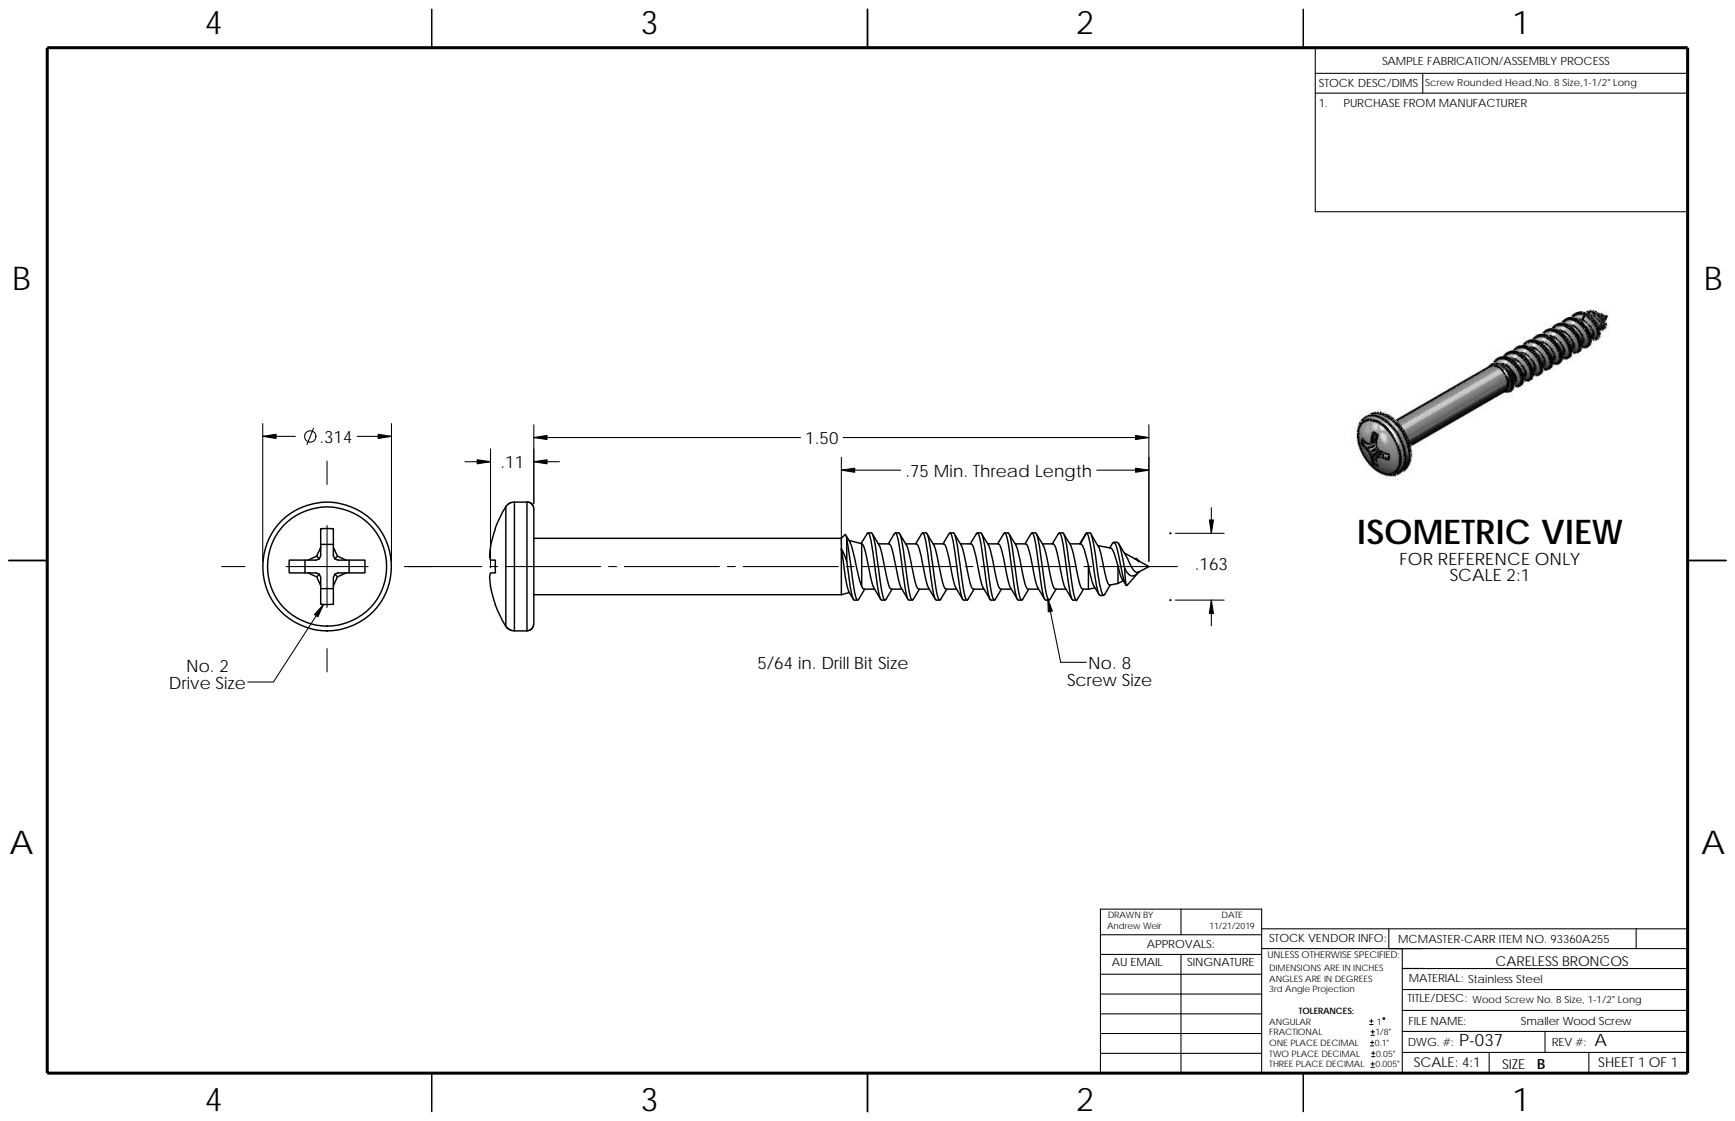
[picture p134: page 1]
TITLE/DESC:; FILE NAME:; MATERIAL:; APPROVALS:; AU EMAIL; DIMENSIONS ARE IN INCHES; 3rd Angle Projection; ANGULAR; FRACTIONAL; ONE PLACE DECIMAL; TWO PLACE DECIMAL; No. 2 Drive Size; No. 8 Screw Size; .75 Min. Thread Length

SAMPLE FABRICATION/ASSEMBLY PROCESS

STOCK DESC/DIMS | Screw Rounded Head,No. 8 Size,1-1/2" Long

1. PURCHASE FROM MANUFACTURER

ISOMETRIC VIEW
FOR REFERENCE ONLY
SCALE 2:1

5/64 in. Drill Bit Size

DRAWN BY Andrew Weir | DATE 11/21/2019

STOCK VENDOR INFO: | MCMASTER-CARR ITEM NO. 93360A255
ANGLES ARE IN DEGREES | CARELESS BRONCOS

UNLESS OTHERWISE SPECIFIED:

SINGNATURE

Stainless Steel
Wood Screw No. 8 Size, 1-1/2" Long

TOLERANCES:
THREE PLACE DECIMAL

Smaller Wood Screw

P-037 DWG. #: | A REV #:
SCALE: 4:1 | SIZE B | SHEET 1 OF 1
