flasch97/Gravity-Vehicle/Final PDF/A8 Ramp and Car.PDF

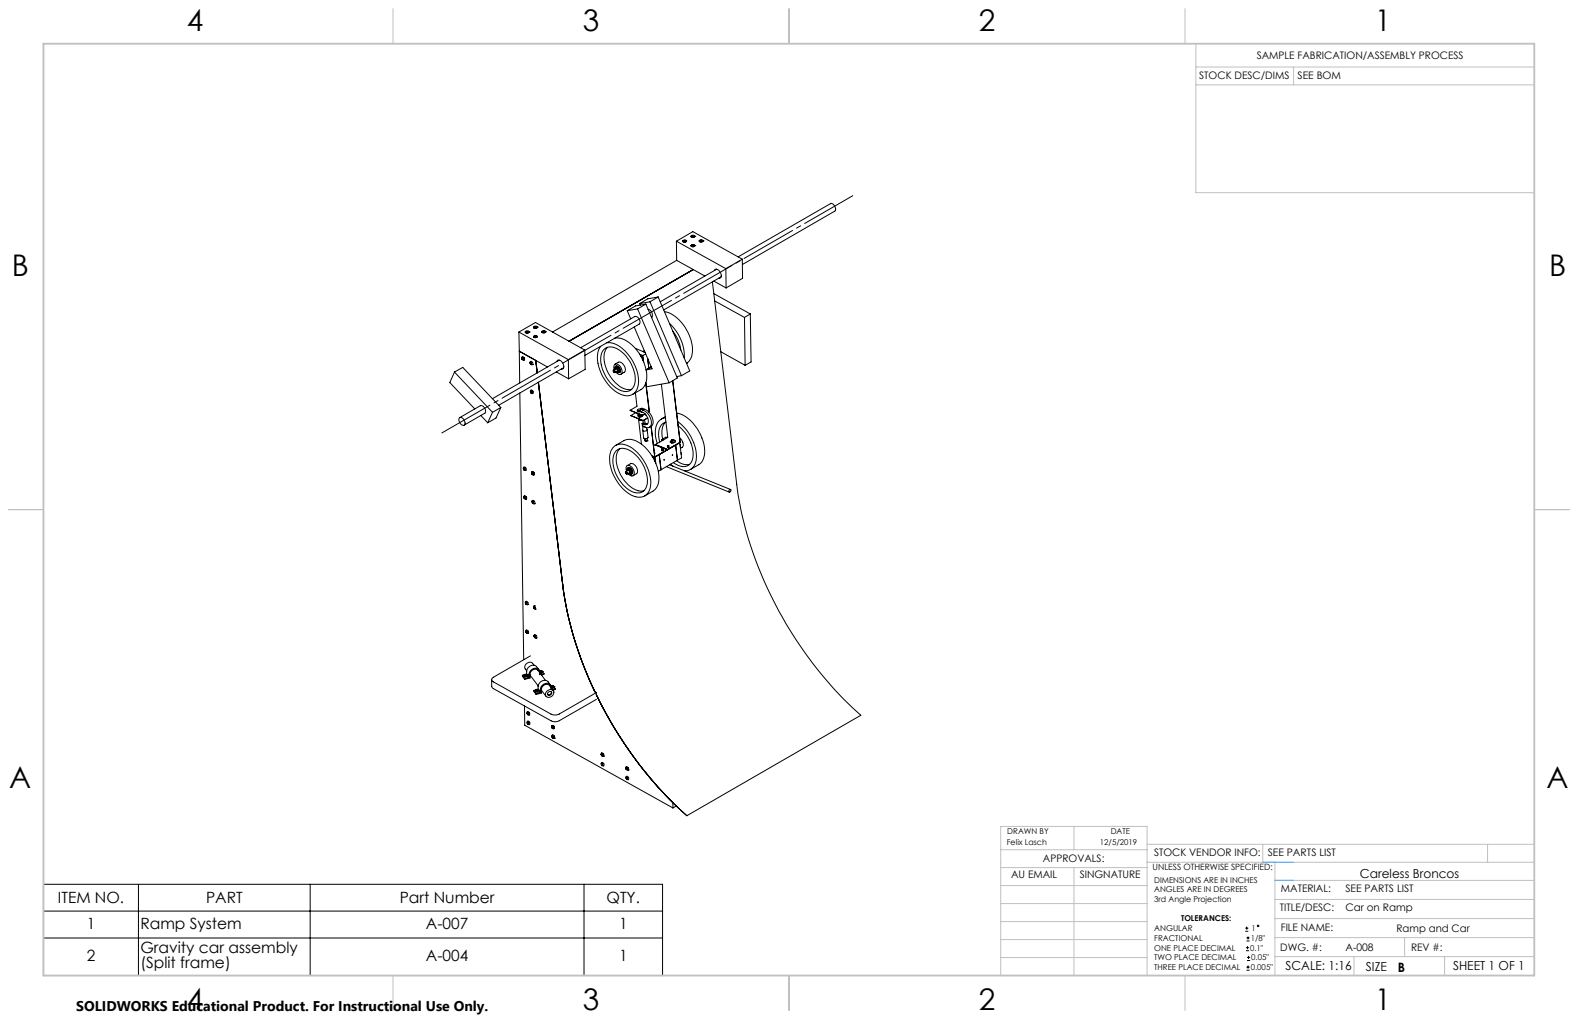
[picture p135: page 1]
Gravity car assembly; (Split frame); Felix Lasch; FILE NAME:; DRAWN BY; DATE; DWG. #:; SCALE: 1:16; SHEET 1 OF 1

SAMPLE FABRICATION/ASSEMBLY PROCESS

STOCK DESC/DIMS | SEE BOM

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

AU EMAIL | SINGNATURE

DIMENSIONS ARE IN INCHES

SEE PARTS LIST
Car on Ramp

ITEM NO. | PART | Part Number | QTY.
1 | Ramp System | A-007 | 1

Ramp and Car
REV #:
SIZE B

SOLIDWORKS Educational Product. For Instructional Use Only.
