flasch97/Gravity-Vehicle/Final PDF/A7 Ramp System.PDF

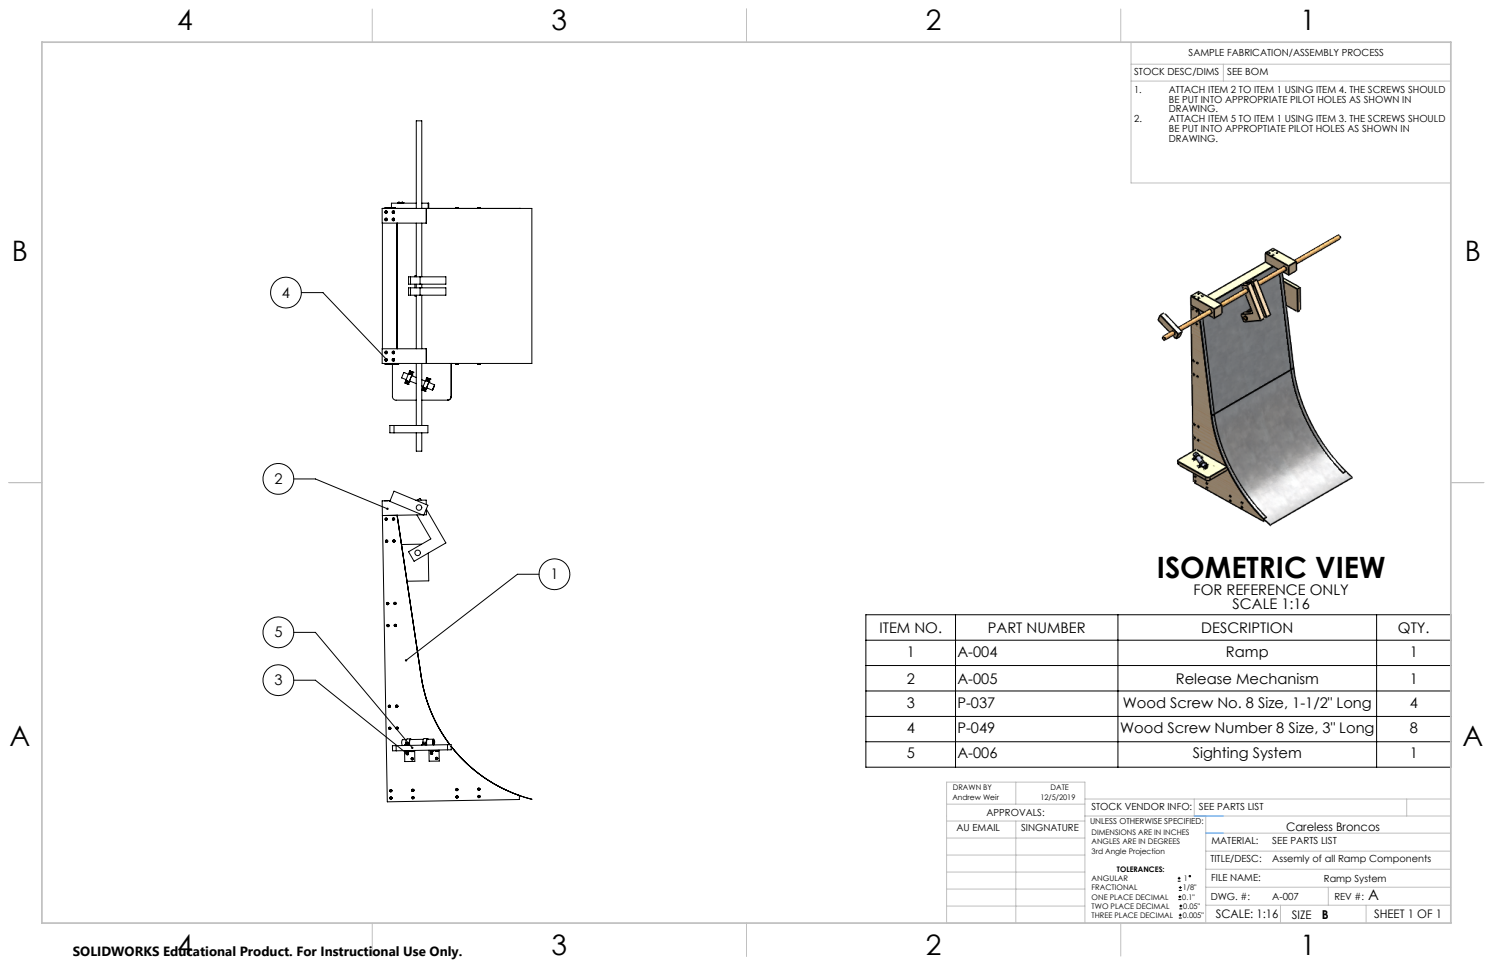
[picture p138: page 1]
Andrew Weir; FILE NAME:; DRAWN BY; DATE; Ramp System; AU EMAIL; SINGNATURE

SAMPLE FABRICATION/ASSEMBLY PROCESS

STOCK DESC/DIMS | SEE BOM

1. ATTACH ITEM 2 TO ITEM 1 USING ITEM 4. THE SCREWS SHOULD
BE PUT INTO APPROPRIATE PILOT HOLES AS SHOWN IN
DRAWING.
2. ATTACH ITEM 5 TO ITEM 1 USING ITEM 3. THE SCREWS SHOULD
BE PUT INTO APPROPTIATE PILOT HOLES AS SHOWN IN

ISOMETRIC VIEW
FOR REFERENCE ONLY
SCALE 1:16

ITEM NO. | PART NUMBER | DESCRIPTION | QTY.
1 | A-004 | Ramp | 1
2 | A-005 | Release Mechanism | 1
3 | P-037 | Wood Screw No. 8 Size, 1-1/2" Long | 4
4 | P-049 | Wood Screw Number 8 Size, 3" Long | 8
5 | A-006 | Sighting System | 1

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

DIMENSIONS ARE IN INCHES

SEE PARTS LIST
Assemly of all Ramp Components

DWG. #: A-007 | REV #: A
SCALE: 1:16 | SIZE B | SHEET 1 OF 1

SOLIDWORKS Educational Product. For Instructional Use Only.
