flasch97/Gravity-Vehicle/Final PDF/P49 Biggest Wood Screw.PDF

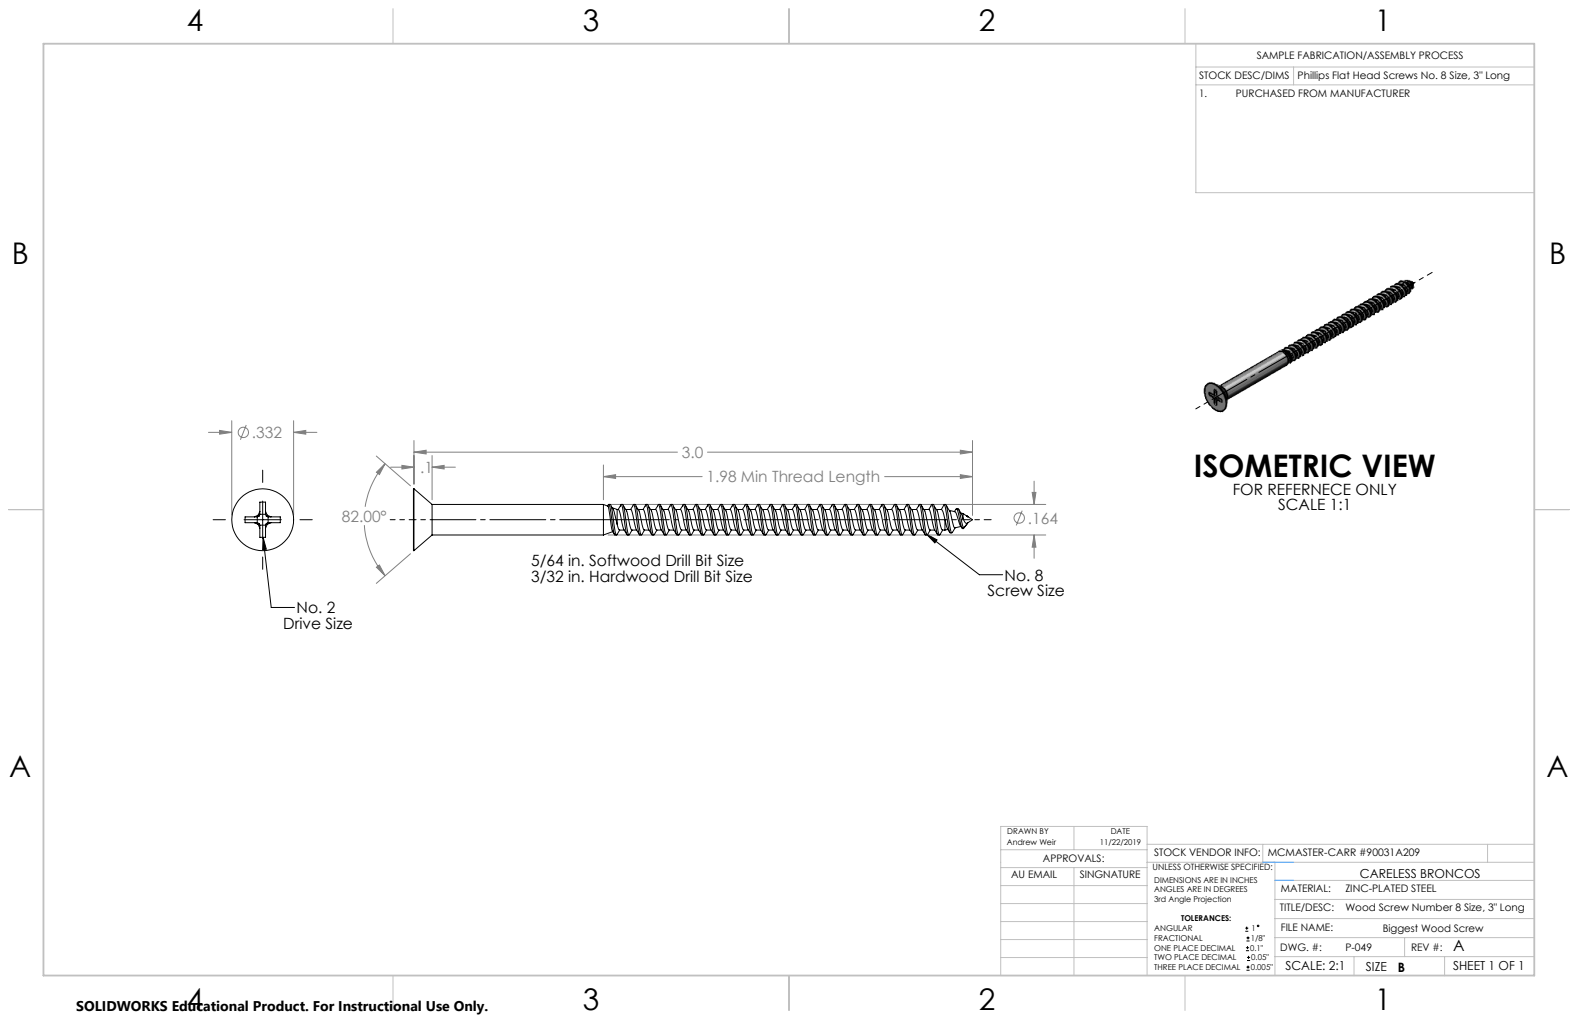
[picture p139: page 1]
1.98 Min Thread Length; No. 8 Screw Size; No. 2 Drive Size; Andrew Weir; FILE NAME:; DRAWN BY; DATE; AU EMAIL; SINGNATURE

SAMPLE FABRICATION/ASSEMBLY PROCESS

STOCK DESC/DIMS | Phillips Flat Head Screws No. 8 Size, 3" Long

1. PURCHASED FROM MANUFACTURER

ISOMETRIC VIEW
FOR REFERNECE ONLY
SCALE 1:1

5/64 in. Softwood Drill Bit Size
3/32 in. Hardwood Drill Bit Size

STOCK VENDOR INFO: | MCMASTER-CARR #90031A209
UNLESS OTHERWISE SPECIFIED: ANGLES ARE IN DEGREES 3rd Angle Projection TOLERANCES: ANGULAR 1 FRACTIONAL 1/8" ONE PLACE DECIMAL 0.1" TWO PLACE DECIMAL 0.05" THREE PLACE DECIMAL 0.005" | | CARELESS BRONCOS

DIMENSIONS ARE IN INCHES

ZINC-PLATED STEEL
Wood Screw Number 8 Size, 3" Long
Biggest Wood Screw

DWG. #: P-049 | A REV #:
SCALE: 2:1 | SIZE B | SHEET 1 OF 1

SOLIDWORKS Educational Product. For Instructional Use Only.
