flasch97/Gravity-Vehicle/Final PDF/P50 Compression Spring Break.PDF

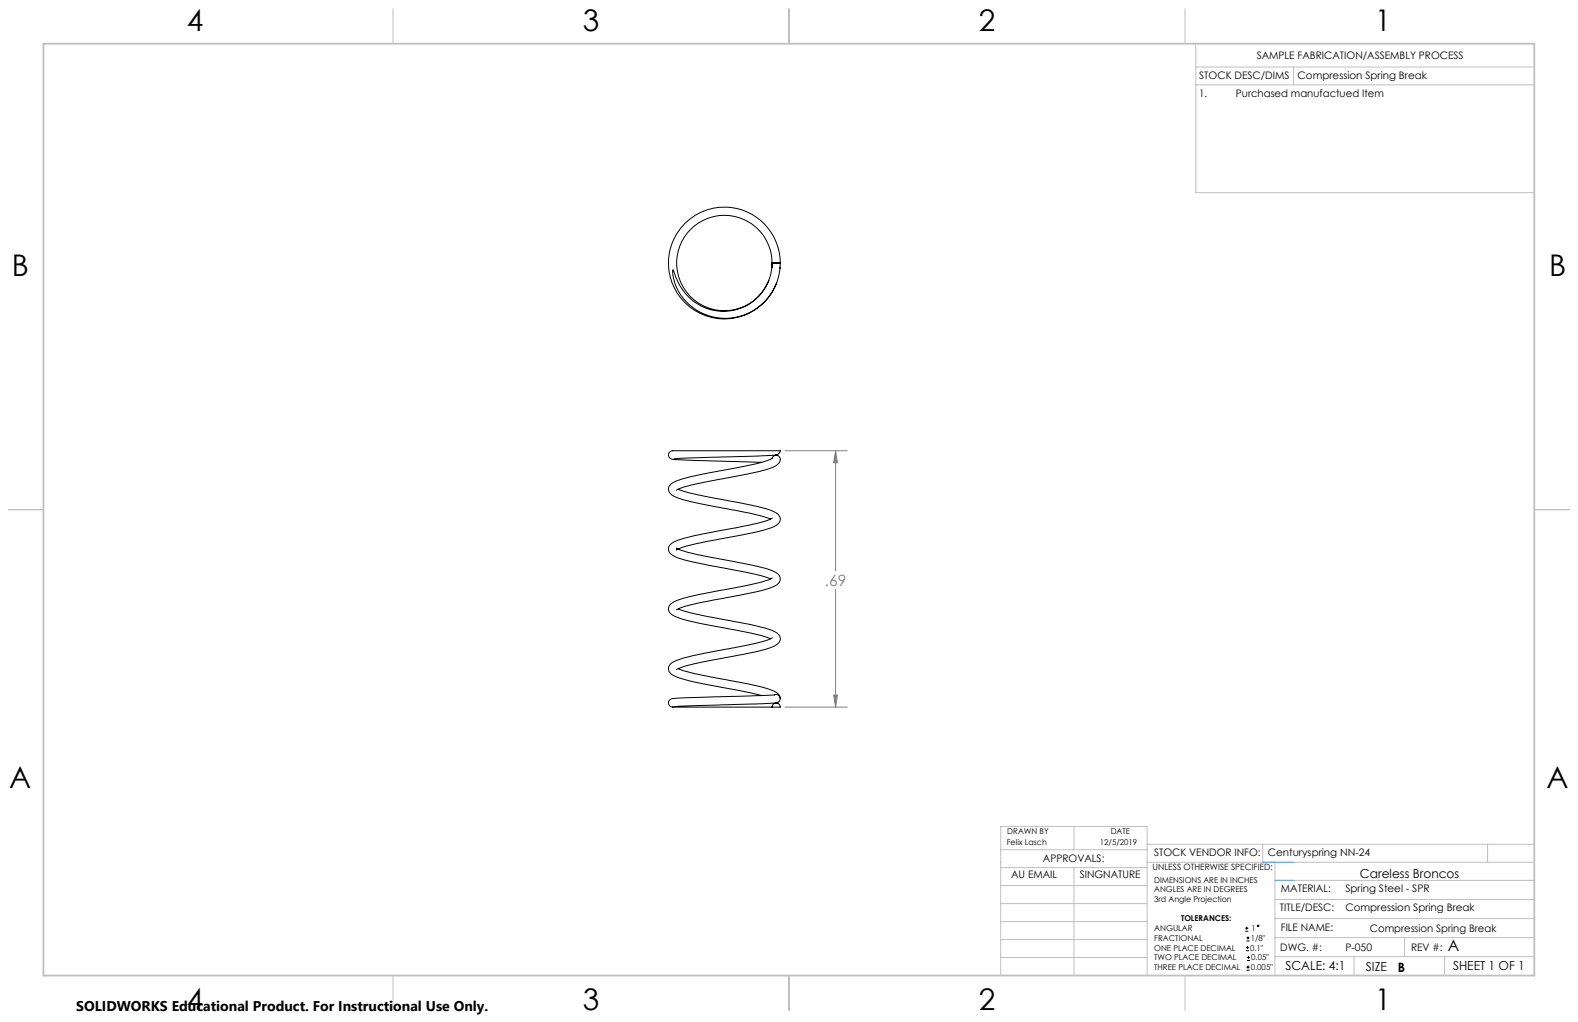
[picture p140: page 1]
Felix Lasch; FILE NAME:; DRAWN BY; DATE; AU EMAIL; SINGNATURE

SAMPLE FABRICATION/ASSEMBLY PROCESS

STOCK DESC/DIMS | Compression Spring Break

1. Purchased manufactued Item

STOCK VENDOR INFO: | Centuryspring NN-24
UNLESS OTHERWISE SPECIFIED: ANGLES ARE IN DEGREES 3rd Angle Projection TOLERANCES: ANGULAR 1 FRACTIONAL 1/8" ONE PLACE DECIMAL 0.1" TWO PLACE DECIMAL 0.05" THREE PLACE DECIMAL 0.005" | | Careless Broncos

DIMENSIONS ARE IN INCHES

Spring Steel - SPR
Compression Spring Break

DWG. #: P-050 | REV #: A
SCALE: 4:1 | SIZE B | SHEET 1 OF 1

SOLIDWORKS Educational Product. For Instructional Use Only.
