flasch97/Gravity-Vehicle/Final PDF/P27 Dovel Pin.PDF

Dowel Pin; AISI 1020; Felix Lasch; FILE NAME:; DRAWN BY; DATE; Dovel Pin; AU EMAIL; SINGNATURE

SAMPLE FABRICATION/ASSEMBLY PROCESS

STOCK DESC/DIMS | Dowel Pin

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

DIMENSIONS ARE IN INCHES

DWG. #: P-027 | REV #:
SCALE: 16:1 | SIZE B | SHEET 1 OF 1

SOLIDWORKS Educational Product. For Instructional Use Only.
