flasch97/Gravity-Vehicle/Drawings/316 Stainless Steel Washer.PDF

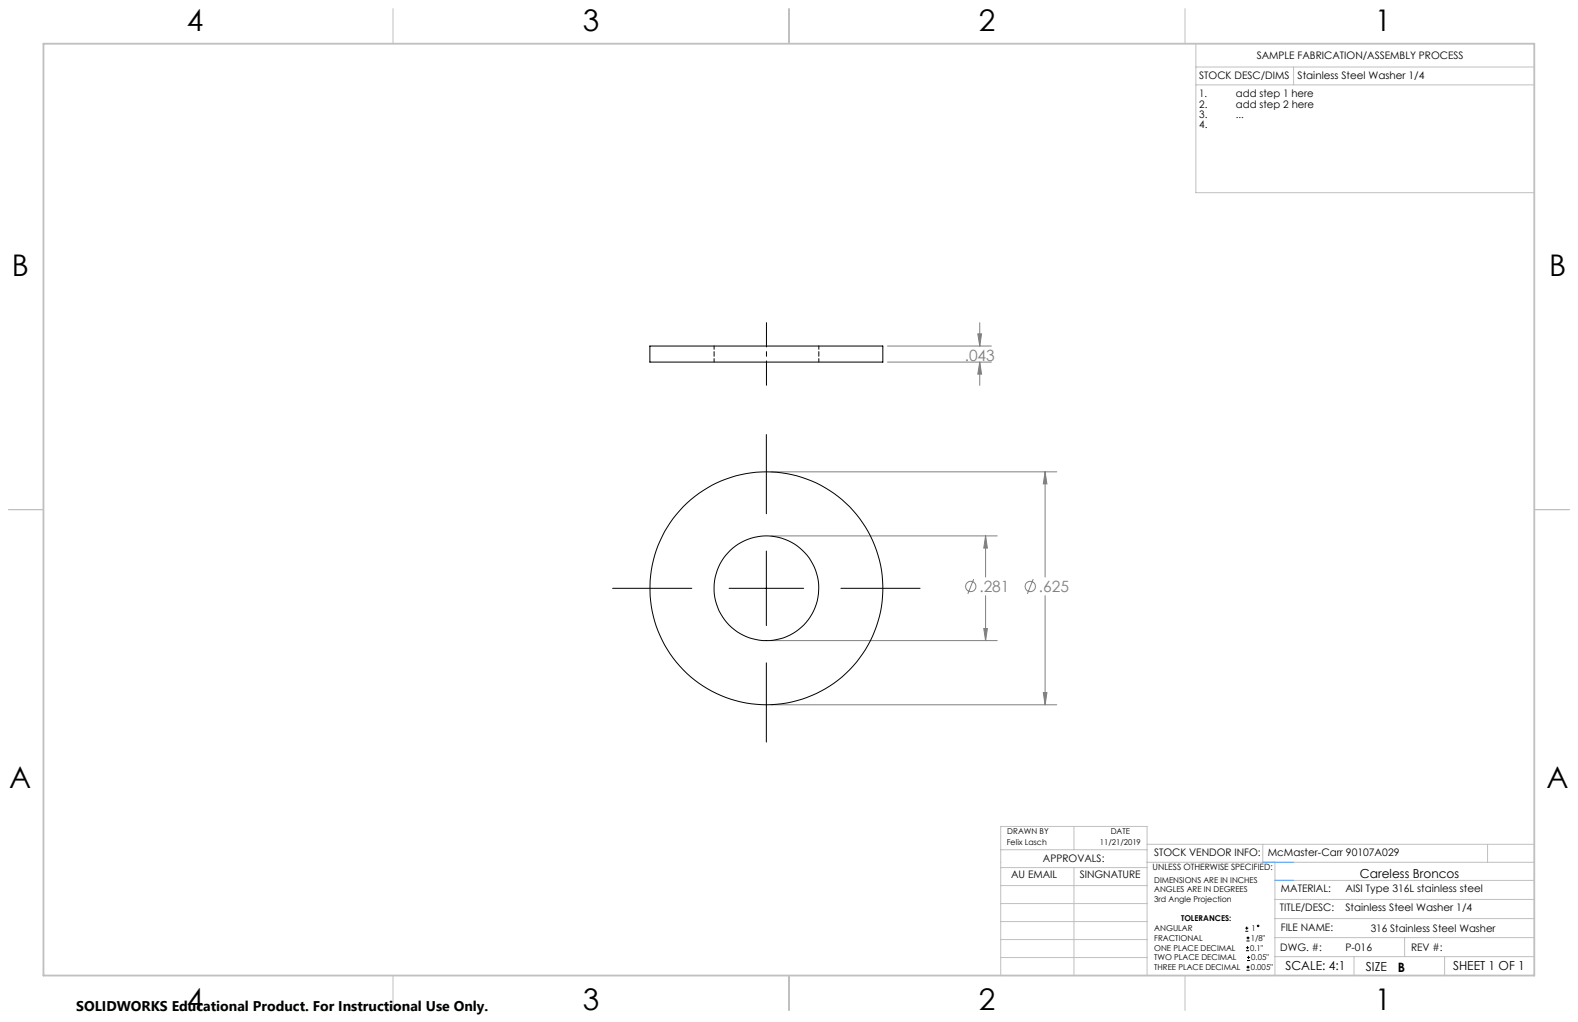
[picture p141: page 1]
Felix Lasch; FILE NAME:; DRAWN BY; DATE; AU EMAIL; SINGNATURE

SAMPLE FABRICATION/ASSEMBLY PROCESS

STOCK DESC/DIMS | Stainless Steel Washer 1/4

1. add step 1 here
2. add step 2 here

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

DIMENSIONS ARE IN INCHES

AISI Type 316L stainless steel
Stainless Steel Washer 1/4
316 Stainless Steel Washer

DWG. #: P-016 | REV #:
SCALE: 4:1 | SIZE B | SHEET 1 OF 1

SOLIDWORKS Educational Product. For Instructional Use Only.
