flasch97/Gravity-Vehicle/Drawings/Button Head Hex Screw 1-4-28.PDF

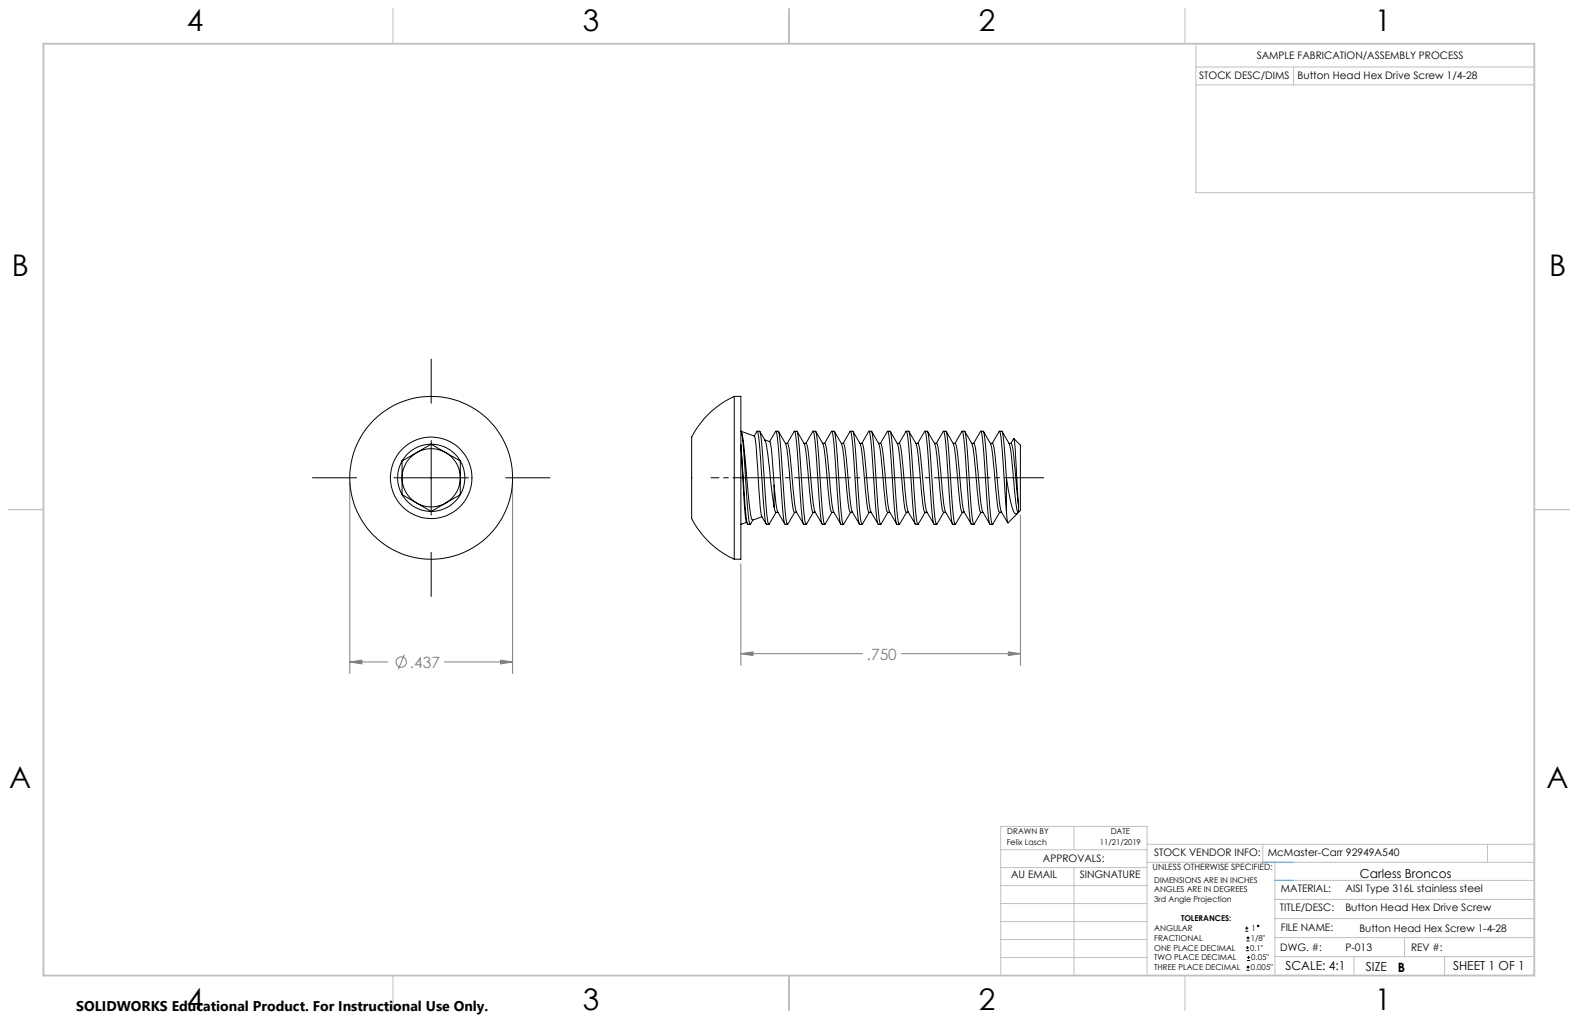
[picture p142: page 1]
Felix Lasch; FILE NAME:; DRAWN BY; DATE; AU EMAIL; SINGNATURE

SAMPLE FABRICATION/ASSEMBLY PROCESS

STOCK DESC/DIMS | Button Head Hex Drive Screw 1/4-28

STOCK VENDOR INFO: | McMaster-Carr 92949A540
UNLESS OTHERWISE SPECIFIED: ANGLES ARE IN DEGREES 3rd Angle Projection TOLERANCES: ANGULAR 1 FRACTIONAL 1/8" ONE PLACE DECIMAL 0.1" TWO PLACE DECIMAL 0.05" THREE PLACE DECIMAL 0.005" | | Carless Broncos

DIMENSIONS ARE IN INCHES

AISI Type 316L stainless steel
Button Head Hex Drive Screw
Button Head Hex Screw 1-4-28

DWG. #: P-013 | REV #:
SCALE: 4:1 | SIZE B | SHEET 1 OF 1

SOLIDWORKS Educational Product. For Instructional Use Only.
