flasch97/Gravity-Vehicle/Drawings/One-Way-Bearing.PDF

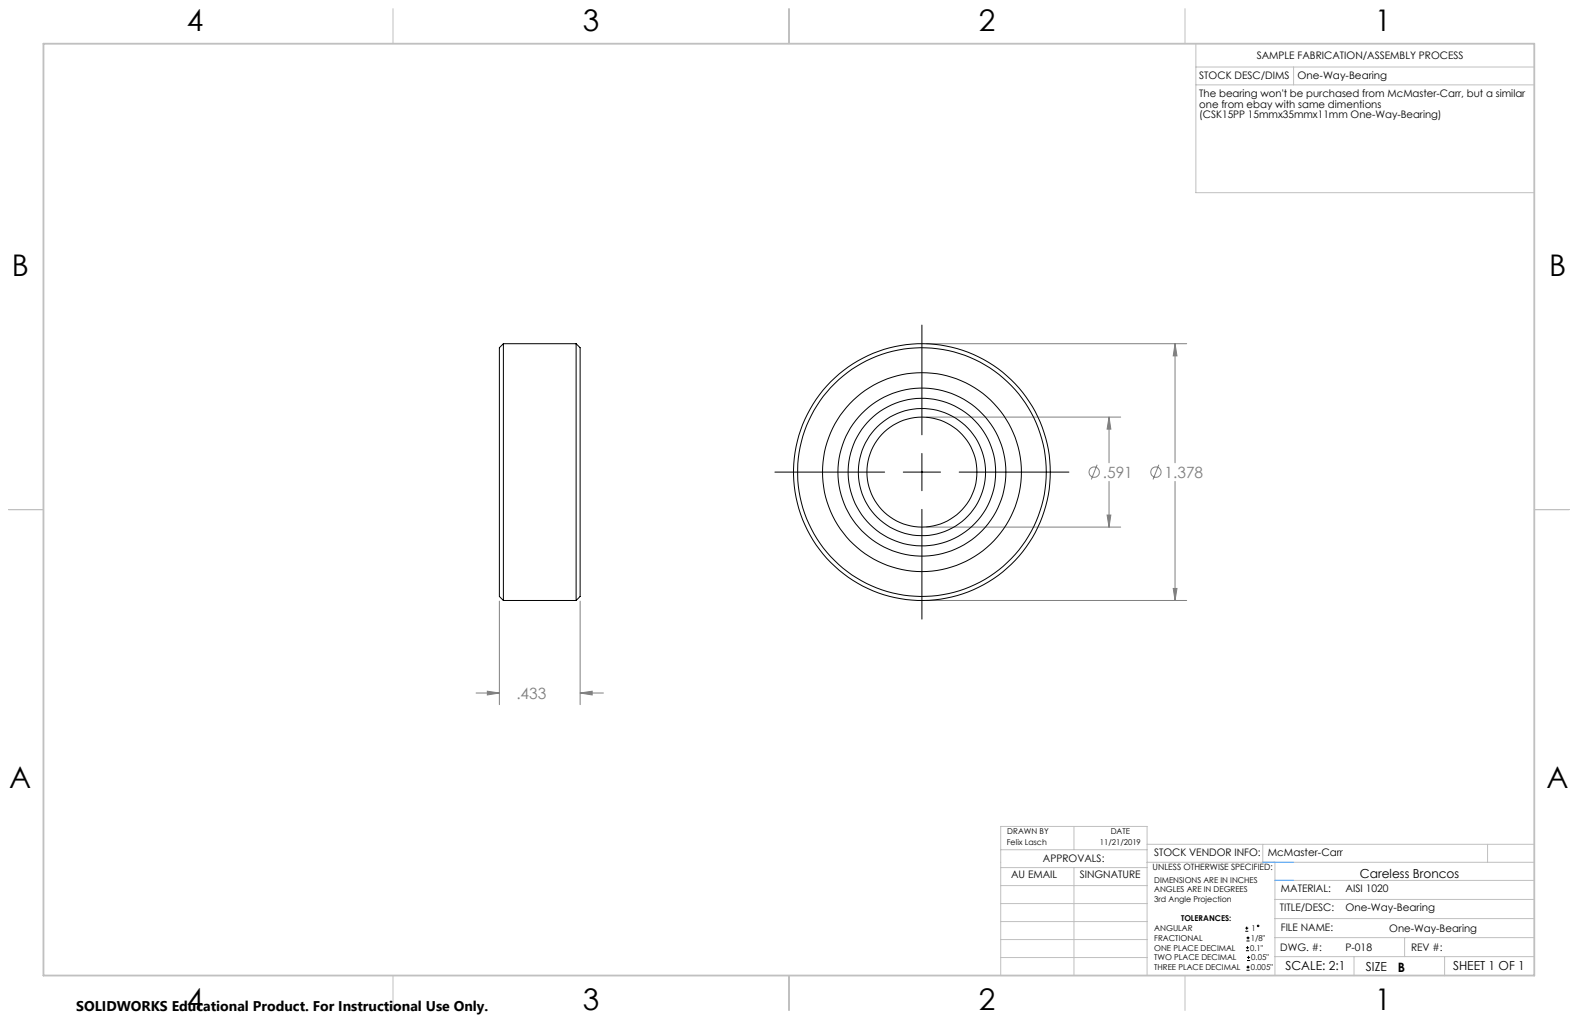
[picture p143: page 1]
Felix Lasch; FILE NAME:; DRAWN BY; DATE; AU EMAIL; SINGNATURE

SAMPLE FABRICATION/ASSEMBLY PROCESS

STOCK DESC/DIMS | One-Way-Bearing

The bearing won't be purchased from McMaster-Carr, but a similar
one from ebay with same dimentions
(CSK15PP 15mmx35mmx11mm One-Way-Bearing)

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

DIMENSIONS ARE IN INCHES

AISI 1020
One-Way-Bearing

DWG. #: P-018 | REV #:
SCALE: 2:1 | SIZE B | SHEET 1 OF 1

SOLIDWORKS Educational Product. For Instructional Use Only.
