flasch97/Gravity-Vehicle/Drawings/Stainless Steel Thin Hex Nut 1-4-28.PDF

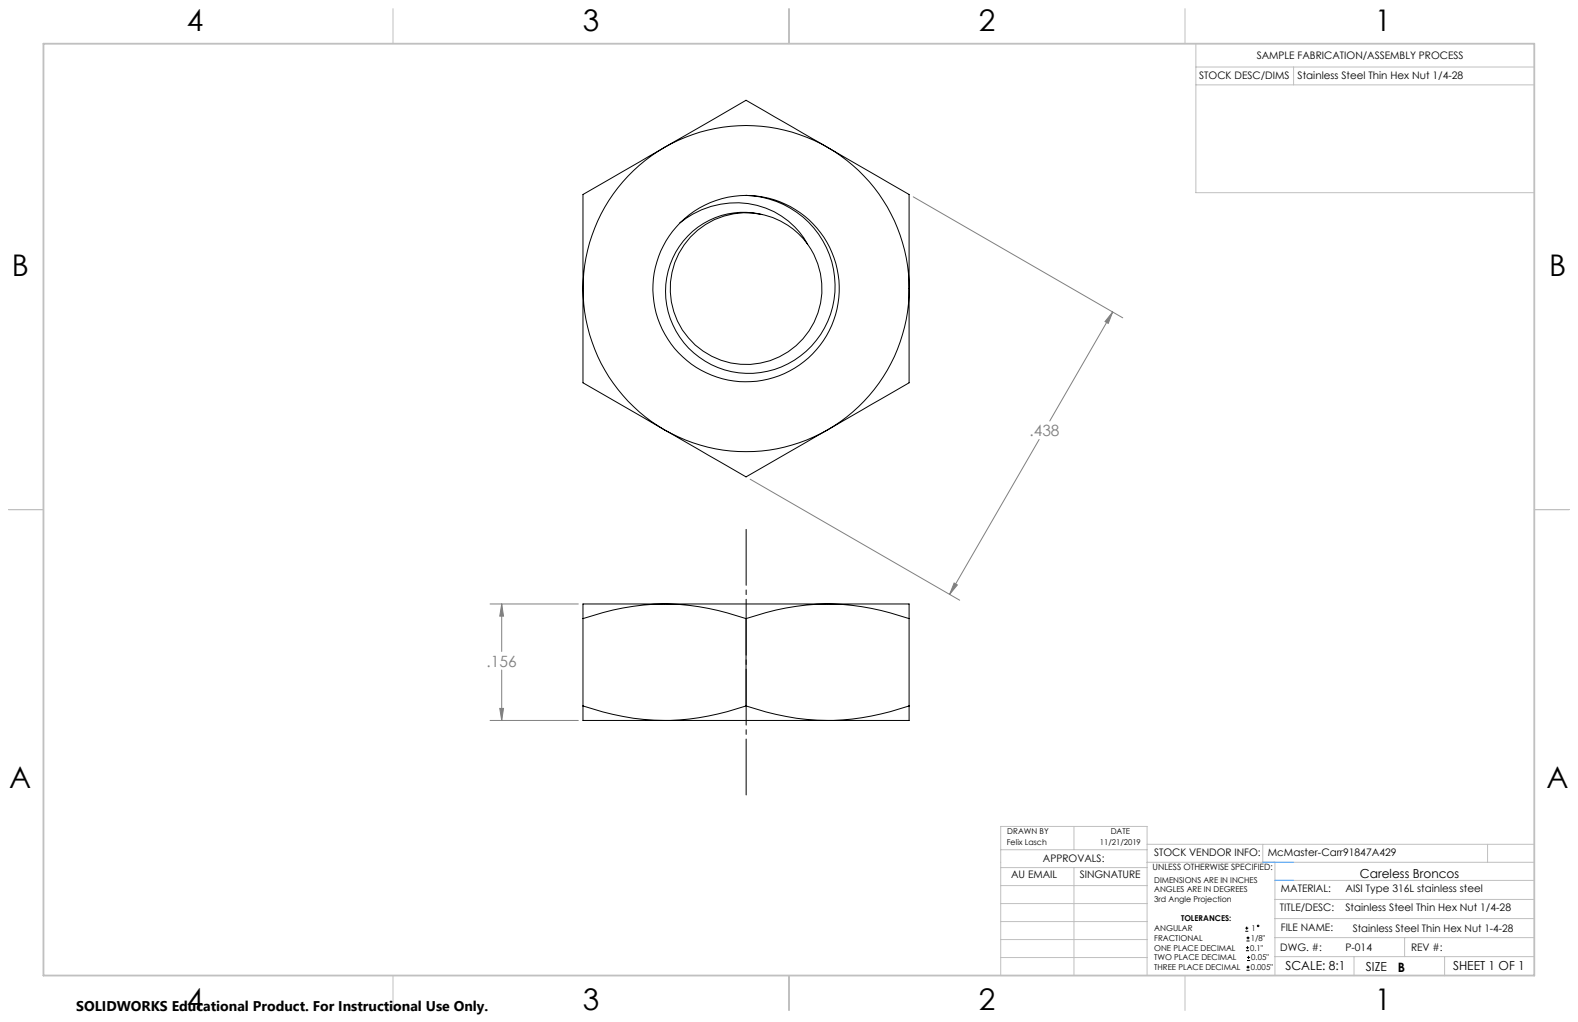
[picture p144: page 1]
Felix Lasch; FILE NAME:; DRAWN BY; DATE; AU EMAIL; SINGNATURE

SAMPLE FABRICATION/ASSEMBLY PROCESS

STOCK DESC/DIMS | Stainless Steel Thin Hex Nut 1/4-28

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

DIMENSIONS ARE IN INCHES

AISI Type 316L stainless steel
Stainless Steel Thin Hex Nut 1/4-28
Stainless Steel Thin Hex Nut 1-4-28

DWG. #: P-014 | REV #:
SCALE: 8:1 | SIZE B | SHEET 1 OF 1

SOLIDWORKS Educational Product. For Instructional Use Only.
